mjpaul3/Portable-Plotter-Robot/README.md

# Portable-Plotter-Robot
ECE445 Project Team 34
