mjpaul3/Portable-Plotter-Robot/Notebooks/Sagnik Chakraborty/Sagnik3_notebook/src/entry_5.md

# Notebook Entry Lab 10/14/2024

## Objectives
- Order parts, get PCB design finalized

## Progress

#### 10/15 TA Meeting:
- We learned that multiple PCB orders are fine; we have enough time
- Target Round 1 hopefully
- Currently, we need to work on PCB
