mjpaul3/Portable-Plotter-Robot/Notebooks/Sagnik Chakraborty/Sagnik3_notebook/src/entry_7.md

# Notebook Entry Lab 10/28/2024

## Objectives
- order parts
- figma mockup of web board
- contact Gregg to get chassis done
- test motor

## Progress
- We received chassis from Gregg:

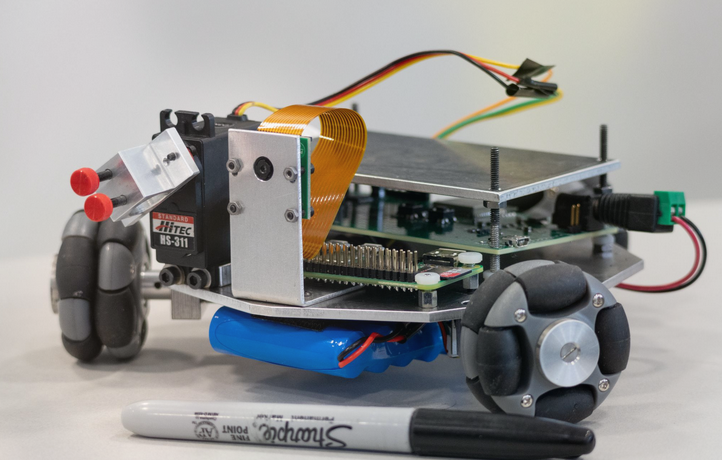
[picture p8: Notebooks/Sagnik Chakraborty/Sagnik3_notebook/src/image-7.png]


#### Next steps:
Get devboard work
