mjpaul3/Portable-Plotter-Robot/Notebooks/Sagnik Chakraborty/Sagnik3_notebook/src/chapter_1.md

# Notebook Entry Lab 9/20/2024

## Objectives
- Going to the machine shop, initial design to Gregg
- Understanding what kinds of motors we would need to use specifically
