mjpaul3/Portable-Plotter-Robot/Notebooks/Matthew Paul/Additional Assets/Aruco_distance_working.png

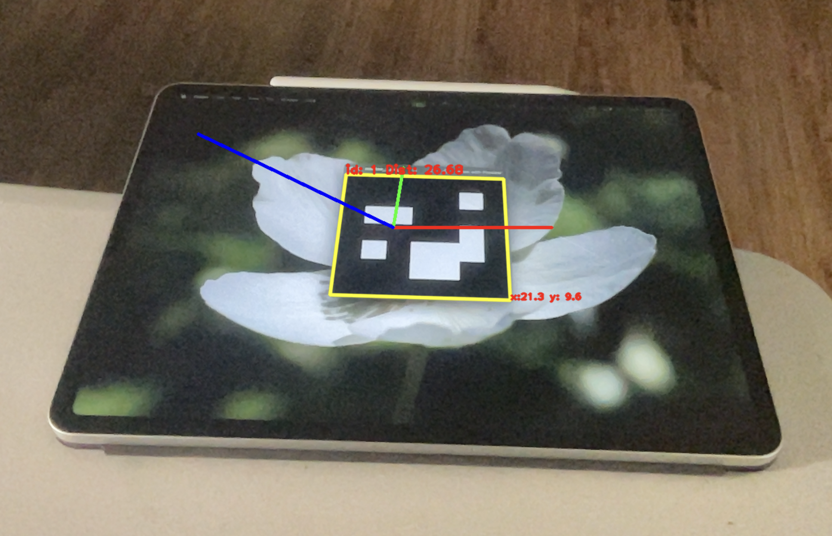
Notebooks/Matthew Paul/Additional Assets/Aruco_distance_working.png
