mjpaul3/Portable-Plotter-Robot/Notebooks/Matthew Paul/Additional Assets/Glitched_Camera.png

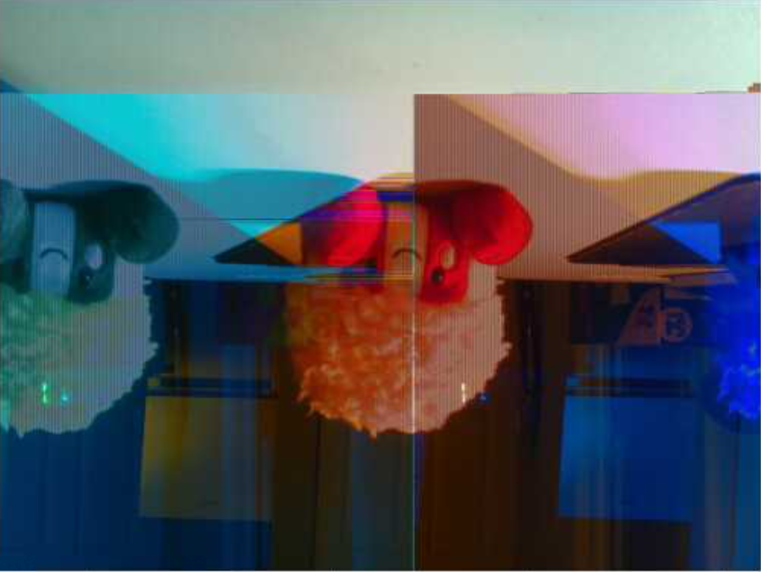
Notebooks/Matthew Paul/Additional Assets/Glitched_Camera.png
