mjpaul3/Portable-Plotter-Robot/Notebooks/Matthew Paul/Additional Assets/mechanical_1.jpg

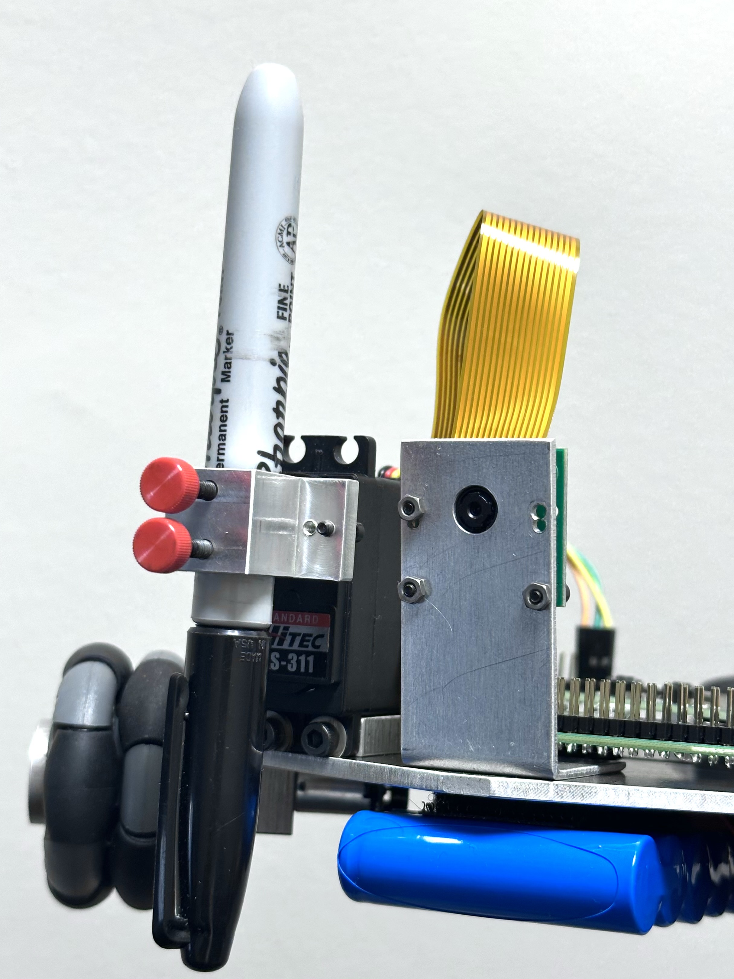
Notebooks/Matthew Paul/Additional Assets/mechanical_1.jpg
