mjpaul3/Portable-Plotter-Robot/Notebooks/Matthew Paul/Additional Assets/mechanical_2.jpg

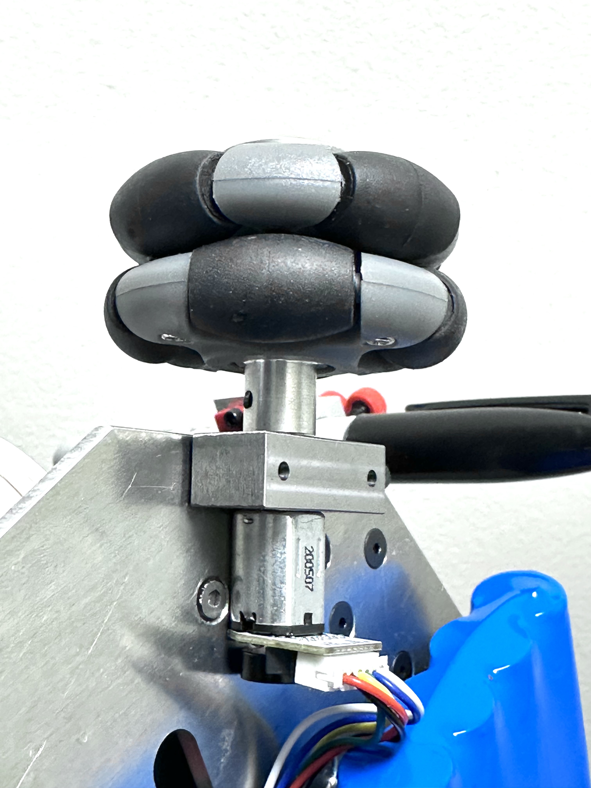
Notebooks/Matthew Paul/Additional Assets/mechanical_2.jpg
