mjpaul3/Portable-Plotter-Robot/Design Sources/Kicad Circuit and PCB Design/Imports/BMI323/BMI323.step

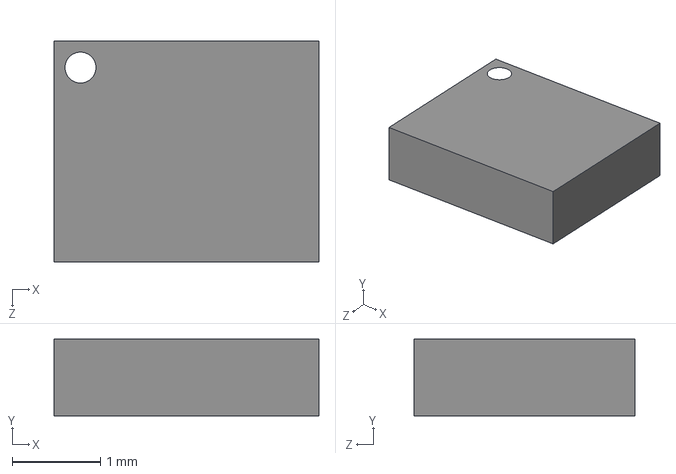
[picture p16: CAD file, 2024-12-12]
Design Sources/Kicad Circuit and PCB Design/Imports/BMI323/BMI323.step
3.00 x 0.87 x 2.50 mm
