mjpaul3/Portable-Plotter-Robot/Design Sources/Kicad Circuit and PCB Design/Imports/CP2102N_A02_GQFN28/CP2102N-A02-GQFN28.step

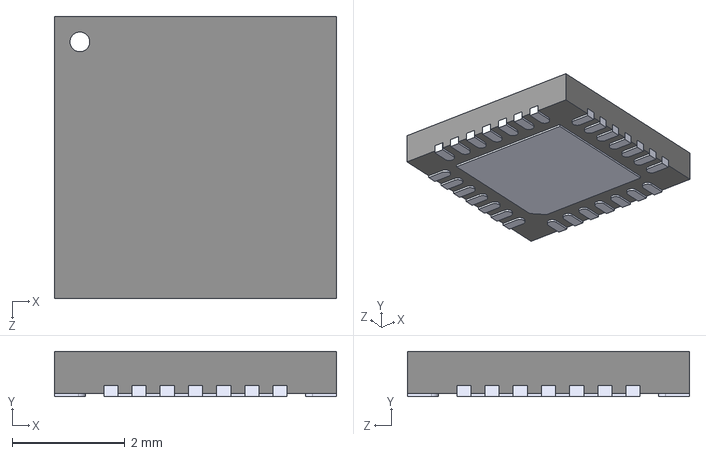
[picture p17: CAD file, 2024-12-12]
Design Sources/Kicad Circuit and PCB Design/Imports/CP2102N_A02_GQFN28/CP2102N-A02-GQFN28.step
5.00 x 0.8 x 5.00 mm
