mjpaul3/Portable-Plotter-Robot/Design Sources/Kicad Circuit and PCB Design/Imports/PJ_102AH/PJ-102AH.step

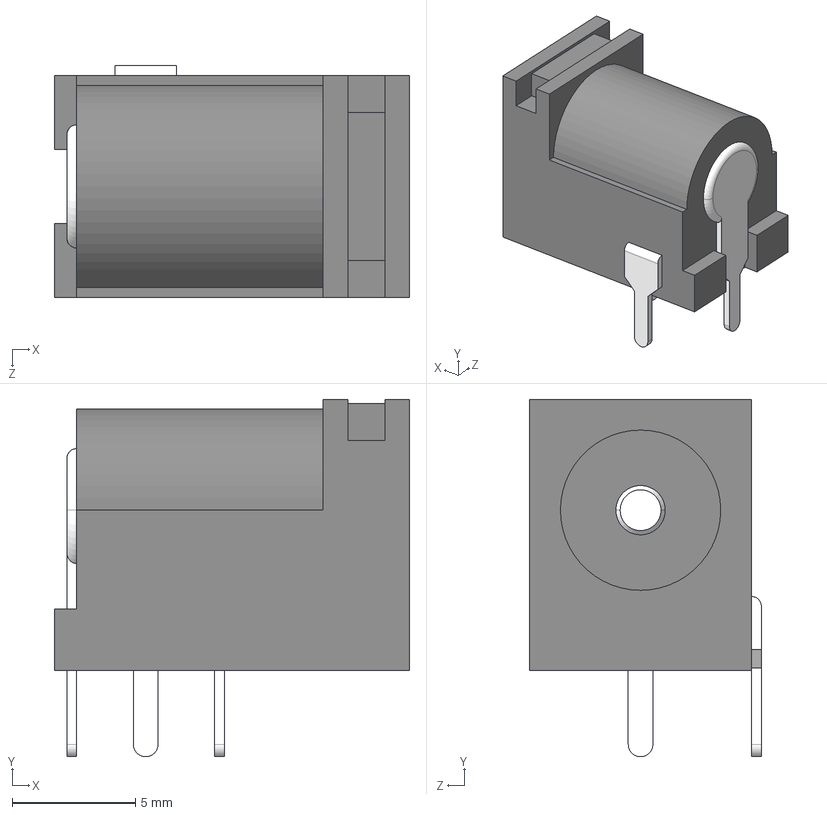
[picture p18: CAD file, 2024-12-12]
Design Sources/Kicad Circuit and PCB Design/Imports/PJ_102AH/PJ-102AH.step
14.4 x 14.5 x 9.40 mm
