mjpaul3/Portable-Plotter-Robot/Design Sources/Kicad Circuit and PCB Design/Imports/Through Hole Capacitor/860020672010/WCAP-ATG5_5X11.step

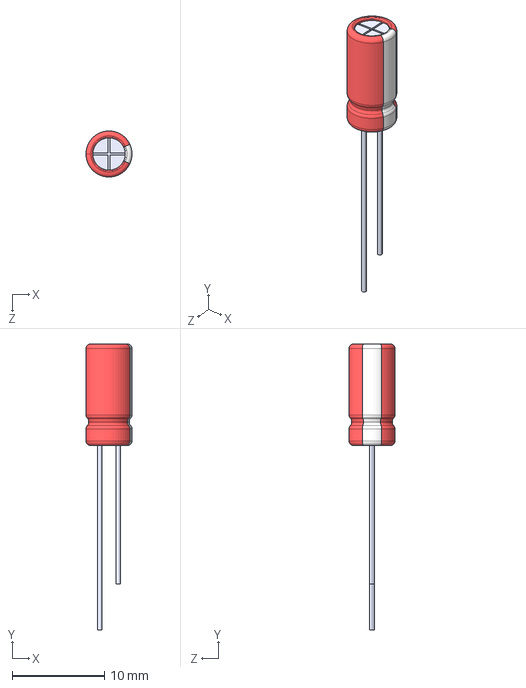
[picture p19: CAD file, 2024-12-12]
Design Sources/Kicad Circuit and PCB Design/Imports/Through Hole Capacitor/860020672010/WCAP-ATG5_5X11.step
5.00 x 31.0 x 5.00 mm
