mjpaul3/Portable-Plotter-Robot/Notebooks/Matthew Paul/Additional Assets/ECE445_plotter_robot_dimensions.pdf

## PCI

t | Battery

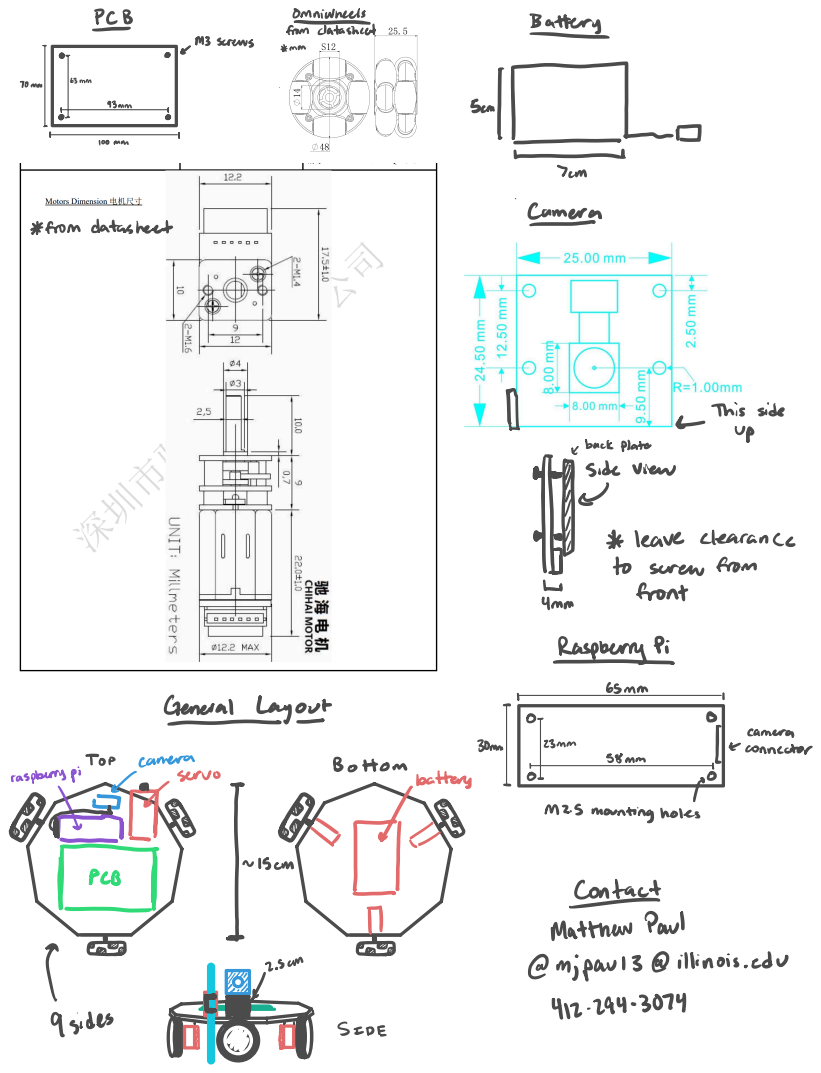
[picture p20: page 1]
M screws; lets ¹⁰⁰mm; This side up; Imm; front; Generally; Einer; raspberrypito Camesrvo; Bottom battery; m S mounting note B; risen; Intact; III; MatthewPaul; amjpaul3 illinois.edu; asides

Camera from datasheet

leave clearance
to screw from
