mjpaul3/Portable-Plotter-Robot/Notebooks/Matthew Paul/Additional Assets/Plotter_Rough_Schematic_v1.pdf

controlbox | faffffff

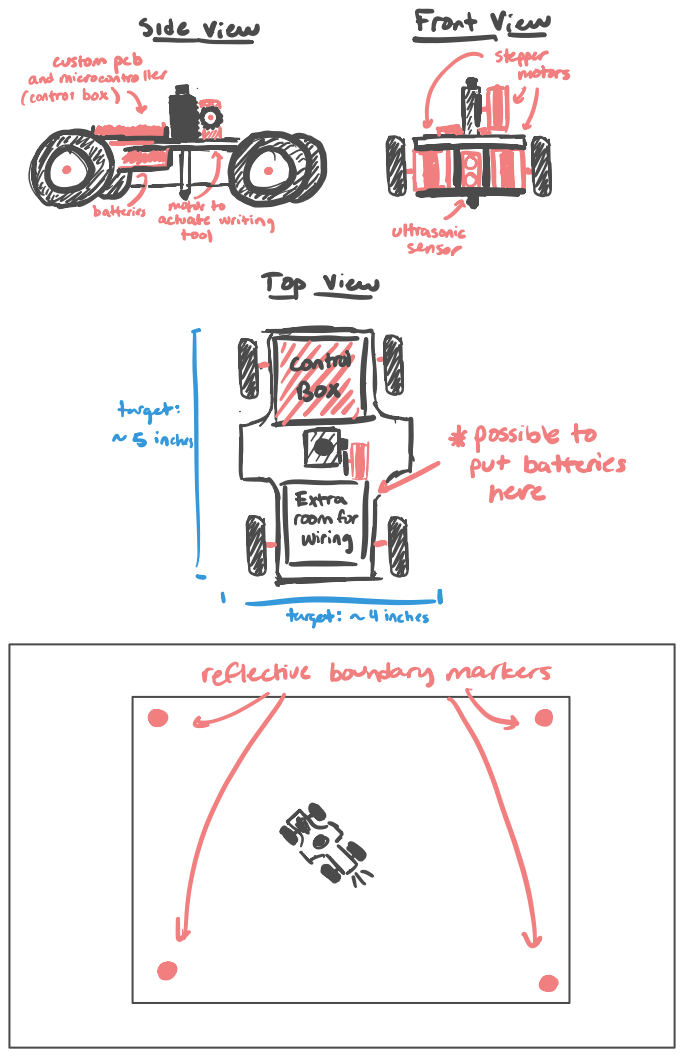
[picture p21: page 1]
sideries; twitter.info; andwm.fr; her; acififfwriting; ultrams; Iop View; 1 ff f itif; in put batteries here; tektites

ifII te i iti ffifoi.si statentiistith

ftp.ninches
reflective boundary markers
