mjpaul3/Portable-Plotter-Robot/Design Sources/Kicad Circuit and PCB Design/portable-plotter-robot.kicad_pcb

## KiCad design Design Sources/Kicad Circuit and PCB Design/portable-plotter-robot.kicad_pcb (2024-12-12)

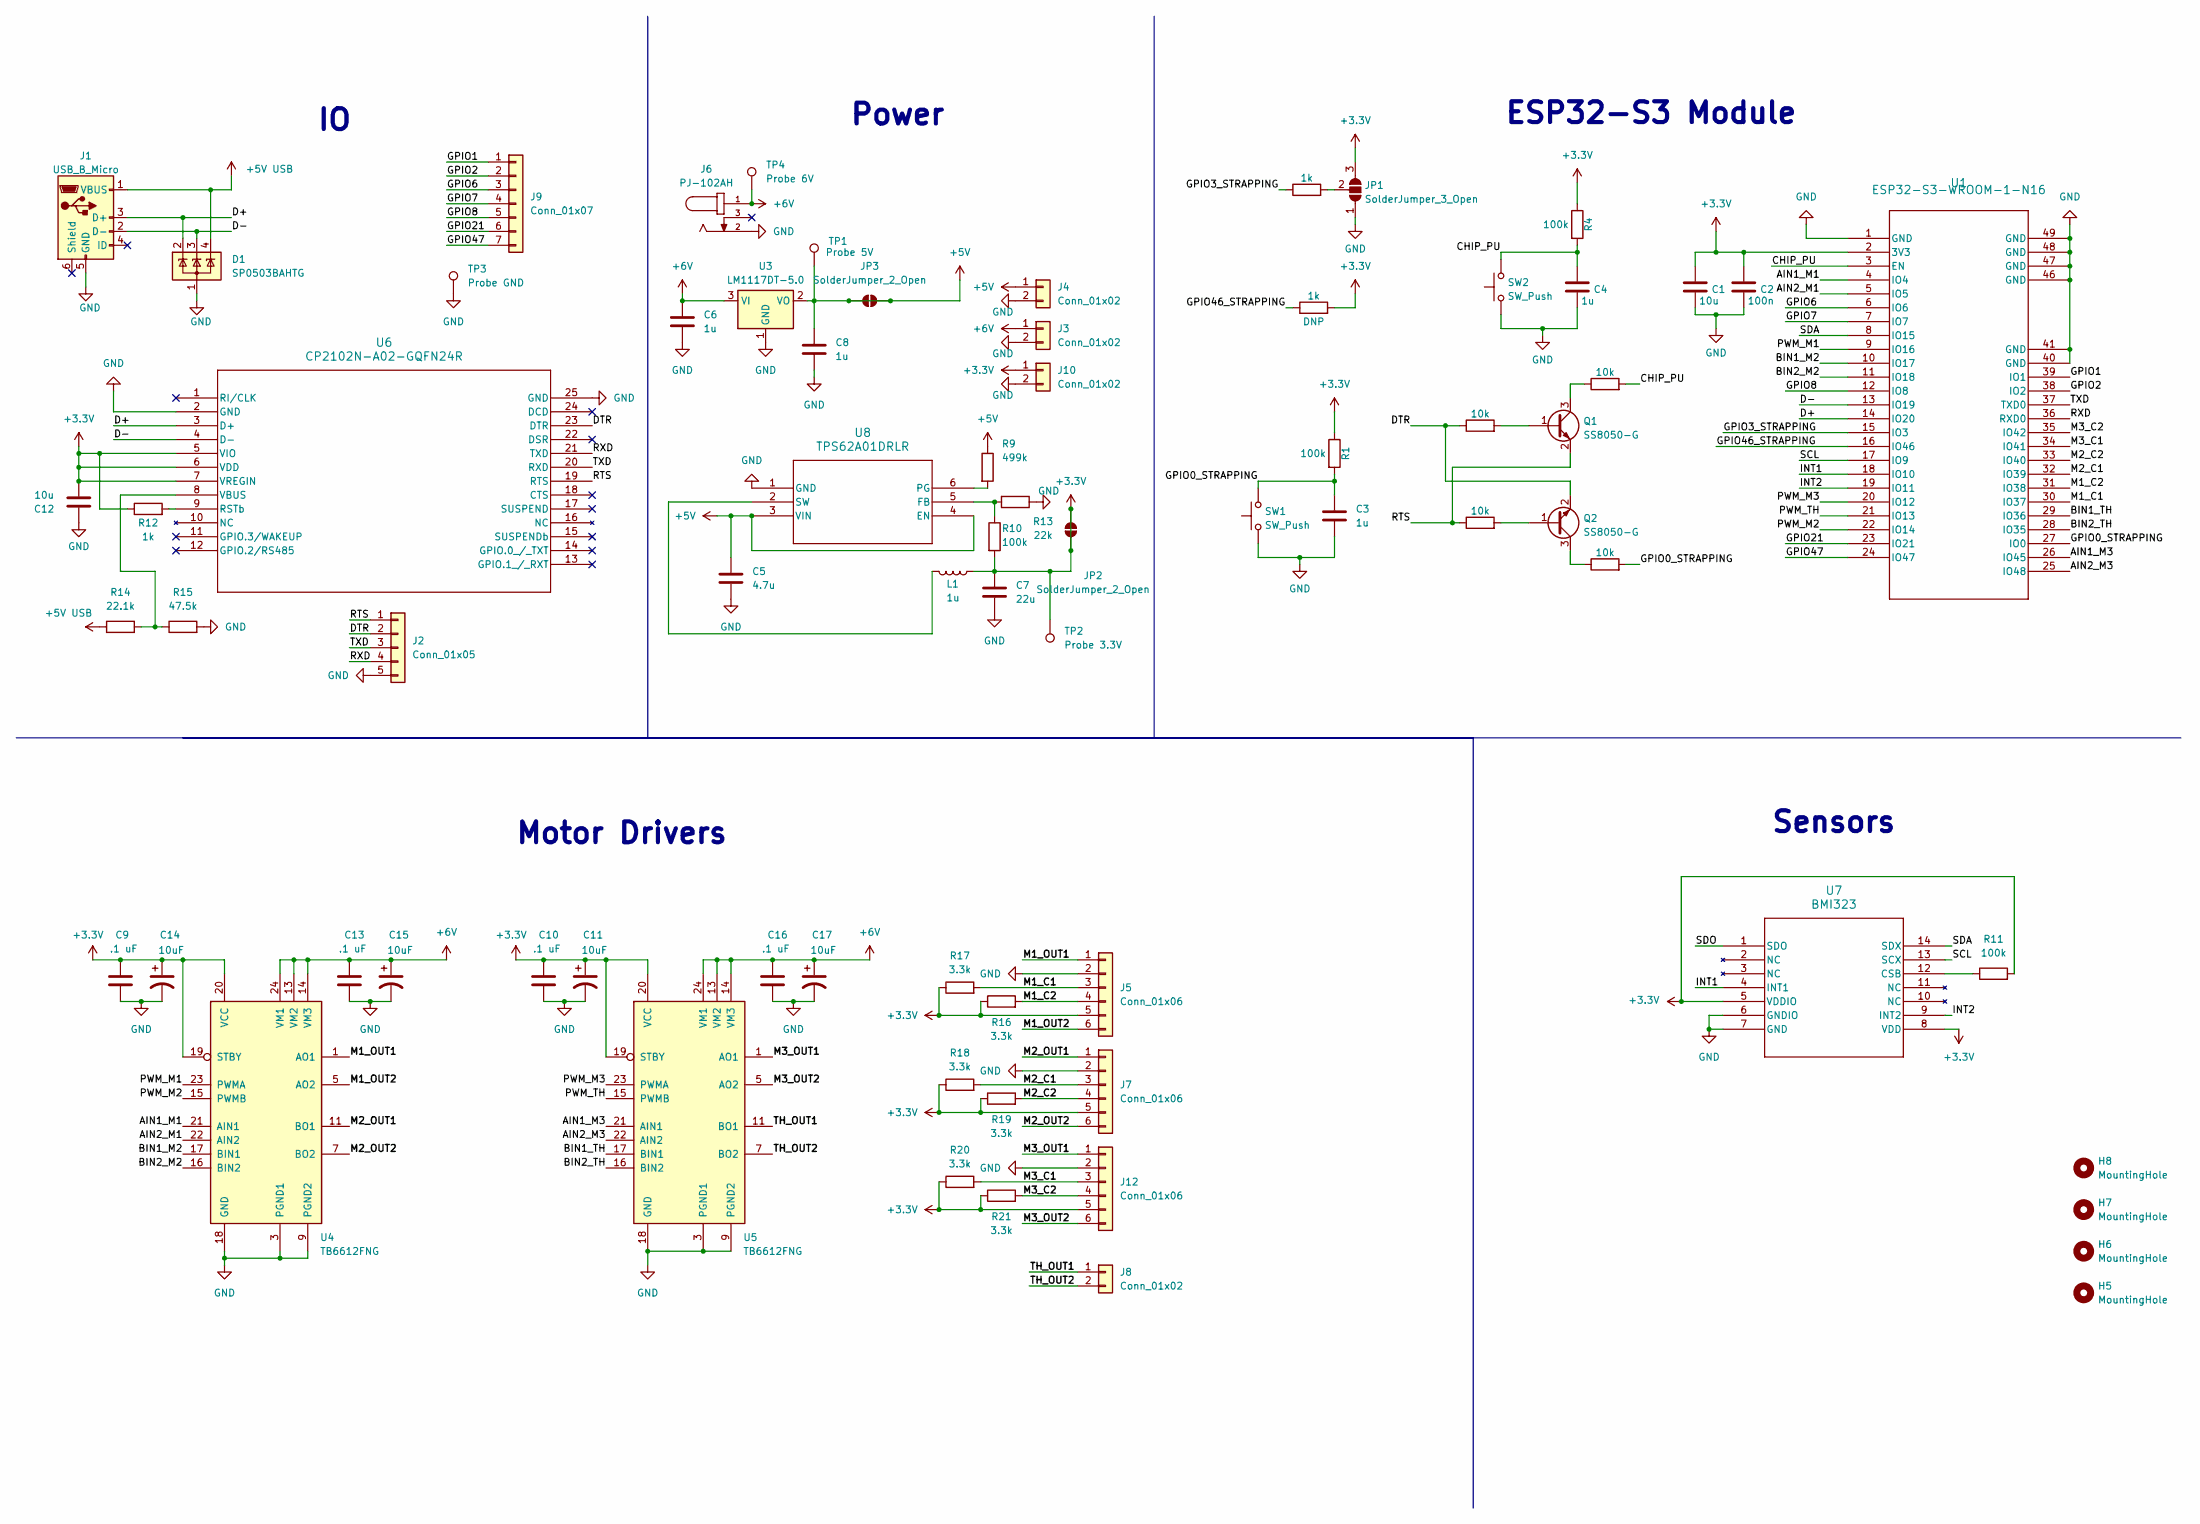
[picture p22: schematic portable-plotter-robot.kicad_sch, Portable Plotter Robot Circuit Schematic]

Parts:
C1, C12: 10u; C_0805_2012Metric_Pad1.18x1.45mm_HandSolder
C2: 100n; C_0805_2012Metric_Pad1.18x1.45mm_HandSolder
C3, C4, C6, C8: 1u; C_0805_2012Metric_Pad1.18x1.45mm_HandSolder
C5: 4.7u; C_0805_2012Metric_Pad1.18x1.45mm_HandSolder
C7: 22u; C_0805_2012Metric_Pad1.18x1.45mm_HandSolder
C9, C10, C13, C16: .1 uF; C_0805_2012Metric_Pad1.18x1.45mm_HandSolder
C11, C14, C15, C17: 10uF; CP_Radial_D5.0mm_P2.00mm
D1: SP0503BAHTG; SOT-143
H5, H6, H7, H8: MountingHole; MountingHole_3.2mm_M3
J1: USB_B_Micro; USB_Micro-B_Amphenol_10118194_Horizontal
J2: Conn_01x05; PinHeader_1x05_P2.54mm_Vertical
J3, J4, J8, J10: Conn_01x02; Molex_SL_171971-0002_1x02_P2.54mm_Vertical
J5, J7, J12: Conn_01x06; Molex_SL_171971-0006_1x06_P2.54mm_Vertical
J6: PJ-102AH; CUI_PJ-102AH; PART_REV 1.02
J9: Conn_01x07; PinHeader_1x07_P2.54mm_Vertical
JP1: SolderJumper_3_Open; SolderJumper-3_P1.3mm_Open_RoundedPad1.0x1.5mm
JP2, JP3: SolderJumper_2_Open; SolderJumper-2_P1.3mm_Open_RoundedPad1.0x1.5mm
L1: 1u; L_0805_2012Metric_Pad1.15x1.40mm_HandSolder
Q1, Q2: SS8050-G; SOT-23
R1, R4, R10, R11: 100k; R_0805_2012Metric_Pad1.20x1.40mm_HandSolder
R2, R3, R12: 1k; R_0805_2012Metric_Pad1.20x1.40mm_HandSolder
R5, R6, R7, R8: 10k; R_0805_2012Metric_Pad1.20x1.40mm_HandSolder
R9: 499k; R_0805_2012Metric_Pad1.20x1.40mm_HandSolder
R13: 22k; R_0805_2012Metric_Pad1.20x1.40mm_HandSolder
R14: 22.1k; R_0805_2012Metric_Pad1.20x1.40mm_HandSolder
R15: 47.5k; R_0805_2012Metric_Pad1.20x1.40mm_HandSolder
R16, R17, R18, R19, R20, R21: 3.3k; R_0805_2012Metric_Pad1.20x1.40mm_HandSolder
SW1, SW2: SW_Push; SW_Push_1P1T_NO_6x6mm_H9.5mm
TP1: Probe 5V; TestPoint_Plated_Hole_D2.0mm
TP2: Probe 3.3V; TestPoint_Plated_Hole_D2.0mm
TP3: Probe GND; TestPoint_Plated_Hole_D2.0mm
TP4: Probe 6V; TestPoint_Plated_Hole_D2.0mm
U1: ESP32-S3-WROOM-1-N16; ESP32-S3-WROOM-1_EXP
U3: LM1117DT-5.0; MP04A_TEX-M
U4, U5: TB6612FNG; SSOP-24_5.3x8.2mm_P0.65mm
U6: CP2102N-A02-GQFN24R; QFN24_SIL-M
U7: BMI323; XDCR_BMI270
U8: TPS62A01DRLR; SOT6_DRL_TEX-M

Connections:
+3.3V: C1.1, C2.1, C7.1, C9.1, C10.1, C11.1, C12.2, C14.1, J5.5, J7.5, J10.1, J12.5, JP1.3 (B), JP2.1 (A), JP2.2 (B), L1.1, R1.1, R3.2, R4.1, R10.2, R11.2, R12.1, R16.1, R17.1, R18.1, R19.1, R20.1, R21.1, TP2.1, U1.2 (3V3), U4.19 (STBY), U4.20 (VCC), U5.19 (STBY), U5.20 (VCC), U6.5 (VIO), U6.6 (VDD), U6.7 (VREGIN), U7.5 (VDDIO), U7.8 (VDD)
+5V: C5.1, C8.1, J4.1, JP3.1 (A), JP3.2 (B), R9.1, TP1.1, U3.2 (VO), U8.3 (VIN), U8.4 (EN)
+5V USB: D1.4 (K), J1.1 (VBUS), R14.1
+6V: C6.1, C13.1, C15.1, C16.1, C17.1, J3.1, J6.1, TP4.1, U3.3 (VI), U4.13 (VM2), U4.14 (VM3), U4.24 (VM1), U5.13 (VM2), U5.14 (VM3), U5.24 (VM1)
/AIN1_M1: U1.4 (IO4), U4.21 (AIN1)
/AIN1_M3: U1.26 (IO45), U5.21 (AIN1)
/AIN2_M1: U1.5 (IO5), U4.22 (AIN2)
/AIN2_M3: U1.25 (IO48), U5.22 (AIN2)
/BIN1_M2: U1.10 (IO17), U4.17 (BIN1)
/BIN1_TH: U1.29 (IO36), U5.17 (BIN1)
/BIN2_M2: U1.11 (IO18), U4.16 (BIN2)
/BIN2_TH: U1.28 (IO35), U5.16 (BIN2)
/CHIP_PU: C4.1, R4.2, R7.2, SW2.2, U1.3 (EN)
/D+: D1.2 (K), J1.3 (D+), U1.14 (IO20), U6.3 (D+)
/D-: D1.3 (K), J1.2 (D-), U1.13 (IO19), U6.4 (D-)
/DTR: J2.2, Q2.2 (E), R5.1, U6.23 (DTR)
/GPIO0_STRAPPING: C3.1, R1.2, R8.2, SW1.2, U1.27 (IO0)
/GPIO1: J9.1, U1.39 (IO1)
/GPIO2: J9.2, U1.38 (IO2)
/GPIO3_STRAPPING: R2.1, U1.15 (IO3)
/GPIO6: J9.3, U1.6 (IO6)
/GPIO7: J9.4, U1.7 (IO7)
/GPIO8: J9.5, U1.12 (IO8)
/GPIO21: J9.6, U1.23 (IO21)
/GPIO46_STRAPPING: R3.1, U1.16 (IO46)
/GPIO47: J9.7, U1.24 (IO47)
/INT1: U1.18 (IO10), U7.4 (INT1)
/INT2: U1.19 (IO11), U7.9 (INT2)
/M1_C1: J5.3, R17.2, U1.30 (IO37)
/M1_C2: J5.4, R16.2, U1.31 (IO38)
/M1_OUT1: J5.1, U4.1 (AO1), U4.2 (AO1)
/M1_OUT2: J5.6, U4.5 (AO2), U4.6 (AO2)
/M2_C1: J7.3, R18.2, U1.32 (IO39)
/M2_C2: J7.4, R19.2, U1.33 (IO40)
/M2_OUT1: J7.1, U4.11 (BO1), U4.12 (BO1)
/M2_OUT2: J7.6, U4.7 (BO2), U4.8 (BO2)
/M3_C1: J12.3, R20.2, U1.34 (IO41)
/M3_C2: J12.4, R21.2, U1.35 (IO42)
/M3_OUT1: J12.1, U5.1 (AO1), U5.2 (AO1)
/M3_OUT2: J12.6, U5.5 (AO2), U5.6 (AO2)
/PWM_M1: U1.9 (IO16), U4.23 (PWMA)
/PWM_M2: U1.22 (IO14), U4.15 (PWMB)
/PWM_M3: U1.20 (IO12), U5.23 (PWMA)
/PWM_TH: U1.21 (IO13), U5.15 (PWMB)
/RTS: J2.1, Q1.2 (E), R6.1, U6.19 (RTS)
/RXD: J2.4, U1.36 (RXD0), U6.21 (TXD)
/SCL: U1.17 (IO9), U7.13 (SCX)
/SDA: U1.8 (IO15), U7.14 (SDX)
/SDO: U7.1 (SDO)
/TH_OUT1: J8.1, U5.11 (BO1), U5.12 (BO1)
/TH_OUT2: J8.2, U5.7 (BO2), U5.8 (BO2)
/TXD: J2.3, U1.37 (TXD0), U6.20 (RXD)
GND: C1.2, C2.2, C3.2, C4.2, C5.2, C6.2, C7.2, C8.2, C9.2, C10.2, C11.2, C12.1, C13.2, C14.2, C15.2, C16.2, C17.2, D1.1 (A), J1.5 (GND), J2.5, J3.2, J4.2, J5.2, J6.2, J7.2, J10.2, J12.2, JP1.1 (A), R13.1, R15.2, SW1.1, SW2.1, TP3.1, U1.1 (GND), U1.40 (GND), U1.41 (GND), U1.46 (GND), U1.47 (GND), U1.48 (GND), U1.49 (GND), U3.1 (GND), U4.3 (PGND1), U4.4 (PGND1), U4.9 (PGND2), U4.10 (PGND2), U4.18 (GND), U5.3 (PGND1), U5.4 (PGND1), U5.9 (PGND2), U5.10 (PGND2), U5.18 (GND), U6.2 (GND), U6.25 (GND), U7.6 (GNDIO), U7.7 (GND), U8.1 (GND)
unnamed: JP1.2 (C), R2.2
unnamed: Q1.1 (B), R5.2
unnamed: Q1.3 (C), R7.1
unnamed: Q2.1 (B), R6.2
unnamed: Q2.3 (C), R8.1
unnamed: R12.2, U6.9 (RSTb)
unnamed: R14.2, R15.1, U6.8 (VBUS)
unnamed: R11.1, U7.12 (CSB)
unnamed: R10.1, R13.2, U8.5 (FB)
unnamed: R9.2, U8.6 (PG)
unnamed: L1.2, U8.2 (SW)

Notes on the sheet:
Power
Sensors
Motor Drivers
ESP32-S3 Module

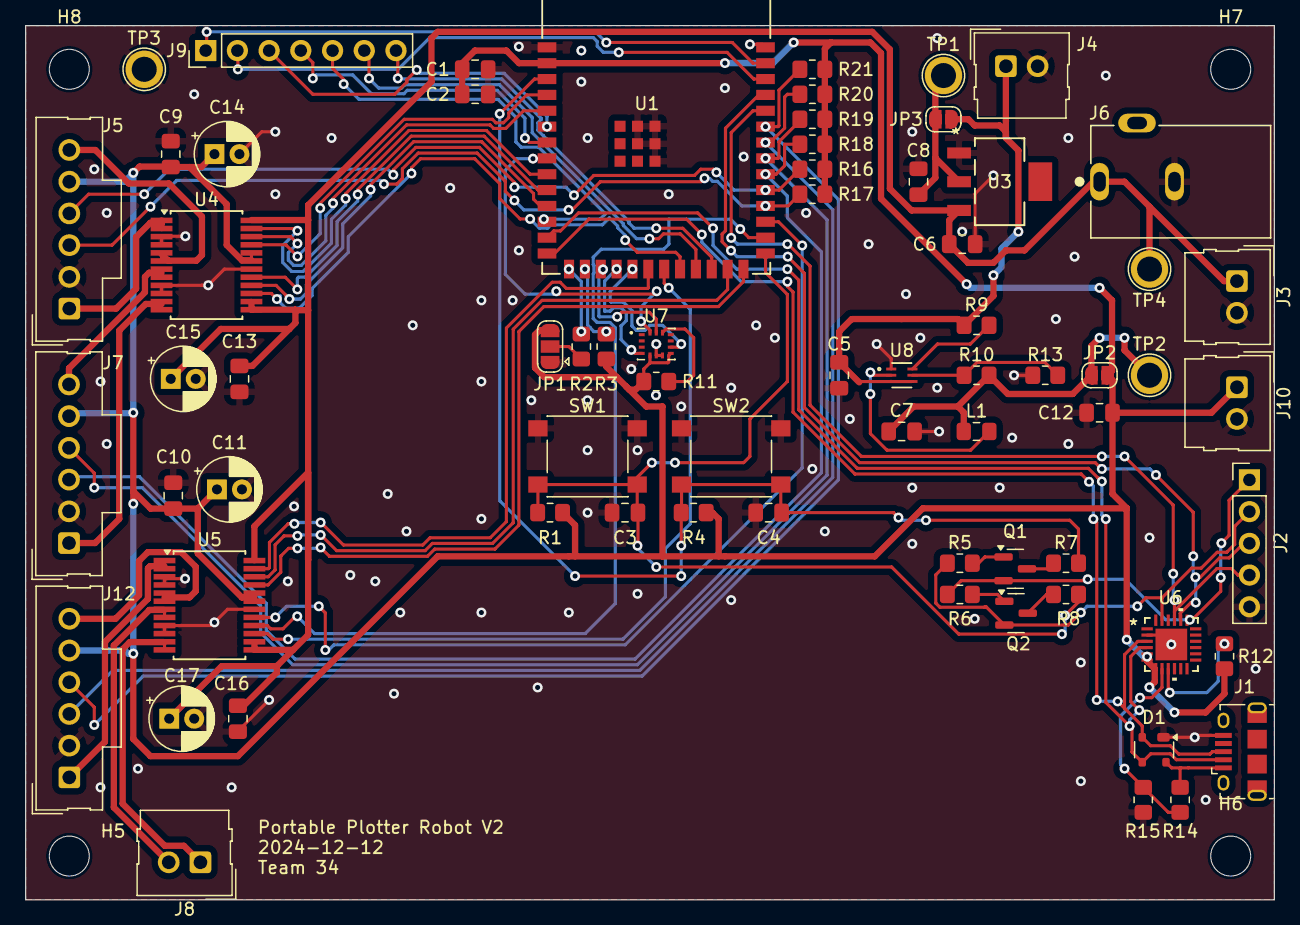
[picture p23: board portable-plotter-robot.kicad_pcb from above]

Board: 2 copper layers, 100.0 x 70.0 mm, 73 parts (0 on the bottom side), 63 nets.
