mjpaul3/Portable-Plotter-Robot/Notebooks/Sagnik Chakraborty/Sagnik3_notebook/book/searchindex.js

Object.assign(window.search, {"doc_urls":["entry_1.html#notebook-entry-lab-week-of-9162024","entry_1.html#objectives","entry_1.html#progress","entry_1.html#ta-meeting-917","entry_2.html#notebook-entry-lab-9232024","entry_2.html#objectives","entry_2.html#progress","entry_3.html#notebook-entry-lab-9302024","entry_3.html#objectives","entry_3.html#progress","entry_3.html#ta-meeting-101","entry_3.html#103-schedule-fixing","entry_4.html#notebook-entry-lab-10072024","entry_4.html#objectives","entry_4.html#progress","entry_4.html#next-steps","entry_5.html#notebook-entry-lab-10142024","entry_5.html#objectives","entry_5.html#progress","entry_6.html#notebook-entry-lab-10212024","entry_6.html#objectives","entry_6.html#progress","entry_6.html#next-steps","entry_7.html#notebook-entry-lab-10282024","entry_7.html#objectives","entry_7.html#progress","entry_8.html#notebook-entry-lab-110424","entry_8.html#objectives","entry_8.html#progress","entry_8.html#next-steps","entry_9.html#notebook-entry-lab-111124","entry_9.html#objectives","entry_9.html#progress","entry_9.html#next-steps","entry_10.html#notebook-entry-lab-111824","entry_10.html#objectives","entry_10.html#progress","entry_10.html#code-explanation","entry_10.html#observations","entry_10.html#debugging-and-improvements","entry_10.html#future-steps","entry_11.html#notebook-entry-lab-112524","entry_11.html#objectives","entry_11.html#progress","entry_11.html#kinematics-model","entry_11.html#pid-model","entry_11.html#mathematical-breakdown","entry_11.html#issue","entry_12.html#notebook-entry-lab-120224","entry_12.html#objectives","entry_12.html#progress","entry_12.html#additional-notes-for-debugging","entry_12.html#issues"],"index":{"documentStore":{"docInfo":{"0":{"body":0,"breadcrumbs":9,"title":5},"1":{"body":11,"breadcrumbs":5,"title":1},"10":{"body":39,"breadcrumbs":7,"title":3},"11":{"body":20,"breadcrumbs":7,"title":3},"12":{"body":0,"breadcrumbs":8,"title":4},"13":{"body":14,"breadcrumbs":5,"title":1},"14":{"body":115,"breadcrumbs":5,"title":1},"15":{"body":19,"breadcrumbs":6,"title":2},"16":{"body":0,"breadcrumbs":8,"title":4},"17":{"body":5,"breadcrumbs":5,"title":1},"18":{"body":18,"breadcrumbs":5,"title":1},"19":{"body":0,"breadcrumbs":8,"title":4},"2":{"body":39,"breadcrumbs":5,"title":1},"20":{"body":32,"breadcrumbs":5,"title":1},"21":{"body":176,"breadcrumbs":5,"title":1},"22":{"body":28,"breadcrumbs":6,"title":2},"23":{"body":0,"breadcrumbs":8,"title":4},"24":{"body":12,"breadcrumbs":5,"title":1},"25":{"body":9,"breadcrumbs":5,"title":1},"26":{"body":0,"breadcrumbs":8,"title":4},"27":{"body":11,"breadcrumbs":5,"title":1},"28":{"body":72,"breadcrumbs":5,"title":1},"29":{"body":22,"breadcrumbs":6,"title":2},"3":{"body":148,"breadcrumbs":7,"title":3},"30":{"body":0,"breadcrumbs":8,"title":4},"31":{"body":27,"breadcrumbs":5,"title":1},"32":{"body":136,"breadcrumbs":5,"title":1},"33":{"body":24,"breadcrumbs":6,"title":2},"34":{"body":0,"breadcrumbs":8,"title":4},"35":{"body":20,"breadcrumbs":5,"title":1},"36":{"body":26,"breadcrumbs":5,"title":1},"37":{"body":189,"breadcrumbs":6,"title":2},"38":{"body":32,"breadcrumbs":5,"title":1},"39":{"body":48,"breadcrumbs":6,"title":2},"4":{"body":0,"breadcrumbs":8,"title":4},"40":{"body":19,"breadcrumbs":6,"title":2},"41":{"body":0,"breadcrumbs":8,"title":4},"42":{"body":5,"breadcrumbs":5,"title":1},"43":{"body":0,"breadcrumbs":5,"title":1},"44":{"body":67,"breadcrumbs":6,"title":2},"45":{"body":61,"breadcrumbs":6,"title":2},"46":{"body":55,"breadcrumbs":6,"title":2},"47":{"body":22,"breadcrumbs":5,"title":1},"48":{"body":0,"breadcrumbs":8,"title":4},"49":{"body":18,"breadcrumbs":5,"title":1},"5":{"body":11,"breadcrumbs":5,"title":1},"50":{"body":225,"breadcrumbs":5,"title":1},"51":{"body":45,"breadcrumbs":7,"title":3},"52":{"body":26,"breadcrumbs":5,"title":1},"6":{"body":59,"breadcrumbs":5,"title":1},"7":{"body":0,"breadcrumbs":8,"title":4},"8":{"body":9,"breadcrumbs":5,"title":1},"9":{"body":38,"breadcrumbs":5,"title":1}},"docs":{"0":{"body":"","breadcrumbs":"Entry 1 - Week of 9/16/24 » Notebook Entry Lab Week of 9/16/2024","id":"0","title":"Notebook Entry Lab Week of 9/16/2024"},"1":{"body":"First TA meeting with dongming Went over our project proposal, what to include in design review1","breadcrumbs":"Entry 1 - Week of 9/16/24 » Objectives","id":"1","title":"Objectives"},"10":{"body":"Main deadline is to sign up for peer review by tomorrow (10/2) Requirements/Values not specified sufficiently yet, so we needed to fix that Our current schematic model wasn't enough, so we needed to specify more; for instance, our IO interface wasn't properly addressed and we didn't attach the correct footprint yet: alt text Main todo: create slideshow for design review","breadcrumbs":"Entry 3 - Week of 9/30/24 » TA meeting 10/1","id":"10","title":"TA meeting 10/1"},"11":{"body":"All we did here was fix out our schedule that we will use; this was mainly to brainstorm our workflow We added details to design doc Understand software testing/debugging workflow; here I decided that we will use PID","breadcrumbs":"Entry 3 - Week of 9/30/24 » 10/3: Schedule fixing","id":"11","title":"10/3: Schedule fixing"},"12":{"body":"","breadcrumbs":"Entry 4 - Week of 10/07/24 » Notebook Entry Lab 10/07/2024","id":"12","title":"Notebook Entry Lab 10/07/2024"},"13":{"body":"Begin PCB design calculations for PCB review. Perform power analytics calculations to ensure all subsystems are properly powered.","breadcrumbs":"Entry 4 - Week of 10/07/24 » Objectives","id":"13","title":"Objectives"},"14":{"body":"10/11 meeting: PCB Design Calculations : Reviewed the application circuit for the TPS62140DCLR voltage regulator. Calculated resistor divider values (R1 and R2) to achieve an output voltage (Vout) of 3.3V. Used the formula: Vout=1.2×(1+R1R2) Result: R1=100kΩ R2=450kΩ Verified that the selected capacitor values meet the TPS62140DCLR's application guidelines. Power Subsystem Analysis : Measured current requirements for each subsystem: ESP32 : 300mA. Plotter Car Control Subsystem : 500mA. Motor Subsystem : Calculated based on servo and DC motor driver requirements. Ensured the battery and voltage regulator could supply sufficient current for all subsystems under peak load conditions. Updated Block Diagram : Created a detailed block diagram to map the power flow and subsystem interconnections. Incorporated feedback from previous TA meetings to ensure all connections were labeled clearly. Component Placement Considerations : Added a C3 optional capacitor to reduce noise in the power line. Verified placement for efficient routing of power and signal lines, especially for the ESP32 and motor drivers.","breadcrumbs":"Entry 4 - Week of 10/07/24 » Progress","id":"14","title":"Progress"},"15":{"body":"Finalize the PCB layout for review, focusing on minimizing noise and ensuring reliable connections. Simulate the power system under various loads to confirm voltage stability.","breadcrumbs":"Entry 4 - Week of 10/07/24 » Next Steps","id":"15","title":"Next Steps"},"16":{"body":"","breadcrumbs":"Entry 5 - Week of 10/14/24 » Notebook Entry Lab 10/14/2024","id":"16","title":"Notebook Entry Lab 10/14/2024"},"17":{"body":"Order parts, get PCB design finalized","breadcrumbs":"Entry 5 - Week of 10/14/24 » Objectives","id":"17","title":"Objectives"},"18":{"body":"10/15 TA Meeting: We learned that multiple PCB orders are fine; we have enough time Target Round 1 hopefully Currently, we need to work on PCB","breadcrumbs":"Entry 5 - Week of 10/14/24 » Progress","id":"18","title":"Progress"},"19":{"body":"","breadcrumbs":"Entry 6 - Week of 10/21/24 » Notebook Entry Lab 10/21/2024","id":"19","title":"Notebook Entry Lab 10/21/2024"},"2":{"body":"Discussed initial project ideas and received feedback on scope and feasibility. Noted requirements for the design review presentation, including subsystem specifications and tolerance analysis. We also started on figuring out final design templates so that next week we can talk it over with Gregg This was the block diagram we used (courtesy of my partner mjpaul3) for discussion this week: alt text","breadcrumbs":"Entry 1 - Week of 9/16/24 » Progress","id":"2","title":"Progress"},"20":{"body":"Count and finalize components for ordering, including resistors, capacitors, and inductors. Prepare the PCB design with necessary footprints for all components. Begin testing motor drivers and Raspberry Pi camera functionality. Develop and refine the ESP32 Wi-Fi interface and connections for edge-of-board placement.","breadcrumbs":"Entry 6 - Week of 10/21/24 » Objectives","id":"20","title":"Objectives"},"21":{"body":"Component Selection for PCB : Identified required values for resistors, capacitors, and inductors: Capacitors: 10μF, 1μF, 4.7μF, 27μF, 180μF. Resistors: 22Ω, 100kΩ, 49.9kΩ, 1kΩ, 10kΩ. Inductors: 1μH. Included electrolytic capacitors for critical filtering applications, particularly 10μF. PCB Preparation : Reviewed the placement of IO, power, ESP32, motor drivers, and sensors on the PCB layout. Noted pin configurations to optimize edge-of-board connectivity and simplify wiring during assembly. Exported necessary component footprints for use in PCB design software. From TA 10/22 meeting: PCB V1 seemed good; it's just that the PCB footprint had the ESP32 wifi antennae on board; this might cause issues Motor Driver Testing : Began testing the motor drivers using the ESP32. Confirmed basic operation with servo motors. Encountered minor issues with pin connections, which were resolved during setup. Raspberry Pi Camera Testing : Tested the Raspberry Pi camera for position data integration. Results were satisfactory, with clear image captures and reliable interfacing. Ensured compatibility with IMU for future position data calculations. ESP32 Wi-Fi Interface : Started developing the ESP32 Wi-Fi interface, focusing on stability for communication with the web app. Ensured basic functionality to handle commands such as shape selection. Planning for Next Week : Outlined steps for Week 10/27: Finalize ordering of components. Develop a web board mockup. Continue testing motors and their integration with the ESP32. Work on programming ESP32 for advanced motor functions and servo tool control.","breadcrumbs":"Entry 6 - Week of 10/21/24 » Progress","id":"21","title":"Progress"},"22":{"body":"Complete the PCB layout and simulate the power subsystem to ensure stability under load. Continue testing the motor drivers and refine motor control algorithms. Work on integrating the Raspberry Pi camera with the web app for position data feedback.","breadcrumbs":"Entry 6 - Week of 10/21/24 » Next Steps","id":"22","title":"Next Steps"},"23":{"body":"","breadcrumbs":"Entry 7 - Week of 10/28/24 » Notebook Entry Lab 10/28/2024","id":"23","title":"Notebook Entry Lab 10/28/2024"},"24":{"body":"order parts figma mockup of web board contact Gregg to get chassis done test motor","breadcrumbs":"Entry 7 - Week of 10/28/24 » Objectives","id":"24","title":"Objectives"},"25":{"body":"We received chassis from Gregg: alt text Next steps: Get devboard work","breadcrumbs":"Entry 7 - Week of 10/28/24 » Progress","id":"25","title":"Progress"},"26":{"body":"","breadcrumbs":"Entry 8 - Week of 11/04/24 » Notebook Entry Lab 11/04/24","id":"26","title":"Notebook Entry Lab 11/04/24"},"27":{"body":"Address feedback on PCB design. Make necessary changes to improve the PCB layout and functionality.","breadcrumbs":"Entry 8 - Week of 11/04/24 » Objectives","id":"27","title":"Objectives"},"28":{"body":"The following changes were made to the PCB design based on feedback received: Moved the ESP32 to the edge of the board to facilitate easier connections. Corrected the footprint for the 6-5V power supply and UART bridge . Added power connections for the Raspberry Pi . Included test points on the PCB for debugging and monitoring. Added encoder connections for the motors to support precise feedback. Ordered additional buttons for control purposes. Exported pins for the ESP32 and UART for extended connectivity. Added Raspberry Pi GPIO pins to support interfacing. alt text These changes ensure that the PCB layout supports all system components effectively and meets the design requirements.","breadcrumbs":"Entry 8 - Week of 11/04/24 » Progress","id":"28","title":"Progress"},"29":{"body":"Begin testing the updated PCB with connected components. Verify the functionality of the newly added encoder connections and Raspberry Pi GPIO pins. Ensure that all exported pins are accessible and working as intended.","breadcrumbs":"Entry 8 - Week of 11/04/24 » Next Steps","id":"29","title":"Next Steps"},"3":{"body":"During the TA meeting, the following feedback and action items were discussed for the design document: Design Document Feedback: Clearly labeled the problem and solution sections for better clarity. Added visual aids and ensured the overall design was presented at a high level . Updated the block diagram : Labeled all lines properly to indicate signal flow. Used appropriate software tools to create a clean and professional diagram. Provided a subsystem overview , detailing each component's role. Outlined subsystem requirements to meet functional and performance goals. Tolerance Analysis: Included proof of design tolerances : Calculated motor torque requirements to handle the expected load. Verified the battery's capacity to ensure sufficient power for the system. Conducted directional calculations to ensure the robot's motion is within the desired limits. Ethics and Safety: Documented potential safety concerns and proposed mitigation strategies. Compiled a reference page with citations for all sources used in the design. Examples for Reference: Used SP 2024 Team 19's TA Feedback and FA 2023 Team 3's Design Document as examples of strong documentation. Next Steps Finalize updates to the block diagram and integrate them into the design document. Conduct additional testing to validate motor torque and battery capacity calculations. Prepare the design document for the next TA review session.","breadcrumbs":"Entry 1 - Week of 9/16/24 » TA meeting 9/17","id":"3","title":"TA meeting 9/17"},"30":{"body":"","breadcrumbs":"Entry 9 - Week of 11/11/24 » Notebook Entry Lab 11/11/24","id":"30","title":"Notebook Entry Lab 11/11/24"},"31":{"body":"Finalize motor identification and connections for the control system. Update the parts list with the required capacitors, resistors, and inductors for PCB design. Review and refine the general layout of the robot components, including battery, Raspberry Pi, and servo placement.","breadcrumbs":"Entry 9 - Week of 11/11/24 » Objectives","id":"31","title":"Objectives"},"32":{"body":"Motor Identification and Wiring : Identified motor pins and their corresponding connections: OUT1, OUT2, and OUT3 mapped to motor output pins. CF1 and CF2 for current feedback. 3.3V and GND for power. Verified the PWM signals from the controller and reviewed the output waveform for consistency with the desired motor behavior. Updated Parts List : Capacitors (C): 10μF, 1μF, 4.7μF, 21μF. Resistors (R): 1kΩ, 22.1kΩ, 47.5kΩ, 494kΩ, 100kΩ, 10kΩ, 3.3kΩ. Inductors (L): 1μH. Verified counts and confirmed all necessary components are available for assembly. Component Layout : Completed a detailed layout of the robot: General layout includes the top and bottom placements. Raspberry Pi mounted at the top alongside the servo for camera movement. PCB and battery located at the bottom for weight distribution. Ensured all components are securely mounted with proper clearance for screws and accessibility. (diagrams courtesy of partner mjpaul3) alt text alt text Design Dimensions : Referenced motor dimensions and wheel configurations directly from the datasheets. Integrated omniwheels and servo clearances into the layout to ensure smooth operation. Battery and Power Connections : Finalized the battery placement and connections. Ensured compatibility with power regulators and designed for easy accessibility during operation.","breadcrumbs":"Entry 9 - Week of 11/11/24 » Progress","id":"32","title":"Progress"},"33":{"body":"Test the motor drivers and PWM control to confirm functionality with the updated connections. Begin assembling the robot with the finalized layout and components. Simulate and verify power stability across all subsystems before moving to integrated testing.","breadcrumbs":"Entry 9 - Week of 11/11/24 » Next Steps","id":"33","title":"Next Steps"},"34":{"body":"","breadcrumbs":"Entry 10 - Week of 11/18/24 » Notebook Entry Lab 11/18/24","id":"34","title":"Notebook Entry Lab 11/18/24"},"35":{"body":"Set up a test bench on the development board for basic servo motor control code. Verify the functionality of servo motor control using PWM signals with an ESP32.","breadcrumbs":"Entry 10 - Week of 11/18/24 » Objectives","id":"35","title":"Objectives"},"36":{"body":"This week, I focused on implementing and testing servo motor control using an ESP32 development board. The servo was controlled through a PWM signal configured with a 50Hz frequency and 14-bit resolution. Below are the key components of the implementation:","breadcrumbs":"Entry 10 - Week of 11/18/24 » Progress","id":"36","title":"Progress"},"37":{"body":"1. Pin Configuration The servo was connected to GPIO 13. Additionally, GPIOs 36, 35, and 1 were set to always output HIGH to stabilize auxiliary components. // Pin definitions\n#define SERVO_PIN 13\n#define SERVO_HIGH_1 36\n#define SERVO_HIGH_2 35\n#define GPIO_HIGH_1 1 2. PWM Timer Configuration A PWM signal with a frequency of 50Hz (20ms period) was used to control the servo motor. The timer was set to 14-bit resolution, allowing a duty cycle range of 0 to 16383. ledc_timer_config_t ledc_timer = { .speed_mode = PWM_MODE, .duty_resolution = PWM_RESOLUTION, .timer_num = PWM_TIMER, .freq_hz = PWM_FREQ, .clk_cfg = LEDC_AUTO_CLK\n};\nesp_err_t timer_err = ledc_timer_config(&ledc_timer); 3. Duty Cycle Calculation The pulse width for the servo was calculated based on the desired angle, mapped to the servo’s minimum and maximum pulse widths (544µs to 2400µs). The calculated pulse width was converted to the appropriate duty cycle for the PWM signal. Mathematically: Pulse Width (µs)=SERVO_MIN_PULSEWIDTH+(180SERVO_MAX_PULSEWIDTH−SERVO_MIN_PULSEWIDTH⋅Angle) Duty Cycle=PWM Period (µs)Pulse Width (µs)⋅Max Resolution For example: At 0°: Pulse width = 544µs, duty = 445. At 180°: Pulse width = 2400µs, duty = 1966. 4. Angle Testing The setServoAngle function was implemented to move the servo to specified angles between 0° and 180°: void setServoAngle(uint8_t angle) { // Convert angle to pulse width uint32_t pulseWidth = SERVO_MIN_PULSEWIDTH + (((SERVO_MAX_PULSEWIDTH - SERVO_MIN_PULSEWIDTH) * angle) / 180); // Convert pulse width to duty cycle uint32_t duty = (uint32_t)((float)pulseWidth * 16383.0f / 20000.0f); // Update duty cycle ledc_set_duty(PWM_MODE, PWM_CHANNEL, duty); ledc_update_duty(PWM_MODE, PWM_CHANNEL);\n} The loop function tested the full range of motion by moving the servo to angles 0°, 45°, 90°, 135°, and 180°, pausing 2 seconds between each move.","breadcrumbs":"Entry 10 - Week of 11/18/24 » Code Explanation","id":"37","title":"Code Explanation"},"38":{"body":"The servo motor successfully moved to the specified angles as expected. Duty cycle calculations matched the required pulse widths for standard servo motors, ensuring smooth operation. Minor debugging was required to correct initial configurations of the SERVO_HIGH pins and ensure proper timer initialization.","breadcrumbs":"Entry 10 - Week of 11/18/24 » Observations","id":"38","title":"Observations"},"39":{"body":"Timer Configuration Errors : Encountered a failure in ledc_timer_config. Resolved by ensuring correct timer frequency and clock settings. Servo Jitter : Observed slight jitter at certain angles, likely due to noise in the PWM signal. Planned to add capacitors for hardware noise reduction. Angle Limitation : Restricted the range to 0°–180° for compatibility with the servo’s specifications. Additional testing was done to ensure smooth operation at boundary values (0° and 180°).","breadcrumbs":"Entry 10 - Week of 11/18/24 » Debugging and Improvements","id":"39","title":"Debugging and Improvements"},"4":{"body":"","breadcrumbs":"Entry 2 - Week of 9/23/24 » Notebook Entry Lab 9/23/2024","id":"4","title":"Notebook Entry Lab 9/23/2024"},"40":{"body":"Optimize signal stability by testing with hardware filtering. Implement feedback control using a potentiometer for precise angle measurements. Adapt this code to work with PCB schematic","breadcrumbs":"Entry 10 - Week of 11/18/24 » Future Steps","id":"40","title":"Future Steps"},"41":{"body":"","breadcrumbs":"Entry 11 - Week of 11/25/24 » Notebook Entry Lab 11/25/24","id":"41","title":"Notebook Entry Lab 11/25/24"},"42":{"body":"Checked and developed the mathematical model in PID.","breadcrumbs":"Entry 11 - Week of 11/25/24 » Objectives","id":"42","title":"Objectives"},"43":{"body":"","breadcrumbs":"Entry 11 - Week of 11/25/24 » Progress","id":"43","title":"Progress"},"44":{"body":"The mathematical model in kinematics.cpp was derived based on the robot's omniwheel configuration, utilizing the velocity components in the x, y, and rotational (ω) directions. The equations for the wheel linear speeds were: wheelLinearSpeeds[i]=Vx⋅sin(θi)+Vy⋅cos(θi)+ω⋅r Here: Vx and Vy are the linear velocities in the x and y directions. θi is the angle of the i-th wheel relative to the robot's frame. ω is the angular velocity of the robot. r is the wheelbase radius. The wheel linear speeds were converted to angular speeds using the relationship: ωwheel=2dwheelLinearSpeeds[i] Where: d is the diameter of the wheel. The angular speeds were then converted to RPM using the formula: wheelSpeeds[i]=ωwheel⋅2π60 This ensured that the motor speed commands were proportional to the desired robot movement.","breadcrumbs":"Entry 11 - Week of 11/25/24 » Kinematics Model","id":"44","title":"Kinematics Model"},"45":{"body":"The PID model was implemented to control the motor speeds. The PID controller equation used in pid_control.cpp is: u(t)=Kp⋅e(t)+Ki⋅∫e(t)dt+Kd⋅dtde(t) Where: u(t) is the control signal (PWM value). e(t) is the error, calculated as: e(t)=setpointRPM−actualRPM Kp, Ki, and Kd are the proportional, integral, and derivative gains, respectively. The pseudocode for the PID implementation was as follows: int computePID(int motor, float setpointRPM, float actualRPM) { error = setpointRPM - actualRPM; integral += error; derivative = error - previousError; previousError = error; output = Kp * error + Ki * integral + Kd * derivative; return constrain(output, -MOTOR_MAX_SPEED, MOTOR_MAX_SPEED);\n}","breadcrumbs":"Entry 11 - Week of 11/25/24 » PID Model","id":"45","title":"PID Model"},"46":{"body":"Proportional Term (Kp⋅e(t)): Provides immediate response proportional to the current error. Adjusted Kp to minimize overshoot during testing. Integral Term (Ki⋅∫e(t)dt): Accounts for cumulative errors over time. Avoided integral windup by clamping the output in the computePID function. Derivative Term (Kd⋅dtde(t)): Dampens the response by anticipating future errors. Balanced Kd to prevent excessive delay in motor responses. This model ensured smooth and accurate motor control, aligning with the robot's motion requirements.","breadcrumbs":"Entry 11 - Week of 11/25/24 » Mathematical Breakdown","id":"46","title":"Mathematical Breakdown"},"47":{"body":"Last week's servo motor code didn't work with the PCB chip; we had to use the reduntant GPIO pins for the servo to work. We would be able to fix this issue with a PCB v3, although it is quite late","breadcrumbs":"Entry 11 - Week of 11/25/24 » Issue","id":"47","title":"Issue"},"48":{"body":"","breadcrumbs":"Entry 12 - Week of 12/02/24 » Notebook Entry Lab 12/02/24","id":"48","title":"Notebook Entry Lab 12/02/24"},"49":{"body":"Finish Kinematics code + PID Debug and test kinematics Finish Communication with robot to Web App at demo level Create github repo for code","breadcrumbs":"Entry 12 - Week of 12/02/24 » Objectives","id":"49","title":"Objectives"},"5":{"body":"Visit the machine shop for initial design discussions with Gregg. Determine motor requirements for the project.","breadcrumbs":"Entry 2 - Week of 9/23/24 » Objectives","id":"5","title":"Objectives"},"50":{"body":"12/02 Evening Finalized Kinematics Code Verified the mathematical model in kinematics.cpp. Tested conversions from linear to angular velocity using wheel parameters. Debugged issues such as incorrect wheelbase radius or wheel diameter values and resolved unit mismatches causing overflow errors in wheelSpeeds computation. Tuned PID Controllers Used test scenarios with motors to adjust Kp, Ki, and Kd values. Fixed instability caused by improper proportional (oscillation) and derivative (sluggish response) tuning. Addressed integral windup for large errors. 12/03 Morning Tested Core Functions Unit tested functions like moveForward, rotateRobot, drawCircle, and drawSquare. Debugged timing calculation issues in esp_timer_get_time() that caused skipped execution or unexpected delays. Resolved alignment drift in rotateRobot by calibrating encoder accuracy. Validated Web App Communication Verified that the Flask app and ESP32 communicated correctly. Ensured the sendIPToFlaskServer function registered the ESP32 as expected. Tested the /draw POST endpoint to confirm proper JSON payload handling. Fixed deserialization errors in web_server.cpp and app.py. 12/03 Evening Performed Integration Testing Integrated kinematics, motor control, and PID feedback loops with drawing commands like circle, square, and triangle. Resolved issues with PWM values exceeding limits (MOTOR_MAX_SPEED) due to PID outputs. Fixed motor misbehavior caused by incorrect encoder ISR implementations. Refined Web UI Finalized login/logout workflows in app.py and enforced single-user session rules. 12/04 Early Morning Created GitHub Repository Organized the repository with clear module folders: /src for C++ code (motor_control, pid_control, kinematics). /web for the Flask app. /docs for project documentation. Conducted Final System Testing Tested commands issued through the web interface, ensuring the robot drew shapes as expected. Verified communication reliability over Wi-Fi. Addressed latency issues in HTTP requests and resolved occasional connection timeouts caused by weak Wi-Fi signals.","breadcrumbs":"Entry 12 - Week of 12/02/24 » Progress","id":"50","title":"Progress"},"51":{"body":"Hardware-Specific Issues Resolved encoder ISR bounce by implementing software debouncing. Verified motor driver wiring and ensured proper STDBY pin configuration. Communication Issues Used debug logs on the ESP32 to trace packet failures and addressed connection inconsistencies. Logging and Monitoring Implemented verbose logging for PID values, calculated wheel speeds, and HTTP responses to streamline troubleshooting.","breadcrumbs":"Entry 12 - Week of 12/02/24 » Additional Notes for Debugging","id":"51","title":"Additional Notes for Debugging"},"52":{"body":"Kinematics for PID on front 2 wheels is correct; Fiddling with the connections on the back motor shows that the issue lies behind the blue/white lines connecting to the encoder, meaning encoder feedback does not work correctly. We verified this on the morning of 12/04.","breadcrumbs":"Entry 12 - Week of 12/02/24 » Issues:","id":"52","title":"Issues:"},"6":{"body":"On 9/12, my partner Matt Paul (mjpaul3) decided to implement a basic 4-wheel design remniscient of the main chassis we used in ECE110 alt text On 9/16, we decided to implement this final design, which was considerably shorter compared to the initial design we found 4 days earlier, which would be considerably less expensive compared to the first design (less wheels and motors), and also lends itself to more slick motion thanks to the omniwheels.` alt text On 9/24, we decided to brainstorm what we wanted to make for the design doc: alt text","breadcrumbs":"Entry 2 - Week of 9/23/24 » Progress","id":"6","title":"Progress"},"7":{"body":"","breadcrumbs":"Entry 3 - Week of 9/30/24 » Notebook Entry Lab 9/30/2024","id":"7","title":"Notebook Entry Lab 9/30/2024"},"8":{"body":"Finalize Design Document Finalize subsystem requirements and start ordering parts.","breadcrumbs":"Entry 3 - Week of 9/30/24 » Objectives","id":"8","title":"Objectives"},"9":{"body":"Defined the high-level system architecture, including motor control, sensor integration, and Wi-Fi communication. Ordered the ESP32, motor drivers, and gear motors for testing. Created initial CAD models for mechanical design to ensure component fit. This was the main design we used for understanding the web app communications: alt text","breadcrumbs":"Entry 3 - Week of 9/30/24 » Progress","id":"9","title":"Progress"}},"length":53,"save":true},"fields":["title","body","breadcrumbs"],"index":{"body":{"root":{"0":{"df":2,"docs":{"37":{"tf":2.0},"39":{"tf":1.0}},"°":{"df":0,"docs":{},"–":{"1":{"8":{"0":{"df":1,"docs":{"39":{"tf":1.0}}},"df":0,"docs":{}},"df":0,"docs":{}},"df":0,"docs":{}}}},"1":{"0":{"/":{"0":{"7":{"/":{"2":{"0":{"2":{"4":{"df":1,"docs":{"12":{"tf":1.0}}},"df":0,"docs":{}},"df":0,"docs":{}},"df":0,"docs":{}},"df":0,"docs":{}},"df":0,"docs":{}},"df":0,"docs":{}},"1":{"1":{"df":1,"docs":{"14":{"tf":1.0}}},"4":{"/":{"2":{"0":{"2":{"4":{"df":1,"docs":{"16":{"tf":1.0}}},"df":0,"docs":{}},"df":0,"docs":{}},"df":0,"docs":{}},"df":0,"docs":{}},"df":0,"docs":{}},"5":{"df":1,"docs":{"18":{"tf":1.0}}},"df":1,"docs":{"10":{"tf":1.0}}},"2":{"1":{"/":{"2":{"0":{"2":{"4":{"df":1,"docs":{"19":{"tf":1.0}}},"df":0,"docs":{}},"df":0,"docs":{}},"df":0,"docs":{}},"df":0,"docs":{}},"df":0,"docs":{}},"2":{"df":1,"docs":{"21":{"tf":1.0}}},"7":{"df":1,"docs":{"21":{"tf":1.0}}},"8":{"/":{"2":{"0":{"2":{"4":{"df":1,"docs":{"23":{"tf":1.0}}},"df":0,"docs":{}},"df":0,"docs":{}},"df":0,"docs":{}},"df":0,"docs":{}},"df":0,"docs":{}},"df":1,"docs":{"10":{"tf":1.0}}},"3":{"df":1,"docs":{"11":{"tf":1.0}}},"df":0,"docs":{}},"0":{"df":0,"docs":{},"k":{"df":2,"docs":{"21":{"tf":1.0},"32":{"tf":1.0}}}},"df":0,"docs":{},"k":{"df":2,"docs":{"21":{"tf":1.0},"32":{"tf":1.0}}},"μ":{"df":0,"docs":{},"f":{"df":2,"docs":{"21":{"tf":1.4142135623730951},"32":{"tf":1.0}}}}},"1":{"/":{"0":{"4":{"/":{"2":{"4":{"df":1,"docs":{"26":{"tf":1.0}}},"df":0,"docs":{}},"df":0,"docs":{}},"df":0,"docs":{}},"df":0,"docs":{}},"1":{"1":{"/":{"2":{"4":{"df":1,"docs":{"30":{"tf":1.0}}},"df":0,"docs":{}},"df":0,"docs":{}},"df":0,"docs":{}},"8":{"/":{"2":{"4":{"df":1,"docs":{"34":{"tf":1.0}}},"df":0,"docs":{}},"df":0,"docs":{}},"df":0,"docs":{}},"df":0,"docs":{}},"2":{"5":{"/":{"2":{"4":{"df":1,"docs":{"41":{"tf":1.0}}},"df":0,"docs":{}},"df":0,"docs":{}},"df":0,"docs":{}},"df":0,"docs":{}},"df":0,"docs":{}},"df":0,"docs":{}},"2":{"/":{"0":{"2":{"/":{"2":{"4":{"df":1,"docs":{"48":{"tf":1.0}}},"df":0,"docs":{}},"df":0,"docs":{}},"df":1,"docs":{"50":{"tf":1.0}}},"3":{"df":1,"docs":{"50":{"tf":1.4142135623730951}}},"4":{"df":2,"docs":{"50":{"tf":1.0},"52":{"tf":1.0}}},"df":0,"docs":{}},"df":0,"docs":{}},"df":0,"docs":{}},"3":{"5":{"df":1,"docs":{"37":{"tf":1.0}}},"df":1,"docs":{"37":{"tf":1.4142135623730951}}},"4":{"df":2,"docs":{"36":{"tf":1.0},"37":{"tf":1.0}}},"6":{"3":{"8":{"3":{".":{"0":{"df":0,"docs":{},"f":{"df":1,"docs":{"37":{"tf":1.0}}}},"df":0,"docs":{}},"df":1,"docs":{"37":{"tf":1.0}}},"df":0,"docs":{}},"df":0,"docs":{}},"df":0,"docs":{}},"8":{"0":{"df":2,"docs":{"37":{"tf":2.0},"39":{"tf":1.0}},"μ":{"df":0,"docs":{},"f":{"df":1,"docs":{"21":{"tf":1.0}}}}},"df":0,"docs":{}},"9":{"'":{"df":1,"docs":{"3":{"tf":1.0}}},"6":{"6":{"df":1,"docs":{"37":{"tf":1.0}}},"df":0,"docs":{}},"df":0,"docs":{}},"df":2,"docs":{"18":{"tf":1.0},"37":{"tf":1.7320508075688772}},"k":{"df":2,"docs":{"21":{"tf":1.0},"32":{"tf":1.0}}},"μ":{"df":0,"docs":{},"f":{"df":2,"docs":{"21":{"tf":1.0},"32":{"tf":1.0}}},"h":{"df":2,"docs":{"21":{"tf":1.0},"32":{"tf":1.0}}}}},"2":{"0":{"0":{"0":{"0":{".":{"0":{"df":0,"docs":{},"f":{"df":1,"docs":{"37":{"tf":1.0}}}},"df":0,"docs":{}},"df":0,"docs":{}},"df":0,"docs":{}},"df":0,"docs":{}},"2":{"3":{"df":1,"docs":{"3":{"tf":1.0}}},"4":{"df":1,"docs":{"3":{"tf":1.0}}},"df":0,"docs":{}},"df":0,"docs":{},"m":{"df":1,"docs":{"37":{"tf":1.0}}}},"1":{"df":0,"docs":{},"μ":{"df":0,"docs":{},"f":{"df":1,"docs":{"32":{"tf":1.0}}}}},"2":{".":{"1":{"df":0,"docs":{},"k":{"df":1,"docs":{"32":{"tf":1.0}}}},"df":0,"docs":{}},"df":1,"docs":{"21":{"tf":1.0}}},"4":{"0":{"0":{"df":0,"docs":{},"µ":{"df":1,"docs":{"37":{"tf":1.4142135623730951}}}},"df":0,"docs":{}},"df":0,"docs":{}},"7":{"df":0,"docs":{},"μ":{"df":0,"docs":{},"f":{"df":1,"docs":{"21":{"tf":1.0}}}}},"df":2,"docs":{"37":{"tf":1.4142135623730951},"52":{"tf":1.0}}},"3":{"'":{"df":1,"docs":{"3":{"tf":1.0}}},".":{"3":{"df":0,"docs":{},"k":{"df":1,"docs":{"32":{"tf":1.0}}},"v":{"df":2,"docs":{"14":{"tf":1.0},"32":{"tf":1.0}}}},"df":0,"docs":{}},"0":{"0":{"df":0,"docs":{},"m":{"a":{"df":1,"docs":{"14":{"tf":1.0}}},"df":0,"docs":{}}},"df":0,"docs":{}},"5":{"df":1,"docs":{"37":{"tf":1.4142135623730951}}},"6":{"df":1,"docs":{"37":{"tf":1.4142135623730951}}},"df":1,"docs":{"37":{"tf":1.0}}},"4":{".":{"7":{"df":0,"docs":{},"μ":{"df":0,"docs":{},"f":{"df":2,"docs":{"21":{"tf":1.0},"32":{"tf":1.0}}}}},"df":0,"docs":{}},"4":{"5":{"df":1,"docs":{"37":{"tf":1.0}}},"df":0,"docs":{}},"5":{"df":1,"docs":{"37":{"tf":1.0}}},"7":{".":{"5":{"df":0,"docs":{},"k":{"df":1,"docs":{"32":{"tf":1.0}}}},"df":0,"docs":{}},"df":0,"docs":{}},"9":{".":{"9":{"df":0,"docs":{},"k":{"df":1,"docs":{"21":{"tf":1.0}}}},"df":0,"docs":{}},"4":{"df":0,"docs":{},"k":{"df":1,"docs":{"32":{"tf":1.0}}}},"df":0,"docs":{}},"df":2,"docs":{"37":{"tf":1.0},"6":{"tf":1.4142135623730951}}},"5":{"0":{"0":{"df":0,"docs":{},"m":{"a":{"df":1,"docs":{"14":{"tf":1.0}}},"df":0,"docs":{}}},"df":0,"docs":{},"h":{"df":0,"docs":{},"z":{"df":2,"docs":{"36":{"tf":1.0},"37":{"tf":1.0}}}}},"4":{"4":{"df":0,"docs":{},"µ":{"df":1,"docs":{"37":{"tf":1.4142135623730951}}}},"df":0,"docs":{}},"df":0,"docs":{},"v":{"df":1,"docs":{"28":{"tf":1.0}}}},"6":{"df":1,"docs":{"28":{"tf":1.0}}},"9":{"/":{"1":{"2":{"df":1,"docs":{"6":{"tf":1.0}}},"6":{"/":{"2":{"0":{"2":{"4":{"df":1,"docs":{"0":{"tf":1.0}}},"df":0,"docs":{}},"df":0,"docs":{}},"df":0,"docs":{}},"df":0,"docs":{}},"df":1,"docs":{"6":{"tf":1.0}}},"7":{"df":1,"docs":{"3":{"tf":1.0}}},"df":0,"docs":{}},"2":{"3":{"/":{"2":{"0":{"2":{"4":{"df":1,"docs":{"4":{"tf":1.0}}},"df":0,"docs":{}},"df":0,"docs":{}},"df":0,"docs":{}},"df":0,"docs":{}},"df":0,"docs":{}},"4":{"df":1,"docs":{"6":{"tf":1.0}}},"df":0,"docs":{}},"3":{"0":{"/":{"2":{"0":{"2":{"4":{"df":1,"docs":{"7":{"tf":1.0}}},"df":0,"docs":{}},"df":0,"docs":{}},"df":0,"docs":{}},"df":0,"docs":{}},"df":0,"docs":{}},"df":0,"docs":{}},"df":0,"docs":{}},"0":{"df":1,"docs":{"37":{"tf":1.0}}},"df":0,"docs":{}},"a":{"c":{"c":{"df":0,"docs":{},"e":{"df":0,"docs":{},"s":{"df":0,"docs":{},"s":{"df":2,"docs":{"29":{"tf":1.0},"32":{"tf":1.4142135623730951}}}}},"o":{"df":0,"docs":{},"u":{"df":0,"docs":{},"n":{"df":0,"docs":{},"t":{"df":1,"docs":{"46":{"tf":1.0}}}}}},"u":{"df":0,"docs":{},"r":{"a":{"c":{"df":0,"docs":{},"i":{"df":1,"docs":{"50":{"tf":1.0}}}},"df":0,"docs":{}},"df":1,"docs":{"46":{"tf":1.0}}}}},"df":0,"docs":{},"h":{"df":0,"docs":{},"i":{"df":0,"docs":{},"e":{"df":0,"docs":{},"v":{"df":1,"docs":{"14":{"tf":1.0}}}}}},"t":{"df":0,"docs":{},"i":{"df":0,"docs":{},"o":{"df":0,"docs":{},"n":{"df":1,"docs":{"3":{"tf":1.0}}}}},"u":{"a":{"df":0,"docs":{},"l":{"df":0,"docs":{},"r":{"df":0,"docs":{},"p":{"df":0,"docs":{},"m":{"df":1,"docs":{"45":{"tf":1.4142135623730951}}}}}}},"df":0,"docs":{}}}},"d":{"a":{"df":0,"docs":{},"p":{"df":0,"docs":{},"t":{"df":1,"docs":{"40":{"tf":1.0}}}}},"d":{"df":1,"docs":{"39":{"tf":1.0}},"i":{"df":0,"docs":{},"t":{"df":4,"docs":{"28":{"tf":1.0},"3":{"tf":1.0},"39":{"tf":1.0},"51":{"tf":1.0}},"i":{"df":0,"docs":{},"o":{"df":0,"docs":{},"n":{"df":1,"docs":{"37":{"tf":1.0}}}}}}},"r":{"df":0,"docs":{},"e":{"df":0,"docs":{},"s":{"df":0,"docs":{},"s":{"df":4,"docs":{"10":{"tf":1.0},"27":{"tf":1.0},"50":{"tf":1.4142135623730951},"51":{"tf":1.0}}}}}}},"df":5,"docs":{"11":{"tf":1.0},"14":{"tf":1.0},"28":{"tf":1.7320508075688772},"29":{"tf":1.0},"3":{"tf":1.0}},"j":{"df":0,"docs":{},"u":{"df":0,"docs":{},"s":{"df":0,"docs":{},"t":{"df":2,"docs":{"46":{"tf":1.0},"50":{"tf":1.0}}}}}},"v":{"a":{"df":0,"docs":{},"n":{"c":{"df":1,"docs":{"21":{"tf":1.0}}},"df":0,"docs":{}}},"df":0,"docs":{}}},"df":0,"docs":{},"i":{"d":{"df":1,"docs":{"3":{"tf":1.0}}},"df":0,"docs":{}},"l":{"df":0,"docs":{},"g":{"df":0,"docs":{},"o":{"df":0,"docs":{},"r":{"df":0,"docs":{},"i":{"df":0,"docs":{},"t":{"df":0,"docs":{},"h":{"df":0,"docs":{},"m":{"df":1,"docs":{"22":{"tf":1.0}}}}}}}}},"i":{"df":0,"docs":{},"g":{"df":0,"docs":{},"n":{"df":2,"docs":{"46":{"tf":1.0},"50":{"tf":1.0}}}}},"l":{"df":0,"docs":{},"o":{"df":0,"docs":{},"w":{"df":1,"docs":{"37":{"tf":1.0}}}}},"o":{"df":0,"docs":{},"n":{"df":0,"docs":{},"g":{"df":0,"docs":{},"s":{"df":0,"docs":{},"i":{"d":{"df":1,"docs":{"32":{"tf":1.0}}},"df":0,"docs":{}}}}}},"t":{"df":7,"docs":{"10":{"tf":1.0},"2":{"tf":1.0},"25":{"tf":1.0},"28":{"tf":1.0},"32":{"tf":1.4142135623730951},"6":{"tf":1.7320508075688772},"9":{"tf":1.0}},"h":{"df":0,"docs":{},"o":{"df":0,"docs":{},"u":{"df":0,"docs":{},"g":{"df":0,"docs":{},"h":{"df":1,"docs":{"47":{"tf":1.0}}}}}}}},"w":{"a":{"df":0,"docs":{},"y":{"df":1,"docs":{"37":{"tf":1.0}}}},"df":0,"docs":{}}},"n":{"a":{"df":0,"docs":{},"l":{"df":0,"docs":{},"y":{"df":0,"docs":{},"s":{"df":0,"docs":{},"i":{"df":3,"docs":{"14":{"tf":1.0},"2":{"tf":1.0},"3":{"tf":1.0}}}},"t":{"df":1,"docs":{"13":{"tf":1.0}}}}}},"df":0,"docs":{},"g":{"df":0,"docs":{},"l":{"df":5,"docs":{"37":{"tf":2.6457513110645907},"38":{"tf":1.0},"39":{"tf":1.4142135623730951},"40":{"tf":1.0},"44":{"tf":1.0}}},"u":{"df":0,"docs":{},"l":{"a":{"df":0,"docs":{},"r":{"df":2,"docs":{"44":{"tf":1.7320508075688772},"50":{"tf":1.0}}}},"df":0,"docs":{}}}},"t":{"df":0,"docs":{},"e":{"df":0,"docs":{},"n":{"df":0,"docs":{},"n":{"a":{"df":1,"docs":{"21":{"tf":1.0}}},"df":0,"docs":{}}}},"i":{"c":{"df":0,"docs":{},"i":{"df":0,"docs":{},"p":{"df":1,"docs":{"46":{"tf":1.0}}}}},"df":0,"docs":{}}}},"p":{"df":0,"docs":{},"p":{".":{"df":0,"docs":{},"p":{"df":0,"docs":{},"i":{"df":1,"docs":{"50":{"tf":1.4142135623730951}}}}},"df":5,"docs":{"21":{"tf":1.0},"22":{"tf":1.0},"49":{"tf":1.0},"50":{"tf":1.7320508075688772},"9":{"tf":1.0}},"l":{"df":0,"docs":{},"i":{"c":{"df":2,"docs":{"14":{"tf":1.4142135623730951},"21":{"tf":1.0}}},"df":0,"docs":{}}},"r":{"df":0,"docs":{},"o":{"df":0,"docs":{},"p":{"df":0,"docs":{},"r":{"df":0,"docs":{},"i":{"df":2,"docs":{"3":{"tf":1.0},"37":{"tf":1.0}}}}}}}}},"r":{"c":{"df":0,"docs":{},"h":{"df":0,"docs":{},"i":{"df":0,"docs":{},"t":{"df":0,"docs":{},"e":{"c":{"df":0,"docs":{},"t":{"df":0,"docs":{},"u":{"df":0,"docs":{},"r":{"df":1,"docs":{"9":{"tf":1.0}}}}}},"df":0,"docs":{}}}}}},"df":0,"docs":{}},"s":{"df":0,"docs":{},"s":{"df":0,"docs":{},"e":{"df":0,"docs":{},"m":{"b":{"df":0,"docs":{},"l":{"df":3,"docs":{"21":{"tf":1.0},"32":{"tf":1.0},"33":{"tf":1.0}}}},"df":0,"docs":{}}}}},"t":{"df":0,"docs":{},"t":{"a":{"c":{"df":0,"docs":{},"h":{"df":1,"docs":{"10":{"tf":1.0}}}},"df":0,"docs":{}},"df":0,"docs":{}}},"u":{"df":0,"docs":{},"x":{"df":0,"docs":{},"i":{"df":0,"docs":{},"l":{"df":0,"docs":{},"i":{"a":{"df":0,"docs":{},"r":{"df":0,"docs":{},"i":{"df":1,"docs":{"37":{"tf":1.0}}}}},"df":0,"docs":{}}}}}},"v":{"a":{"df":0,"docs":{},"i":{"df":0,"docs":{},"l":{"df":1,"docs":{"32":{"tf":1.0}}}}},"df":0,"docs":{},"o":{"df":0,"docs":{},"i":{"d":{"df":1,"docs":{"46":{"tf":1.0}}},"df":0,"docs":{}}}}},"b":{"a":{"c":{"df":0,"docs":{},"k":{"df":1,"docs":{"52":{"tf":1.0}}}},"df":0,"docs":{},"l":{"a":{"df":0,"docs":{},"n":{"c":{"df":1,"docs":{"46":{"tf":1.0}}},"df":0,"docs":{}}},"df":0,"docs":{}},"s":{"df":0,"docs":{},"e":{"df":4,"docs":{"14":{"tf":1.0},"28":{"tf":1.0},"37":{"tf":1.0},"44":{"tf":1.0}}},"i":{"c":{"df":3,"docs":{"21":{"tf":1.4142135623730951},"35":{"tf":1.0},"6":{"tf":1.0}}},"df":0,"docs":{}}},"t":{"df":0,"docs":{},"t":{"df":0,"docs":{},"e":{"df":0,"docs":{},"r":{"df":0,"docs":{},"i":{"df":4,"docs":{"14":{"tf":1.0},"3":{"tf":1.0},"31":{"tf":1.0},"32":{"tf":1.7320508075688772}}},"y":{"'":{"df":1,"docs":{"3":{"tf":1.0}}},"df":0,"docs":{}}}}}}},"df":0,"docs":{},"e":{"df":0,"docs":{},"f":{"df":0,"docs":{},"o":{"df":0,"docs":{},"r":{"df":1,"docs":{"33":{"tf":1.0}}}}},"g":{"a":{"df":0,"docs":{},"n":{"df":1,"docs":{"21":{"tf":1.0}}}},"df":0,"docs":{},"i":{"df":0,"docs":{},"n":{"df":4,"docs":{"13":{"tf":1.0},"20":{"tf":1.0},"29":{"tf":1.0},"33":{"tf":1.0}}}}},"h":{"a":{"df":0,"docs":{},"v":{"df":0,"docs":{},"i":{"df":0,"docs":{},"o":{"df":0,"docs":{},"r":{"df":1,"docs":{"32":{"tf":1.0}}}}}}},"df":0,"docs":{},"i":{"df":0,"docs":{},"n":{"d":{"df":1,"docs":{"52":{"tf":1.0}}},"df":0,"docs":{}}}},"l":{"df":0,"docs":{},"o":{"df":0,"docs":{},"w":{"df":1,"docs":{"36":{"tf":1.0}}}}},"n":{"c":{"df":0,"docs":{},"h":{"df":1,"docs":{"35":{"tf":1.0}}}},"df":0,"docs":{}},"t":{"df":0,"docs":{},"t":{"df":0,"docs":{},"e":{"df":0,"docs":{},"r":{"df":1,"docs":{"3":{"tf":1.0}}}}},"w":{"df":0,"docs":{},"e":{"df":0,"docs":{},"e":{"df":0,"docs":{},"n":{"df":1,"docs":{"37":{"tf":1.4142135623730951}}}}}}}},"i":{"df":0,"docs":{},"t":{"df":2,"docs":{"36":{"tf":1.0},"37":{"tf":1.0}}}},"l":{"df":0,"docs":{},"o":{"c":{"df":0,"docs":{},"k":{"df":3,"docs":{"14":{"tf":1.4142135623730951},"2":{"tf":1.0},"3":{"tf":1.4142135623730951}}}},"df":0,"docs":{}},"u":{"df":0,"docs":{},"e":{"/":{"df":0,"docs":{},"w":{"df":0,"docs":{},"h":{"df":0,"docs":{},"i":{"df":0,"docs":{},"t":{"df":1,"docs":{"52":{"tf":1.0}}}}}}},"df":0,"docs":{}}}},"o":{"a":{"df":0,"docs":{},"r":{"d":{"df":6,"docs":{"20":{"tf":1.0},"21":{"tf":1.7320508075688772},"24":{"tf":1.0},"28":{"tf":1.0},"35":{"tf":1.0},"36":{"tf":1.0}}},"df":0,"docs":{}}},"df":0,"docs":{},"t":{"df":0,"docs":{},"t":{"df":0,"docs":{},"o":{"df":0,"docs":{},"m":{"df":1,"docs":{"32":{"tf":1.4142135623730951}}}}}},"u":{"df":0,"docs":{},"n":{"c":{"df":1,"docs":{"51":{"tf":1.0}}},"d":{"a":{"df":0,"docs":{},"r":{"df":0,"docs":{},"i":{"df":1,"docs":{"39":{"tf":1.0}}}}},"df":0,"docs":{}},"df":0,"docs":{}}}},"r":{"a":{"df":0,"docs":{},"i":{"df":0,"docs":{},"n":{"df":0,"docs":{},"s":{"df":0,"docs":{},"t":{"df":0,"docs":{},"o":{"df":0,"docs":{},"r":{"df":0,"docs":{},"m":{"df":2,"docs":{"11":{"tf":1.0},"6":{"tf":1.0}}}}}}}}}},"df":0,"docs":{},"e":{"a":{"df":0,"docs":{},"k":{"d":{"df":0,"docs":{},"o":{"df":0,"docs":{},"w":{"df":0,"docs":{},"n":{"df":1,"docs":{"46":{"tf":1.0}}}}}},"df":0,"docs":{}}},"df":0,"docs":{}},"i":{"d":{"df":0,"docs":{},"g":{"df":1,"docs":{"28":{"tf":1.0}}}},"df":0,"docs":{}}},"u":{"df":0,"docs":{},"t":{"df":0,"docs":{},"t":{"df":0,"docs":{},"o":{"df":0,"docs":{},"n":{"df":1,"docs":{"28":{"tf":1.0}}}}}}}},"c":{"3":{"df":1,"docs":{"14":{"tf":1.0}}},"a":{"d":{"df":1,"docs":{"9":{"tf":1.0}}},"df":0,"docs":{},"l":{"c":{"df":0,"docs":{},"u":{"df":0,"docs":{},"l":{"df":9,"docs":{"13":{"tf":1.4142135623730951},"14":{"tf":1.7320508075688772},"21":{"tf":1.0},"3":{"tf":1.7320508075688772},"37":{"tf":1.7320508075688772},"38":{"tf":1.0},"45":{"tf":1.0},"50":{"tf":1.0},"51":{"tf":1.0}}}}},"df":0,"docs":{},"i":{"b":{"df":0,"docs":{},"r":{"df":1,"docs":{"50":{"tf":1.0}}}},"df":0,"docs":{}}},"m":{"df":0,"docs":{},"e":{"df":0,"docs":{},"r":{"a":{"df":4,"docs":{"20":{"tf":1.0},"21":{"tf":1.4142135623730951},"22":{"tf":1.0},"32":{"tf":1.0}}},"df":0,"docs":{}}}},"p":{"a":{"c":{"df":1,"docs":{"3":{"tf":1.4142135623730951}},"i":{"df":0,"docs":{},"t":{"df":0,"docs":{},"o":{"df":0,"docs":{},"r":{"df":6,"docs":{"14":{"tf":1.4142135623730951},"20":{"tf":1.0},"21":{"tf":1.7320508075688772},"31":{"tf":1.0},"32":{"tf":1.0},"39":{"tf":1.0}}}}}}},"df":0,"docs":{}},"df":0,"docs":{},"t":{"df":0,"docs":{},"u":{"df":0,"docs":{},"r":{"df":1,"docs":{"21":{"tf":1.0}}}}}},"r":{"df":1,"docs":{"14":{"tf":1.0}}},"u":{"df":0,"docs":{},"s":{"df":2,"docs":{"21":{"tf":1.0},"50":{"tf":2.23606797749979}}}}},"df":2,"docs":{"32":{"tf":1.0},"50":{"tf":1.0}},"e":{"df":0,"docs":{},"r":{"df":0,"docs":{},"t":{"a":{"df":0,"docs":{},"i":{"df":0,"docs":{},"n":{"df":1,"docs":{"39":{"tf":1.0}}}}},"df":0,"docs":{}}}},"f":{"1":{"df":1,"docs":{"32":{"tf":1.0}}},"2":{"df":1,"docs":{"32":{"tf":1.0}}},"df":0,"docs":{}},"h":{"a":{"df":0,"docs":{},"n":{"df":0,"docs":{},"g":{"df":2,"docs":{"27":{"tf":1.0},"28":{"tf":1.4142135623730951}}}},"s":{"df":0,"docs":{},"s":{"df":0,"docs":{},"i":{"df":3,"docs":{"24":{"tf":1.0},"25":{"tf":1.0},"6":{"tf":1.0}}}}}},"df":0,"docs":{},"e":{"c":{"df":0,"docs":{},"k":{"df":1,"docs":{"42":{"tf":1.0}}}},"df":0,"docs":{}},"i":{"df":0,"docs":{},"p":{"df":1,"docs":{"47":{"tf":1.0}}}}},"i":{"df":0,"docs":{},"r":{"c":{"df":0,"docs":{},"l":{"df":1,"docs":{"50":{"tf":1.0}}},"u":{"df":0,"docs":{},"i":{"df":0,"docs":{},"t":{"df":1,"docs":{"14":{"tf":1.0}}}}}},"df":0,"docs":{}},"t":{"a":{"df":0,"docs":{},"t":{"df":1,"docs":{"3":{"tf":1.0}}}},"df":0,"docs":{}}},"l":{"a":{"df":0,"docs":{},"m":{"df":0,"docs":{},"p":{"df":1,"docs":{"46":{"tf":1.0}}}},"r":{"df":0,"docs":{},"i":{"df":0,"docs":{},"t":{"df":0,"docs":{},"i":{"df":1,"docs":{"3":{"tf":1.0}}}}}}},"df":0,"docs":{},"e":{"a":{"df":0,"docs":{},"n":{"df":1,"docs":{"3":{"tf":1.0}}},"r":{"a":{"df":0,"docs":{},"n":{"c":{"df":1,"docs":{"32":{"tf":1.4142135623730951}}},"df":0,"docs":{}}},"df":2,"docs":{"21":{"tf":1.0},"50":{"tf":1.0}},"l":{"df":0,"docs":{},"i":{"df":2,"docs":{"14":{"tf":1.0},"3":{"tf":1.0}}}}}},"df":0,"docs":{}},"k":{"_":{"c":{"df":0,"docs":{},"f":{"df":0,"docs":{},"g":{"df":1,"docs":{"37":{"tf":1.0}}}}},"df":0,"docs":{}},"df":0,"docs":{}},"o":{"c":{"df":0,"docs":{},"k":{"df":1,"docs":{"39":{"tf":1.0}}}},"df":0,"docs":{}}},"o":{"d":{"df":0,"docs":{},"e":{"df":6,"docs":{"35":{"tf":1.0},"37":{"tf":1.0},"40":{"tf":1.0},"47":{"tf":1.0},"49":{"tf":1.4142135623730951},"50":{"tf":1.4142135623730951}}}},"df":0,"docs":{},"m":{"df":0,"docs":{},"m":{"a":{"df":0,"docs":{},"n":{"d":{"df":3,"docs":{"21":{"tf":1.0},"44":{"tf":1.0},"50":{"tf":1.4142135623730951}}},"df":0,"docs":{}}},"df":0,"docs":{},"u":{"df":0,"docs":{},"n":{"df":5,"docs":{"21":{"tf":1.0},"49":{"tf":1.0},"50":{"tf":1.7320508075688772},"51":{"tf":1.0},"9":{"tf":1.4142135623730951}}}}},"p":{"a":{"df":0,"docs":{},"r":{"df":1,"docs":{"6":{"tf":1.4142135623730951}}},"t":{"df":3,"docs":{"21":{"tf":1.0},"32":{"tf":1.0},"39":{"tf":1.0}}}},"df":0,"docs":{},"i":{"df":0,"docs":{},"l":{"df":1,"docs":{"3":{"tf":1.0}}}},"l":{"df":0,"docs":{},"e":{"df":0,"docs":{},"t":{"df":2,"docs":{"22":{"tf":1.0},"32":{"tf":1.0}}}}},"o":{"df":0,"docs":{},"n":{"df":12,"docs":{"14":{"tf":1.0},"20":{"tf":1.4142135623730951},"21":{"tf":1.7320508075688772},"28":{"tf":1.0},"29":{"tf":1.0},"31":{"tf":1.0},"32":{"tf":1.7320508075688772},"33":{"tf":1.0},"36":{"tf":1.0},"37":{"tf":1.0},"44":{"tf":1.0},"9":{"tf":1.0}},"e":{"df":0,"docs":{},"n":{"df":0,"docs":{},"t":{"'":{"df":1,"docs":{"3":{"tf":1.0}}},"df":0,"docs":{}}}}}},"u":{"df":0,"docs":{},"t":{"df":1,"docs":{"50":{"tf":1.0}},"e":{"df":0,"docs":{},"p":{"df":0,"docs":{},"i":{"d":{"(":{"df":0,"docs":{},"i":{"df":0,"docs":{},"n":{"df":0,"docs":{},"t":{"df":1,"docs":{"45":{"tf":1.0}}}}}},"df":1,"docs":{"46":{"tf":1.0}}},"df":0,"docs":{}}}}}}}},"n":{"c":{"df":0,"docs":{},"e":{"df":0,"docs":{},"r":{"df":0,"docs":{},"n":{"df":1,"docs":{"3":{"tf":1.0}}}}}},"d":{"df":0,"docs":{},"i":{"df":0,"docs":{},"t":{"df":1,"docs":{"14":{"tf":1.0}}}},"u":{"c":{"df":0,"docs":{},"t":{"df":2,"docs":{"3":{"tf":1.4142135623730951},"50":{"tf":1.0}}}},"df":0,"docs":{}}},"df":0,"docs":{},"f":{"df":0,"docs":{},"i":{"df":0,"docs":{},"g":{"df":0,"docs":{},"u":{"df":0,"docs":{},"r":{"df":8,"docs":{"21":{"tf":1.0},"32":{"tf":1.0},"36":{"tf":1.0},"37":{"tf":1.4142135623730951},"38":{"tf":1.0},"39":{"tf":1.0},"44":{"tf":1.0},"51":{"tf":1.0}}}}},"r":{"df":0,"docs":{},"m":{"df":5,"docs":{"15":{"tf":1.0},"21":{"tf":1.0},"32":{"tf":1.0},"33":{"tf":1.0},"50":{"tf":1.0}}}}}},"n":{"df":0,"docs":{},"e":{"c":{"df":0,"docs":{},"t":{"df":13,"docs":{"14":{"tf":1.0},"15":{"tf":1.0},"20":{"tf":1.0},"21":{"tf":1.4142135623730951},"28":{"tf":2.0},"29":{"tf":1.4142135623730951},"31":{"tf":1.0},"32":{"tf":1.7320508075688772},"33":{"tf":1.0},"37":{"tf":1.0},"50":{"tf":1.0},"51":{"tf":1.0},"52":{"tf":1.4142135623730951}}}},"df":0,"docs":{}}},"s":{"df":0,"docs":{},"i":{"d":{"df":0,"docs":{},"e":{"df":0,"docs":{},"r":{"df":2,"docs":{"14":{"tf":1.0},"6":{"tf":1.4142135623730951}}}}},"df":0,"docs":{},"s":{"df":0,"docs":{},"t":{"df":1,"docs":{"32":{"tf":1.0}}}}},"t":{"df":0,"docs":{},"r":{"a":{"df":0,"docs":{},"i":{"df":0,"docs":{},"n":{"(":{"df":0,"docs":{},"o":{"df":0,"docs":{},"u":{"df":0,"docs":{},"t":{"df":0,"docs":{},"p":{"df":0,"docs":{},"u":{"df":0,"docs":{},"t":{"df":1,"docs":{"45":{"tf":1.0}}}}}}}}},"df":0,"docs":{}}}},"df":0,"docs":{}}}},"t":{"a":{"c":{"df":0,"docs":{},"t":{"df":1,"docs":{"24":{"tf":1.0}}}},"df":0,"docs":{}},"df":0,"docs":{},"i":{"df":0,"docs":{},"n":{"df":0,"docs":{},"u":{"df":2,"docs":{"21":{"tf":1.0},"22":{"tf":1.0}}}}},"r":{"df":0,"docs":{},"o":{"df":0,"docs":{},"l":{"df":15,"docs":{"14":{"tf":1.0},"21":{"tf":1.0},"22":{"tf":1.0},"28":{"tf":1.0},"31":{"tf":1.0},"32":{"tf":1.0},"33":{"tf":1.0},"35":{"tf":1.4142135623730951},"36":{"tf":1.4142135623730951},"37":{"tf":1.0},"40":{"tf":1.0},"45":{"tf":1.7320508075688772},"46":{"tf":1.0},"50":{"tf":1.4142135623730951},"9":{"tf":1.0}}}}}},"v":{"df":0,"docs":{},"e":{"df":0,"docs":{},"r":{"df":0,"docs":{},"s":{"df":1,"docs":{"50":{"tf":1.0}}},"t":{"df":2,"docs":{"37":{"tf":1.7320508075688772},"44":{"tf":1.4142135623730951}}}}}}},"r":{"df":0,"docs":{},"e":{"df":1,"docs":{"50":{"tf":1.0}}},"r":{"df":0,"docs":{},"e":{"c":{"df":0,"docs":{},"t":{"df":5,"docs":{"10":{"tf":1.0},"28":{"tf":1.0},"38":{"tf":1.0},"39":{"tf":1.0},"52":{"tf":1.0}},"l":{"df":0,"docs":{},"i":{"df":2,"docs":{"50":{"tf":1.0},"52":{"tf":1.0}}}}}},"df":0,"docs":{},"s":{"df":0,"docs":{},"p":{"df":0,"docs":{},"o":{"df":0,"docs":{},"n":{"d":{"df":1,"docs":{"32":{"tf":1.0}}},"df":0,"docs":{}}}}}}}},"u":{"df":0,"docs":{},"n":{"df":0,"docs":{},"t":{"df":2,"docs":{"20":{"tf":1.0},"32":{"tf":1.0}}}},"r":{"df":0,"docs":{},"t":{"df":0,"docs":{},"e":{"df":0,"docs":{},"s":{"df":0,"docs":{},"i":{"df":2,"docs":{"2":{"tf":1.0},"32":{"tf":1.0}}}}}}}}},"r":{"df":0,"docs":{},"e":{"a":{"df":0,"docs":{},"t":{"df":6,"docs":{"10":{"tf":1.0},"14":{"tf":1.0},"3":{"tf":1.0},"49":{"tf":1.0},"50":{"tf":1.0},"9":{"tf":1.0}}}},"df":0,"docs":{}},"i":{"df":0,"docs":{},"t":{"df":0,"docs":{},"i":{"c":{"df":1,"docs":{"21":{"tf":1.0}}},"df":0,"docs":{}}}}},"u":{"df":0,"docs":{},"m":{"df":0,"docs":{},"u":{"df":0,"docs":{},"l":{"df":1,"docs":{"46":{"tf":1.0}}}}},"r":{"df":0,"docs":{},"r":{"df":0,"docs":{},"e":{"df":0,"docs":{},"n":{"df":0,"docs":{},"t":{"df":5,"docs":{"10":{"tf":1.0},"14":{"tf":1.4142135623730951},"18":{"tf":1.0},"32":{"tf":1.0},"46":{"tf":1.0}}}}}}}},"y":{"c":{"df":0,"docs":{},"l":{"df":2,"docs":{"37":{"tf":2.23606797749979},"38":{"tf":1.0}},"e":{"=":{"df":0,"docs":{},"p":{"df":0,"docs":{},"w":{"df":0,"docs":{},"m":{"df":1,"docs":{"37":{"tf":1.0}}}}}},"df":0,"docs":{}}}},"df":0,"docs":{}}},"d":{"a":{"df":0,"docs":{},"m":{"df":0,"docs":{},"p":{"df":0,"docs":{},"e":{"df":0,"docs":{},"n":{"df":1,"docs":{"46":{"tf":1.0}}}}}},"t":{"a":{"df":2,"docs":{"21":{"tf":1.4142135623730951},"22":{"tf":1.0}},"s":{"df":0,"docs":{},"h":{"df":0,"docs":{},"e":{"df":0,"docs":{},"e":{"df":0,"docs":{},"t":{"df":1,"docs":{"32":{"tf":1.0}}}}}}}},"df":0,"docs":{}},"y":{"df":1,"docs":{"6":{"tf":1.0}}}},"c":{"df":1,"docs":{"14":{"tf":1.0}}},"df":1,"docs":{"44":{"tf":1.0}},"e":{"a":{"d":{"df":0,"docs":{},"l":{"df":0,"docs":{},"i":{"df":0,"docs":{},"n":{"df":1,"docs":{"10":{"tf":1.0}}}}}},"df":0,"docs":{}},"b":{"df":0,"docs":{},"o":{"df":0,"docs":{},"u":{"df":0,"docs":{},"n":{"c":{"df":1,"docs":{"51":{"tf":1.0}}},"df":0,"docs":{}}}},"u":{"df":0,"docs":{},"g":{"df":6,"docs":{"28":{"tf":1.0},"38":{"tf":1.0},"39":{"tf":1.0},"49":{"tf":1.0},"50":{"tf":1.4142135623730951},"51":{"tf":1.4142135623730951}}}}},"c":{"df":0,"docs":{},"i":{"d":{"df":2,"docs":{"11":{"tf":1.0},"6":{"tf":1.7320508075688772}}},"df":0,"docs":{}}},"df":0,"docs":{},"f":{"df":0,"docs":{},"i":{"df":0,"docs":{},"n":{"df":2,"docs":{"37":{"tf":2.0},"9":{"tf":1.0}},"i":{"df":0,"docs":{},"t":{"df":1,"docs":{"37":{"tf":1.0}}}}}}},"l":{"a":{"df":0,"docs":{},"y":{"df":2,"docs":{"46":{"tf":1.0},"50":{"tf":1.0}}}},"df":0,"docs":{}},"m":{"df":0,"docs":{},"o":{"df":1,"docs":{"49":{"tf":1.0}}}},"r":{"df":0,"docs":{},"i":{"df":0,"docs":{},"v":{"df":4,"docs":{"44":{"tf":1.0},"45":{"tf":1.7320508075688772},"46":{"tf":1.0},"50":{"tf":1.0}}}}},"s":{"df":0,"docs":{},"e":{"df":0,"docs":{},"r":{"df":0,"docs":{},"i":{"df":1,"docs":{"50":{"tf":1.0}}}}},"i":{"df":0,"docs":{},"g":{"df":0,"docs":{},"n":{"df":18,"docs":{"1":{"tf":1.0},"10":{"tf":1.0},"11":{"tf":1.0},"13":{"tf":1.0},"14":{"tf":1.0},"17":{"tf":1.0},"2":{"tf":1.4142135623730951},"20":{"tf":1.0},"21":{"tf":1.0},"27":{"tf":1.0},"28":{"tf":1.4142135623730951},"3":{"tf":2.8284271247461903},"31":{"tf":1.0},"32":{"tf":1.4142135623730951},"5":{"tf":1.0},"6":{"tf":2.23606797749979},"8":{"tf":1.0},"9":{"tf":1.4142135623730951}}}},"r":{"df":4,"docs":{"3":{"tf":1.0},"32":{"tf":1.0},"37":{"tf":1.0},"44":{"tf":1.0}}}}},"t":{"a":{"df":0,"docs":{},"i":{"df":0,"docs":{},"l":{"df":4,"docs":{"11":{"tf":1.0},"14":{"tf":1.0},"3":{"tf":1.0},"32":{"tf":1.0}}}}},"df":0,"docs":{},"e":{"df":0,"docs":{},"r":{"df":0,"docs":{},"m":{"df":0,"docs":{},"i":{"df":0,"docs":{},"n":{"df":1,"docs":{"5":{"tf":1.0}}}}}}}},"v":{"b":{"df":0,"docs":{},"o":{"a":{"df":0,"docs":{},"r":{"d":{"df":1,"docs":{"25":{"tf":1.0}}},"df":0,"docs":{}}},"df":0,"docs":{}}},"df":0,"docs":{},"e":{"df":0,"docs":{},"l":{"df":0,"docs":{},"o":{"df":0,"docs":{},"p":{"df":5,"docs":{"20":{"tf":1.0},"21":{"tf":1.4142135623730951},"35":{"tf":1.0},"36":{"tf":1.0},"42":{"tf":1.0}}}}}}}},"i":{"a":{"df":0,"docs":{},"g":{"df":0,"docs":{},"r":{"a":{"df":0,"docs":{},"m":{"df":4,"docs":{"14":{"tf":1.4142135623730951},"2":{"tf":1.0},"3":{"tf":1.7320508075688772},"32":{"tf":1.0}}}},"df":0,"docs":{}}},"m":{"df":0,"docs":{},"e":{"df":0,"docs":{},"t":{"df":2,"docs":{"44":{"tf":1.0},"50":{"tf":1.0}}}}}},"d":{"df":0,"docs":{},"n":{"'":{"df":0,"docs":{},"t":{"df":2,"docs":{"10":{"tf":1.0},"47":{"tf":1.0}}}},"df":0,"docs":{}}},"df":0,"docs":{},"m":{"df":0,"docs":{},"e":{"df":0,"docs":{},"n":{"df":0,"docs":{},"s":{"df":1,"docs":{"32":{"tf":1.4142135623730951}}}}}},"r":{"df":0,"docs":{},"e":{"c":{"df":0,"docs":{},"t":{"df":2,"docs":{"3":{"tf":1.0},"44":{"tf":1.4142135623730951}},"l":{"df":0,"docs":{},"i":{"df":1,"docs":{"32":{"tf":1.0}}}}}},"df":0,"docs":{}}},"s":{"c":{"df":0,"docs":{},"u":{"df":0,"docs":{},"s":{"df":0,"docs":{},"s":{"df":3,"docs":{"2":{"tf":1.4142135623730951},"3":{"tf":1.0},"5":{"tf":1.0}}}}}},"df":0,"docs":{},"t":{"df":0,"docs":{},"r":{"df":0,"docs":{},"i":{"b":{"df":0,"docs":{},"u":{"df":0,"docs":{},"t":{"df":1,"docs":{"32":{"tf":1.0}}}}},"df":0,"docs":{}}}}},"v":{"df":0,"docs":{},"i":{"d":{"df":1,"docs":{"14":{"tf":1.0}}},"df":0,"docs":{}}}},"o":{"c":{"df":3,"docs":{"11":{"tf":1.0},"50":{"tf":1.0},"6":{"tf":1.0}},"u":{"df":0,"docs":{},"m":{"df":0,"docs":{},"e":{"df":0,"docs":{},"n":{"df":0,"docs":{},"t":{"df":3,"docs":{"3":{"tf":2.6457513110645907},"50":{"tf":1.0},"8":{"tf":1.0}}}}}}}},"df":0,"docs":{},"n":{"df":0,"docs":{},"e":{"df":2,"docs":{"24":{"tf":1.0},"39":{"tf":1.0}}},"g":{"df":0,"docs":{},"m":{"df":1,"docs":{"1":{"tf":1.0}}}}}},"r":{"a":{"df":0,"docs":{},"w":{"c":{"df":0,"docs":{},"i":{"df":0,"docs":{},"r":{"c":{"df":0,"docs":{},"l":{"df":1,"docs":{"50":{"tf":1.0}}}},"df":0,"docs":{}}}},"df":1,"docs":{"50":{"tf":1.4142135623730951}},"s":{"df":0,"docs":{},"q":{"df":0,"docs":{},"u":{"a":{"df":0,"docs":{},"r":{"df":1,"docs":{"50":{"tf":1.0}}}},"df":0,"docs":{}}}}}},"df":0,"docs":{},"e":{"df":0,"docs":{},"w":{"df":1,"docs":{"50":{"tf":1.0}}}},"i":{"df":0,"docs":{},"f":{"df":0,"docs":{},"t":{"df":1,"docs":{"50":{"tf":1.0}}}},"v":{"df":0,"docs":{},"e":{"df":0,"docs":{},"r":{"df":7,"docs":{"14":{"tf":1.4142135623730951},"20":{"tf":1.0},"21":{"tf":1.7320508075688772},"22":{"tf":1.0},"33":{"tf":1.0},"51":{"tf":1.0},"9":{"tf":1.0}}}}}}},"u":{"df":0,"docs":{},"e":{"df":2,"docs":{"39":{"tf":1.0},"50":{"tf":1.0}}},"r":{"df":0,"docs":{},"e":{"df":4,"docs":{"21":{"tf":1.4142135623730951},"3":{"tf":1.0},"32":{"tf":1.0},"46":{"tf":1.0}}}},"t":{"df":0,"docs":{},"i":{"df":2,"docs":{"37":{"tf":3.1622776601683795},"38":{"tf":1.0}}},"y":{"_":{"df":0,"docs":{},"r":{"df":0,"docs":{},"e":{"df":0,"docs":{},"s":{"df":0,"docs":{},"o":{"df":0,"docs":{},"l":{"df":0,"docs":{},"u":{"df":0,"docs":{},"t":{"df":1,"docs":{"37":{"tf":1.0}}}}}}}}}},"df":0,"docs":{}}}}},"df":0,"docs":{},"e":{"(":{"df":0,"docs":{},"t":{")":{"=":{"df":0,"docs":{},"s":{"df":0,"docs":{},"e":{"df":0,"docs":{},"t":{"df":0,"docs":{},"p":{"df":0,"docs":{},"o":{"df":0,"docs":{},"i":{"df":0,"docs":{},"n":{"df":0,"docs":{},"t":{"df":0,"docs":{},"r":{"df":0,"docs":{},"p":{"df":0,"docs":{},"m":{"df":0,"docs":{},"−":{"a":{"c":{"df":0,"docs":{},"t":{"df":0,"docs":{},"u":{"a":{"df":0,"docs":{},"l":{"df":0,"docs":{},"r":{"df":0,"docs":{},"p":{"df":0,"docs":{},"m":{"df":1,"docs":{"45":{"tf":1.0}}}}}}},"df":0,"docs":{}}}},"df":0,"docs":{}},"df":0,"docs":{}}}}}}}}}}}}}},"df":0,"docs":{}},"df":1,"docs":{"45":{"tf":1.0}}}},"a":{"c":{"df":0,"docs":{},"h":{"df":3,"docs":{"14":{"tf":1.0},"3":{"tf":1.0},"37":{"tf":1.0}}}},"df":0,"docs":{},"r":{"df":0,"docs":{},"l":{"df":0,"docs":{},"i":{"df":1,"docs":{"50":{"tf":1.0}},"e":{"df":0,"docs":{},"r":{"df":1,"docs":{"6":{"tf":1.0}}}}}}},"s":{"df":0,"docs":{},"i":{"df":1,"docs":{"32":{"tf":1.0}},"e":{"df":0,"docs":{},"r":{"df":1,"docs":{"28":{"tf":1.0}}}}}}},"c":{"df":0,"docs":{},"e":{"1":{"1":{"0":{"df":1,"docs":{"6":{"tf":1.0}}},"df":0,"docs":{}},"df":0,"docs":{}},"df":0,"docs":{}}},"d":{"df":0,"docs":{},"g":{"df":3,"docs":{"20":{"tf":1.0},"21":{"tf":1.0},"28":{"tf":1.0}}}},"df":0,"docs":{},"f":{"df":0,"docs":{},"f":{"df":0,"docs":{},"e":{"c":{"df":0,"docs":{},"t":{"df":1,"docs":{"28":{"tf":1.0}}}},"df":0,"docs":{}},"i":{"c":{"df":0,"docs":{},"i":{"df":1,"docs":{"14":{"tf":1.0}}}},"df":0,"docs":{}}}},"l":{"df":0,"docs":{},"e":{"c":{"df":0,"docs":{},"t":{"df":0,"docs":{},"r":{"df":0,"docs":{},"o":{"df":0,"docs":{},"l":{"df":0,"docs":{},"y":{"df":0,"docs":{},"t":{"df":1,"docs":{"21":{"tf":1.0}}}}}}}}},"df":0,"docs":{}}},"n":{"c":{"df":0,"docs":{},"o":{"d":{"df":5,"docs":{"28":{"tf":1.0},"29":{"tf":1.0},"50":{"tf":1.4142135623730951},"51":{"tf":1.0},"52":{"tf":1.4142135623730951}}},"df":0,"docs":{},"u":{"df":0,"docs":{},"n":{"df":0,"docs":{},"t":{"df":2,"docs":{"21":{"tf":1.0},"39":{"tf":1.0}}}}}}},"d":{"df":0,"docs":{},"p":{"df":0,"docs":{},"o":{"df":0,"docs":{},"i":{"df":0,"docs":{},"n":{"df":0,"docs":{},"t":{"df":1,"docs":{"50":{"tf":1.0}}}}}}}},"df":0,"docs":{},"f":{"df":0,"docs":{},"o":{"df":0,"docs":{},"r":{"c":{"df":1,"docs":{"50":{"tf":1.0}}},"df":0,"docs":{}}}},"o":{"df":0,"docs":{},"u":{"df":0,"docs":{},"g":{"df":0,"docs":{},"h":{"df":2,"docs":{"10":{"tf":1.0},"18":{"tf":1.0}}}}}},"s":{"df":0,"docs":{},"u":{"df":0,"docs":{},"r":{"df":16,"docs":{"13":{"tf":1.0},"14":{"tf":1.4142135623730951},"15":{"tf":1.0},"21":{"tf":1.4142135623730951},"22":{"tf":1.0},"28":{"tf":1.0},"29":{"tf":1.0},"3":{"tf":1.7320508075688772},"32":{"tf":1.7320508075688772},"38":{"tf":1.4142135623730951},"39":{"tf":1.4142135623730951},"44":{"tf":1.0},"46":{"tf":1.0},"50":{"tf":1.4142135623730951},"51":{"tf":1.0},"9":{"tf":1.0}}}}},"t":{"df":0,"docs":{},"r":{"df":0,"docs":{},"i":{"df":12,"docs":{"0":{"tf":1.0},"12":{"tf":1.0},"16":{"tf":1.0},"19":{"tf":1.0},"23":{"tf":1.0},"26":{"tf":1.0},"30":{"tf":1.0},"34":{"tf":1.0},"4":{"tf":1.0},"41":{"tf":1.0},"48":{"tf":1.0},"7":{"tf":1.0}}}}}},"q":{"df":0,"docs":{},"u":{"a":{"df":0,"docs":{},"t":{"df":2,"docs":{"44":{"tf":1.0},"45":{"tf":1.0}}}},"df":0,"docs":{}}},"r":{"df":0,"docs":{},"r":{"df":0,"docs":{},"o":{"df":0,"docs":{},"r":{"df":4,"docs":{"39":{"tf":1.0},"45":{"tf":2.449489742783178},"46":{"tf":1.7320508075688772},"50":{"tf":1.7320508075688772}}}}}},"s":{"df":0,"docs":{},"p":{"3":{"2":{"df":9,"docs":{"14":{"tf":1.4142135623730951},"20":{"tf":1.0},"21":{"tf":2.6457513110645907},"28":{"tf":1.4142135623730951},"35":{"tf":1.0},"36":{"tf":1.0},"50":{"tf":1.4142135623730951},"51":{"tf":1.0},"9":{"tf":1.0}}},"df":0,"docs":{}},"_":{"df":0,"docs":{},"e":{"df":0,"docs":{},"r":{"df":0,"docs":{},"r":{"_":{"df":0,"docs":{},"t":{"df":1,"docs":{"37":{"tf":1.0}}}},"df":0,"docs":{}}}},"t":{"df":0,"docs":{},"i":{"df":0,"docs":{},"m":{"df":0,"docs":{},"e":{"df":0,"docs":{},"r":{"_":{"df":0,"docs":{},"g":{"df":0,"docs":{},"e":{"df":0,"docs":{},"t":{"_":{"df":0,"docs":{},"t":{"df":0,"docs":{},"i":{"df":0,"docs":{},"m":{"df":1,"docs":{"50":{"tf":1.0}}}}}},"df":0,"docs":{}}}}},"df":0,"docs":{}}}}}}},"df":0,"docs":{},"e":{"c":{"df":0,"docs":{},"i":{"df":1,"docs":{"14":{"tf":1.0}}}},"df":0,"docs":{}}}},"t":{"df":0,"docs":{},"h":{"df":0,"docs":{},"i":{"c":{"df":1,"docs":{"3":{"tf":1.0}}},"df":0,"docs":{}}}},"v":{"df":0,"docs":{},"e":{"df":0,"docs":{},"n":{"df":1,"docs":{"50":{"tf":1.4142135623730951}}}}},"x":{"a":{"df":0,"docs":{},"m":{"df":0,"docs":{},"p":{"df":0,"docs":{},"l":{"df":2,"docs":{"3":{"tf":1.4142135623730951},"37":{"tf":1.0}}}}}},"c":{"df":0,"docs":{},"e":{"df":0,"docs":{},"e":{"d":{"df":1,"docs":{"50":{"tf":1.0}}},"df":0,"docs":{}},"s":{"df":0,"docs":{},"s":{"df":1,"docs":{"46":{"tf":1.0}}}}}},"df":0,"docs":{},"e":{"c":{"df":0,"docs":{},"u":{"df":0,"docs":{},"t":{"df":1,"docs":{"50":{"tf":1.0}}}}},"df":0,"docs":{}},"p":{"df":0,"docs":{},"e":{"c":{"df":0,"docs":{},"t":{"df":3,"docs":{"3":{"tf":1.0},"38":{"tf":1.0},"50":{"tf":1.4142135623730951}}}},"df":0,"docs":{},"n":{"df":0,"docs":{},"s":{"df":1,"docs":{"6":{"tf":1.0}}}}},"l":{"a":{"df":0,"docs":{},"n":{"df":1,"docs":{"37":{"tf":1.0}}}},"df":0,"docs":{}},"o":{"df":0,"docs":{},"r":{"df":0,"docs":{},"t":{"df":3,"docs":{"21":{"tf":1.0},"28":{"tf":1.0},"29":{"tf":1.0}}}}}},"t":{"df":0,"docs":{},"e":{"df":0,"docs":{},"n":{"d":{"df":1,"docs":{"28":{"tf":1.0}}},"df":0,"docs":{}}}}}},"f":{"a":{"c":{"df":0,"docs":{},"i":{"df":0,"docs":{},"l":{"df":0,"docs":{},"i":{"df":0,"docs":{},"t":{"df":1,"docs":{"28":{"tf":1.0}}}}}}},"df":1,"docs":{"3":{"tf":1.0}},"i":{"df":0,"docs":{},"l":{"df":0,"docs":{},"u":{"df":0,"docs":{},"r":{"df":2,"docs":{"39":{"tf":1.0},"51":{"tf":1.0}}}}}}},"df":0,"docs":{},"e":{"a":{"df":0,"docs":{},"s":{"df":0,"docs":{},"i":{"b":{"df":0,"docs":{},"l":{"df":1,"docs":{"2":{"tf":1.0}}}},"df":0,"docs":{}}}},"df":0,"docs":{},"e":{"d":{"b":{"a":{"c":{"df":0,"docs":{},"k":{"df":10,"docs":{"14":{"tf":1.0},"2":{"tf":1.0},"22":{"tf":1.0},"27":{"tf":1.0},"28":{"tf":1.4142135623730951},"3":{"tf":1.7320508075688772},"32":{"tf":1.0},"40":{"tf":1.0},"50":{"tf":1.0},"52":{"tf":1.0}}}},"df":0,"docs":{}},"df":0,"docs":{}},"df":0,"docs":{}},"df":0,"docs":{}}},"i":{"d":{"d":{"df":0,"docs":{},"l":{"df":1,"docs":{"52":{"tf":1.0}}}},"df":0,"docs":{}},"df":4,"docs":{"20":{"tf":1.0},"21":{"tf":1.4142135623730951},"50":{"tf":1.4142135623730951},"9":{"tf":1.0}},"g":{"df":0,"docs":{},"m":{"a":{"df":1,"docs":{"24":{"tf":1.0}}},"df":0,"docs":{}},"u":{"df":0,"docs":{},"r":{"df":1,"docs":{"2":{"tf":1.0}}}}},"l":{"df":0,"docs":{},"t":{"df":0,"docs":{},"e":{"df":0,"docs":{},"r":{"df":2,"docs":{"21":{"tf":1.0},"40":{"tf":1.0}}}}}},"n":{"a":{"df":0,"docs":{},"l":{"df":12,"docs":{"15":{"tf":1.0},"17":{"tf":1.0},"2":{"tf":1.0},"20":{"tf":1.0},"21":{"tf":1.0},"3":{"tf":1.0},"31":{"tf":1.0},"32":{"tf":1.0},"33":{"tf":1.0},"50":{"tf":1.7320508075688772},"6":{"tf":1.0},"8":{"tf":1.4142135623730951}}}},"df":0,"docs":{},"e":{"df":1,"docs":{"18":{"tf":1.0}}},"i":{"df":0,"docs":{},"s":{"df":0,"docs":{},"h":{"df":1,"docs":{"49":{"tf":1.4142135623730951}}}}}},"r":{"df":0,"docs":{},"s":{"df":0,"docs":{},"t":{"df":2,"docs":{"1":{"tf":1.0},"6":{"tf":1.0}}}}},"t":{"df":1,"docs":{"9":{"tf":1.0}}},"x":{"df":4,"docs":{"10":{"tf":1.0},"11":{"tf":1.4142135623730951},"47":{"tf":1.0},"50":{"tf":1.7320508075688772}}}},"l":{"a":{"df":0,"docs":{},"s":{"df":0,"docs":{},"k":{"df":1,"docs":{"50":{"tf":1.4142135623730951}}}}},"df":0,"docs":{},"o":{"a":{"df":0,"docs":{},"t":{"df":1,"docs":{"45":{"tf":1.4142135623730951}}}},"df":0,"docs":{},"w":{"df":2,"docs":{"14":{"tf":1.0},"3":{"tf":1.0}}}}},"o":{"c":{"df":0,"docs":{},"u":{"df":0,"docs":{},"s":{"df":3,"docs":{"15":{"tf":1.0},"21":{"tf":1.0},"36":{"tf":1.0}}}}},"df":0,"docs":{},"l":{"d":{"df":0,"docs":{},"e":{"df":0,"docs":{},"r":{"df":1,"docs":{"50":{"tf":1.0}}}}},"df":0,"docs":{},"l":{"df":0,"docs":{},"o":{"df":0,"docs":{},"w":{"df":3,"docs":{"28":{"tf":1.0},"3":{"tf":1.0},"45":{"tf":1.0}}}}}},"o":{"df":0,"docs":{},"t":{"df":0,"docs":{},"p":{"df":0,"docs":{},"r":{"df":0,"docs":{},"i":{"df":0,"docs":{},"n":{"df":0,"docs":{},"t":{"df":4,"docs":{"10":{"tf":1.0},"20":{"tf":1.0},"21":{"tf":1.4142135623730951},"28":{"tf":1.0}}}}}}}}},"r":{"df":0,"docs":{},"m":{"df":0,"docs":{},"u":{"df":0,"docs":{},"l":{"a":{"df":2,"docs":{"14":{"tf":1.0},"44":{"tf":1.0}}},"df":0,"docs":{}}}}},"u":{"df":0,"docs":{},"n":{"d":{"df":1,"docs":{"6":{"tf":1.0}}},"df":0,"docs":{}}}},"r":{"a":{"df":0,"docs":{},"m":{"df":0,"docs":{},"e":{"df":1,"docs":{"44":{"tf":1.0}}}}},"df":0,"docs":{},"e":{"df":0,"docs":{},"q":{"_":{"df":0,"docs":{},"h":{"df":0,"docs":{},"z":{"df":1,"docs":{"37":{"tf":1.0}}}}},"df":0,"docs":{},"u":{"df":0,"docs":{},"e":{"df":0,"docs":{},"n":{"c":{"df":3,"docs":{"36":{"tf":1.0},"37":{"tf":1.0},"39":{"tf":1.0}}},"df":0,"docs":{}}}}}},"o":{"df":0,"docs":{},"n":{"df":0,"docs":{},"t":{"df":1,"docs":{"52":{"tf":1.0}}}}}},"u":{"df":0,"docs":{},"l":{"df":0,"docs":{},"l":{"df":1,"docs":{"37":{"tf":1.0}}}},"n":{"c":{"df":0,"docs":{},"t":{"df":0,"docs":{},"i":{"df":0,"docs":{},"o":{"df":0,"docs":{},"n":{"df":10,"docs":{"20":{"tf":1.0},"21":{"tf":1.4142135623730951},"27":{"tf":1.0},"29":{"tf":1.0},"3":{"tf":1.0},"33":{"tf":1.0},"35":{"tf":1.0},"37":{"tf":1.4142135623730951},"46":{"tf":1.0},"50":{"tf":1.7320508075688772}}}}}}},"df":0,"docs":{}},"t":{"df":0,"docs":{},"u":{"df":0,"docs":{},"r":{"df":3,"docs":{"21":{"tf":1.0},"40":{"tf":1.0},"46":{"tf":1.0}}}}}}},"g":{"a":{"df":0,"docs":{},"i":{"df":0,"docs":{},"n":{"df":1,"docs":{"45":{"tf":1.0}}}}},"df":0,"docs":{},"e":{"a":{"df":0,"docs":{},"r":{"df":1,"docs":{"9":{"tf":1.0}}}},"df":0,"docs":{},"n":{"df":0,"docs":{},"e":{"df":0,"docs":{},"r":{"df":2,"docs":{"31":{"tf":1.0},"32":{"tf":1.0}}}}}},"i":{"df":0,"docs":{},"t":{"df":0,"docs":{},"h":{"df":0,"docs":{},"u":{"b":{"df":2,"docs":{"49":{"tf":1.0},"50":{"tf":1.0}}},"df":0,"docs":{}}}}},"n":{"d":{"df":1,"docs":{"32":{"tf":1.0}}},"df":0,"docs":{}},"o":{"a":{"df":0,"docs":{},"l":{"df":1,"docs":{"3":{"tf":1.0}}}},"df":0,"docs":{},"o":{"d":{"df":1,"docs":{"21":{"tf":1.0}}},"df":0,"docs":{}}},"p":{"df":0,"docs":{},"i":{"df":0,"docs":{},"o":{"_":{"df":0,"docs":{},"h":{"df":0,"docs":{},"i":{"df":0,"docs":{},"g":{"df":0,"docs":{},"h":{"_":{"1":{"df":1,"docs":{"37":{"tf":1.0}}},"df":0,"docs":{}},"df":0,"docs":{}}}}}},"df":4,"docs":{"28":{"tf":1.0},"29":{"tf":1.0},"37":{"tf":1.4142135623730951},"47":{"tf":1.0}}}}},"r":{"df":0,"docs":{},"e":{"df":0,"docs":{},"g":{"df":0,"docs":{},"g":{"df":4,"docs":{"2":{"tf":1.0},"24":{"tf":1.0},"25":{"tf":1.0},"5":{"tf":1.0}}}}}},"u":{"df":0,"docs":{},"i":{"d":{"df":0,"docs":{},"e":{"df":0,"docs":{},"l":{"df":0,"docs":{},"i":{"df":0,"docs":{},"n":{"df":1,"docs":{"14":{"tf":1.0}}}}}}},"df":0,"docs":{}}}},"h":{"a":{"df":0,"docs":{},"n":{"d":{"df":0,"docs":{},"l":{"df":3,"docs":{"21":{"tf":1.0},"3":{"tf":1.0},"50":{"tf":1.0}}}},"df":0,"docs":{}},"r":{"d":{"df":0,"docs":{},"w":{"a":{"df":0,"docs":{},"r":{"df":3,"docs":{"39":{"tf":1.0},"40":{"tf":1.0},"51":{"tf":1.0}}}},"df":0,"docs":{}}},"df":0,"docs":{}}},"df":0,"docs":{},"e":{"df":0,"docs":{},"r":{"df":0,"docs":{},"e":{"df":2,"docs":{"11":{"tf":1.4142135623730951},"44":{"tf":1.0}}}}},"i":{"df":0,"docs":{},"g":{"df":0,"docs":{},"h":{"df":3,"docs":{"3":{"tf":1.0},"37":{"tf":1.0},"9":{"tf":1.0}}}}},"o":{"df":0,"docs":{},"p":{"df":0,"docs":{},"e":{"df":0,"docs":{},"f":{"df":0,"docs":{},"u":{"df":0,"docs":{},"l":{"df":0,"docs":{},"l":{"df":0,"docs":{},"i":{"df":1,"docs":{"18":{"tf":1.0}}}}}}}}}},"t":{"df":0,"docs":{},"t":{"df":0,"docs":{},"p":{"df":2,"docs":{"50":{"tf":1.0},"51":{"tf":1.0}}}}}},"i":{"d":{"df":0,"docs":{},"e":{"a":{"df":1,"docs":{"2":{"tf":1.0}}},"df":0,"docs":{},"n":{"df":0,"docs":{},"t":{"df":0,"docs":{},"i":{"df":0,"docs":{},"f":{"df":2,"docs":{"31":{"tf":1.0},"32":{"tf":1.0}},"i":{"df":2,"docs":{"21":{"tf":1.0},"32":{"tf":1.0}}}}}}}}},"df":0,"docs":{},"m":{"a":{"df":0,"docs":{},"g":{"df":1,"docs":{"21":{"tf":1.0}}}},"df":0,"docs":{},"m":{"df":0,"docs":{},"e":{"d":{"df":0,"docs":{},"i":{"df":1,"docs":{"46":{"tf":1.0}}}},"df":0,"docs":{}}},"p":{"df":0,"docs":{},"l":{"df":0,"docs":{},"e":{"df":0,"docs":{},"m":{"df":0,"docs":{},"e":{"df":0,"docs":{},"n":{"df":0,"docs":{},"t":{"df":7,"docs":{"36":{"tf":1.4142135623730951},"37":{"tf":1.0},"40":{"tf":1.0},"45":{"tf":1.4142135623730951},"50":{"tf":1.0},"51":{"tf":1.4142135623730951},"6":{"tf":1.4142135623730951}}}}}}}},"r":{"df":0,"docs":{},"o":{"df":0,"docs":{},"p":{"df":1,"docs":{"50":{"tf":1.0}}},"v":{"df":2,"docs":{"27":{"tf":1.0},"39":{"tf":1.0}}}}}},"u":{"df":1,"docs":{"21":{"tf":1.0}}}},"n":{"c":{"df":0,"docs":{},"l":{"df":0,"docs":{},"u":{"d":{"df":9,"docs":{"1":{"tf":1.0},"2":{"tf":1.0},"20":{"tf":1.0},"21":{"tf":1.0},"28":{"tf":1.0},"3":{"tf":1.0},"31":{"tf":1.0},"32":{"tf":1.0},"9":{"tf":1.0}}},"df":0,"docs":{}}},"o":{"df":0,"docs":{},"n":{"df":0,"docs":{},"s":{"df":0,"docs":{},"i":{"df":0,"docs":{},"s":{"df":0,"docs":{},"t":{"df":1,"docs":{"51":{"tf":1.0}}}}}}},"r":{"df":0,"docs":{},"p":{"df":0,"docs":{},"o":{"df":0,"docs":{},"r":{"df":1,"docs":{"14":{"tf":1.0}}}}},"r":{"df":0,"docs":{},"e":{"c":{"df":0,"docs":{},"t":{"df":1,"docs":{"50":{"tf":1.4142135623730951}}}},"df":0,"docs":{}}}}}},"d":{"df":0,"docs":{},"i":{"c":{"df":1,"docs":{"3":{"tf":1.0}}},"df":0,"docs":{}},"u":{"c":{"df":0,"docs":{},"t":{"df":0,"docs":{},"o":{"df":0,"docs":{},"r":{"df":4,"docs":{"20":{"tf":1.0},"21":{"tf":1.4142135623730951},"31":{"tf":1.0},"32":{"tf":1.0}}}}}},"df":0,"docs":{}}},"df":0,"docs":{},"i":{"df":0,"docs":{},"t":{"df":0,"docs":{},"i":{"df":5,"docs":{"2":{"tf":1.0},"38":{"tf":1.4142135623730951},"5":{"tf":1.0},"6":{"tf":1.0},"9":{"tf":1.0}}}}},"s":{"df":0,"docs":{},"t":{"a":{"b":{"df":0,"docs":{},"l":{"df":1,"docs":{"50":{"tf":1.0}}}},"df":0,"docs":{},"n":{"c":{"df":1,"docs":{"10":{"tf":1.0}}},"df":0,"docs":{}}},"df":0,"docs":{}}},"t":{"df":1,"docs":{"45":{"tf":1.0}},"e":{"df":0,"docs":{},"g":{"df":0,"docs":{},"r":{"df":9,"docs":{"21":{"tf":1.4142135623730951},"22":{"tf":1.0},"3":{"tf":1.0},"32":{"tf":1.0},"33":{"tf":1.0},"45":{"tf":1.7320508075688772},"46":{"tf":1.4142135623730951},"50":{"tf":1.7320508075688772},"9":{"tf":1.0}}}},"n":{"d":{"df":1,"docs":{"29":{"tf":1.0}}},"df":0,"docs":{}},"r":{"c":{"df":0,"docs":{},"o":{"df":0,"docs":{},"n":{"df":0,"docs":{},"n":{"df":0,"docs":{},"e":{"c":{"df":0,"docs":{},"t":{"df":1,"docs":{"14":{"tf":1.0}}}},"df":0,"docs":{}}}}}},"df":0,"docs":{},"f":{"a":{"c":{"df":5,"docs":{"10":{"tf":1.0},"20":{"tf":1.0},"21":{"tf":1.7320508075688772},"28":{"tf":1.0},"50":{"tf":1.0}}},"df":0,"docs":{}},"df":0,"docs":{}}}}}},"o":{"df":2,"docs":{"10":{"tf":1.0},"21":{"tf":1.0}}},"s":{"df":0,"docs":{},"r":{"df":2,"docs":{"50":{"tf":1.0},"51":{"tf":1.0}}},"s":{"df":0,"docs":{},"u":{"df":5,"docs":{"21":{"tf":1.4142135623730951},"47":{"tf":1.4142135623730951},"50":{"tf":2.23606797749979},"51":{"tf":1.4142135623730951},"52":{"tf":1.4142135623730951}}}}},"t":{"'":{"df":1,"docs":{"21":{"tf":1.0}}},"df":0,"docs":{},"e":{"df":0,"docs":{},"m":{"df":1,"docs":{"3":{"tf":1.0}}}},"s":{"df":0,"docs":{},"e":{"df":0,"docs":{},"l":{"df":0,"docs":{},"f":{"df":1,"docs":{"6":{"tf":1.0}}}}}}}},"j":{"df":0,"docs":{},"i":{"df":0,"docs":{},"t":{"df":0,"docs":{},"t":{"df":0,"docs":{},"e":{"df":0,"docs":{},"r":{"df":1,"docs":{"39":{"tf":1.4142135623730951}}}}}}},"s":{"df":0,"docs":{},"o":{"df":0,"docs":{},"n":{"df":1,"docs":{"50":{"tf":1.0}}}}}},"k":{"d":{"df":3,"docs":{"45":{"tf":1.4142135623730951},"46":{"tf":1.0},"50":{"tf":1.0}},"":{"df":0,"docs":{},"⋅":{"d":{"df":0,"docs":{},"t":{"d":{"df":0,"docs":{},"e":{"(":{"df":0,"docs":{},"t":{"df":1,"docs":{"46":{"tf":1.0}}}},"df":0,"docs":{}}},"df":0,"docs":{}}},"df":0,"docs":{}}}},"df":0,"docs":{},"e":{"df":0,"docs":{},"y":{"df":1,"docs":{"36":{"tf":1.0}}}},"i":{"df":2,"docs":{"45":{"tf":1.4142135623730951},"50":{"tf":1.0}},"n":{"df":0,"docs":{},"e":{"df":0,"docs":{},"m":{"a":{"df":0,"docs":{},"t":{"df":4,"docs":{"44":{"tf":1.0},"49":{"tf":1.4142135623730951},"50":{"tf":1.7320508075688772},"52":{"tf":1.0}},"i":{"c":{"df":0,"docs":{},"s":{".":{"c":{"df":0,"docs":{},"p":{"df":0,"docs":{},"p":{"df":2,"docs":{"44":{"tf":1.0},"50":{"tf":1.0}}}}},"df":0,"docs":{}},"df":0,"docs":{}}},"df":0,"docs":{}}}},"df":0,"docs":{}}}},"":{"df":0,"docs":{},"⋅":{"df":0,"docs":{},"∫":{"df":0,"docs":{},"e":{"(":{"df":0,"docs":{},"t":{")":{"d":{"df":0,"docs":{},"t":{"df":1,"docs":{"46":{"tf":1.0}}}},"df":0,"docs":{}},"df":0,"docs":{}}},"df":0,"docs":{}}}}}},"p":{"df":3,"docs":{"45":{"tf":1.4142135623730951},"46":{"tf":1.0},"50":{"tf":1.0}},"":{"df":0,"docs":{},"⋅":{"df":0,"docs":{},"e":{"(":{"df":0,"docs":{},"t":{"df":1,"docs":{"46":{"tf":1.0}}}},"df":0,"docs":{}}}}}},"l":{"a":{"b":{"df":12,"docs":{"0":{"tf":1.0},"12":{"tf":1.0},"16":{"tf":1.0},"19":{"tf":1.0},"23":{"tf":1.0},"26":{"tf":1.0},"30":{"tf":1.0},"34":{"tf":1.0},"4":{"tf":1.0},"41":{"tf":1.0},"48":{"tf":1.0},"7":{"tf":1.0}},"e":{"df":0,"docs":{},"l":{"df":2,"docs":{"14":{"tf":1.0},"3":{"tf":1.4142135623730951}}}}},"df":0,"docs":{},"r":{"df":0,"docs":{},"g":{"df":1,"docs":{"50":{"tf":1.0}}}},"s":{"df":0,"docs":{},"t":{"df":1,"docs":{"47":{"tf":1.0}}}},"t":{"df":0,"docs":{},"e":{"df":1,"docs":{"47":{"tf":1.0}},"n":{"c":{"df":1,"docs":{"50":{"tf":1.0}}},"df":0,"docs":{}}}},"y":{"df":0,"docs":{},"o":{"df":0,"docs":{},"u":{"df":0,"docs":{},"t":{"df":8,"docs":{"15":{"tf":1.0},"21":{"tf":1.0},"22":{"tf":1.0},"27":{"tf":1.0},"28":{"tf":1.0},"31":{"tf":1.0},"32":{"tf":2.0},"33":{"tf":1.0}}}}}}},"df":1,"docs":{"32":{"tf":1.0}},"e":{"a":{"df":0,"docs":{},"r":{"df":0,"docs":{},"n":{"df":1,"docs":{"18":{"tf":1.0}}}}},"d":{"c":{"_":{"a":{"df":0,"docs":{},"u":{"df":0,"docs":{},"t":{"df":0,"docs":{},"o":{"_":{"c":{"df":0,"docs":{},"l":{"df":0,"docs":{},"k":{"df":1,"docs":{"37":{"tf":1.0}}}}},"df":0,"docs":{}},"df":0,"docs":{}}}}},"df":0,"docs":{},"s":{"df":0,"docs":{},"e":{"df":0,"docs":{},"t":{"_":{"d":{"df":0,"docs":{},"u":{"df":0,"docs":{},"t":{"df":0,"docs":{},"y":{"(":{"df":0,"docs":{},"p":{"df":0,"docs":{},"w":{"df":0,"docs":{},"m":{"_":{"df":0,"docs":{},"m":{"df":0,"docs":{},"o":{"d":{"df":1,"docs":{"37":{"tf":1.0}}},"df":0,"docs":{}}}},"df":0,"docs":{}}}}},"df":0,"docs":{}}}}},"df":0,"docs":{}},"df":0,"docs":{}}}},"t":{"df":0,"docs":{},"i":{"df":0,"docs":{},"m":{"df":1,"docs":{"37":{"tf":1.0}},"e":{"df":0,"docs":{},"r":{"_":{"c":{"df":0,"docs":{},"o":{"df":0,"docs":{},"n":{"df":0,"docs":{},"f":{"df":0,"docs":{},"i":{"df":0,"docs":{},"g":{"(":{"&":{"df":0,"docs":{},"l":{"df":0,"docs":{},"e":{"d":{"c":{"_":{"df":0,"docs":{},"t":{"df":0,"docs":{},"i":{"df":0,"docs":{},"m":{"df":1,"docs":{"37":{"tf":1.0}}}}}},"df":0,"docs":{}},"df":0,"docs":{}},"df":0,"docs":{}}}},"df":0,"docs":{}},"_":{"df":0,"docs":{},"t":{"df":1,"docs":{"37":{"tf":1.0}}}},"df":1,"docs":{"39":{"tf":1.0}}}}}}}},"df":0,"docs":{}},"df":0,"docs":{}}}}}},"u":{"df":0,"docs":{},"p":{"d":{"a":{"df":0,"docs":{},"t":{"df":0,"docs":{},"e":{"_":{"d":{"df":0,"docs":{},"u":{"df":0,"docs":{},"t":{"df":0,"docs":{},"y":{"(":{"df":0,"docs":{},"p":{"df":0,"docs":{},"w":{"df":0,"docs":{},"m":{"_":{"df":0,"docs":{},"m":{"df":0,"docs":{},"o":{"d":{"df":1,"docs":{"37":{"tf":1.0}}},"df":0,"docs":{}}}},"df":0,"docs":{}}}}},"df":0,"docs":{}}}}},"df":0,"docs":{}},"df":0,"docs":{}}}},"df":0,"docs":{}},"df":0,"docs":{}}}},"df":0,"docs":{}},"df":0,"docs":{}},"df":0,"docs":{},"n":{"d":{"df":1,"docs":{"6":{"tf":1.0}}},"df":0,"docs":{}},"s":{"df":0,"docs":{},"s":{"df":1,"docs":{"6":{"tf":1.4142135623730951}}}},"v":{"df":0,"docs":{},"e":{"df":0,"docs":{},"l":{"df":3,"docs":{"3":{"tf":1.0},"49":{"tf":1.0},"9":{"tf":1.0}}}}}},"i":{"df":1,"docs":{"52":{"tf":1.0}},"m":{"df":0,"docs":{},"i":{"df":0,"docs":{},"t":{"df":3,"docs":{"3":{"tf":1.0},"39":{"tf":1.0},"50":{"tf":1.0}}}}},"n":{"df":0,"docs":{},"e":{"a":{"df":0,"docs":{},"r":{"df":2,"docs":{"44":{"tf":1.7320508075688772},"50":{"tf":1.0}}}},"df":3,"docs":{"14":{"tf":1.4142135623730951},"3":{"tf":1.0},"52":{"tf":1.0}}}},"s":{"df":0,"docs":{},"t":{"df":2,"docs":{"31":{"tf":1.0},"32":{"tf":1.0}}}}},"o":{"a":{"d":{"df":4,"docs":{"14":{"tf":1.0},"15":{"tf":1.0},"22":{"tf":1.0},"3":{"tf":1.0}}},"df":0,"docs":{}},"c":{"a":{"df":0,"docs":{},"t":{"df":1,"docs":{"32":{"tf":1.0}}}},"df":0,"docs":{}},"df":0,"docs":{},"g":{"df":1,"docs":{"51":{"tf":1.7320508075688772}},"i":{"df":0,"docs":{},"n":{"/":{"df":0,"docs":{},"l":{"df":0,"docs":{},"o":{"df":0,"docs":{},"g":{"df":0,"docs":{},"o":{"df":0,"docs":{},"u":{"df":0,"docs":{},"t":{"df":1,"docs":{"50":{"tf":1.0}}}}}}}}},"df":0,"docs":{}}}},"o":{"df":0,"docs":{},"p":{"df":2,"docs":{"37":{"tf":1.0},"50":{"tf":1.0}}}}}},"m":{"a":{"c":{"df":0,"docs":{},"h":{"df":0,"docs":{},"i":{"df":0,"docs":{},"n":{"df":1,"docs":{"5":{"tf":1.0}}}}}},"d":{"df":0,"docs":{},"e":{"df":1,"docs":{"28":{"tf":1.0}}}},"df":0,"docs":{},"i":{"df":0,"docs":{},"n":{"df":3,"docs":{"10":{"tf":1.4142135623730951},"6":{"tf":1.0},"9":{"tf":1.0}},"l":{"df":0,"docs":{},"i":{"df":1,"docs":{"11":{"tf":1.0}}}}}},"k":{"df":0,"docs":{},"e":{"df":2,"docs":{"27":{"tf":1.0},"6":{"tf":1.0}}}},"p":{"df":3,"docs":{"14":{"tf":1.0},"32":{"tf":1.0},"37":{"tf":1.0}}},"t":{"c":{"df":0,"docs":{},"h":{"df":1,"docs":{"38":{"tf":1.0}}}},"df":0,"docs":{},"h":{"df":0,"docs":{},"e":{"df":0,"docs":{},"m":{"a":{"df":0,"docs":{},"t":{"df":5,"docs":{"37":{"tf":1.0},"42":{"tf":1.0},"44":{"tf":1.0},"46":{"tf":1.0},"50":{"tf":1.0}}}},"df":0,"docs":{}}}},"t":{"df":1,"docs":{"6":{"tf":1.0}}}},"x":{"df":0,"docs":{},"i":{"df":0,"docs":{},"m":{"df":0,"docs":{},"u":{"df":0,"docs":{},"m":{"df":1,"docs":{"37":{"tf":1.0}}}}}}}},"df":0,"docs":{},"e":{"a":{"df":0,"docs":{},"n":{"df":1,"docs":{"52":{"tf":1.0}}},"s":{"df":0,"docs":{},"u":{"df":0,"docs":{},"r":{"df":2,"docs":{"14":{"tf":1.0},"40":{"tf":1.0}}}}}},"c":{"df":0,"docs":{},"h":{"a":{"df":0,"docs":{},"n":{"df":1,"docs":{"9":{"tf":1.0}}}},"df":0,"docs":{}}},"df":0,"docs":{},"e":{"df":0,"docs":{},"t":{"df":7,"docs":{"1":{"tf":1.0},"10":{"tf":1.0},"14":{"tf":1.7320508075688772},"18":{"tf":1.0},"21":{"tf":1.0},"28":{"tf":1.0},"3":{"tf":1.7320508075688772}}}}},"i":{"df":0,"docs":{},"n":{"df":0,"docs":{},"i":{"df":0,"docs":{},"m":{"df":2,"docs":{"15":{"tf":1.0},"46":{"tf":1.0}},"u":{"df":0,"docs":{},"m":{"df":1,"docs":{"37":{"tf":1.0}}}}}},"o":{"df":0,"docs":{},"r":{"df":2,"docs":{"21":{"tf":1.0},"38":{"tf":1.0}}}}},"s":{"b":{"df":0,"docs":{},"e":{"df":0,"docs":{},"h":{"a":{"df":0,"docs":{},"v":{"df":0,"docs":{},"i":{"df":0,"docs":{},"o":{"df":0,"docs":{},"r":{"df":1,"docs":{"50":{"tf":1.0}}}}}}},"df":0,"docs":{}}}},"df":0,"docs":{},"m":{"a":{"df":0,"docs":{},"t":{"c":{"df":0,"docs":{},"h":{"df":1,"docs":{"50":{"tf":1.0}}}},"df":0,"docs":{}}},"df":0,"docs":{}}},"t":{"df":0,"docs":{},"i":{"df":0,"docs":{},"g":{"df":1,"docs":{"3":{"tf":1.0}}}}}},"j":{"df":0,"docs":{},"p":{"a":{"df":0,"docs":{},"u":{"df":0,"docs":{},"l":{"3":{"df":3,"docs":{"2":{"tf":1.0},"32":{"tf":1.0},"6":{"tf":1.0}}},"df":0,"docs":{}}}},"df":0,"docs":{}}},"o":{"c":{"df":0,"docs":{},"k":{"df":0,"docs":{},"u":{"df":0,"docs":{},"p":{"df":2,"docs":{"21":{"tf":1.0},"24":{"tf":1.0}}}}}},"d":{"df":0,"docs":{},"e":{"df":0,"docs":{},"l":{"df":7,"docs":{"10":{"tf":1.0},"42":{"tf":1.0},"44":{"tf":1.4142135623730951},"45":{"tf":1.4142135623730951},"46":{"tf":1.0},"50":{"tf":1.0},"9":{"tf":1.0}}}},"u":{"df":0,"docs":{},"l":{"df":1,"docs":{"50":{"tf":1.0}}}}},"df":0,"docs":{},"n":{"df":0,"docs":{},"i":{"df":0,"docs":{},"t":{"df":0,"docs":{},"o":{"df":0,"docs":{},"r":{"df":2,"docs":{"28":{"tf":1.0},"51":{"tf":1.0}}}}}}},"r":{"df":0,"docs":{},"e":{"df":2,"docs":{"10":{"tf":1.0},"6":{"tf":1.0}}},"n":{"df":2,"docs":{"50":{"tf":1.4142135623730951},"52":{"tf":1.0}}}},"t":{"df":0,"docs":{},"i":{"df":0,"docs":{},"o":{"df":0,"docs":{},"n":{"df":4,"docs":{"3":{"tf":1.0},"37":{"tf":1.0},"46":{"tf":1.0},"6":{"tf":1.0}}}}},"o":{"df":0,"docs":{},"r":{"_":{"c":{"df":0,"docs":{},"o":{"df":0,"docs":{},"n":{"df":0,"docs":{},"t":{"df":0,"docs":{},"r":{"df":0,"docs":{},"o":{"df":0,"docs":{},"l":{"df":1,"docs":{"50":{"tf":1.0}}}}}}}}},"df":0,"docs":{},"m":{"a":{"df":0,"docs":{},"x":{"_":{"df":0,"docs":{},"s":{"df":0,"docs":{},"p":{"df":0,"docs":{},"e":{"df":2,"docs":{"45":{"tf":1.4142135623730951},"50":{"tf":1.0}}}}}},"df":0,"docs":{}}},"df":0,"docs":{}}},"df":24,"docs":{"14":{"tf":1.7320508075688772},"20":{"tf":1.0},"21":{"tf":2.449489742783178},"22":{"tf":1.4142135623730951},"24":{"tf":1.0},"28":{"tf":1.0},"3":{"tf":1.4142135623730951},"31":{"tf":1.0},"32":{"tf":2.23606797749979},"33":{"tf":1.0},"35":{"tf":1.4142135623730951},"36":{"tf":1.0},"37":{"tf":1.0},"38":{"tf":1.4142135623730951},"44":{"tf":1.0},"45":{"tf":1.4142135623730951},"46":{"tf":1.4142135623730951},"47":{"tf":1.0},"5":{"tf":1.0},"50":{"tf":1.7320508075688772},"51":{"tf":1.0},"52":{"tf":1.0},"6":{"tf":1.0},"9":{"tf":1.7320508075688772}}}}},"u":{"df":0,"docs":{},"n":{"df":0,"docs":{},"t":{"df":1,"docs":{"32":{"tf":1.4142135623730951}}}}},"v":{"df":0,"docs":{},"e":{"df":4,"docs":{"28":{"tf":1.0},"33":{"tf":1.0},"37":{"tf":1.7320508075688772},"38":{"tf":1.0}},"f":{"df":0,"docs":{},"o":{"df":0,"docs":{},"r":{"df":0,"docs":{},"w":{"a":{"df":0,"docs":{},"r":{"d":{"df":1,"docs":{"50":{"tf":1.0}}},"df":0,"docs":{}}},"df":0,"docs":{}}}}},"m":{"df":0,"docs":{},"e":{"df":0,"docs":{},"n":{"df":0,"docs":{},"t":{"df":2,"docs":{"32":{"tf":1.0},"44":{"tf":1.0}}}}}}}}},"u":{"df":0,"docs":{},"l":{"df":0,"docs":{},"t":{"df":0,"docs":{},"i":{"df":0,"docs":{},"p":{"df":0,"docs":{},"l":{"df":1,"docs":{"18":{"tf":1.0}}}}}}}}},"n":{"df":0,"docs":{},"e":{"c":{"df":0,"docs":{},"e":{"df":0,"docs":{},"s":{"df":0,"docs":{},"s":{"a":{"df":0,"docs":{},"r":{"df":0,"docs":{},"i":{"df":4,"docs":{"20":{"tf":1.0},"21":{"tf":1.0},"27":{"tf":1.0},"32":{"tf":1.0}}}}},"df":0,"docs":{}}}}},"df":0,"docs":{},"e":{"d":{"df":2,"docs":{"10":{"tf":1.4142135623730951},"18":{"tf":1.0}}},"df":0,"docs":{}},"w":{"df":0,"docs":{},"l":{"df":0,"docs":{},"i":{"df":1,"docs":{"29":{"tf":1.0}}}}},"x":{"df":0,"docs":{},"t":{"df":8,"docs":{"15":{"tf":1.0},"2":{"tf":1.0},"21":{"tf":1.0},"22":{"tf":1.0},"25":{"tf":1.0},"29":{"tf":1.0},"3":{"tf":1.4142135623730951},"33":{"tf":1.0}}}}},"o":{"df":0,"docs":{},"i":{"df":0,"docs":{},"s":{"df":3,"docs":{"14":{"tf":1.0},"15":{"tf":1.0},"39":{"tf":1.4142135623730951}}}},"t":{"df":0,"docs":{},"e":{"b":{"df":0,"docs":{},"o":{"df":0,"docs":{},"o":{"df":0,"docs":{},"k":{"df":12,"docs":{"0":{"tf":1.0},"12":{"tf":1.0},"16":{"tf":1.0},"19":{"tf":1.0},"23":{"tf":1.0},"26":{"tf":1.0},"30":{"tf":1.0},"34":{"tf":1.0},"4":{"tf":1.0},"41":{"tf":1.0},"48":{"tf":1.0},"7":{"tf":1.0}}}}}},"df":3,"docs":{"2":{"tf":1.0},"21":{"tf":1.0},"51":{"tf":1.0}}}}}},"o":{"b":{"df":0,"docs":{},"j":{"df":0,"docs":{},"e":{"c":{"df":0,"docs":{},"t":{"df":12,"docs":{"1":{"tf":1.0},"13":{"tf":1.0},"17":{"tf":1.0},"20":{"tf":1.0},"24":{"tf":1.0},"27":{"tf":1.0},"31":{"tf":1.0},"35":{"tf":1.0},"42":{"tf":1.0},"49":{"tf":1.0},"5":{"tf":1.0},"8":{"tf":1.0}}}},"df":0,"docs":{}}},"s":{"df":0,"docs":{},"e":{"df":0,"docs":{},"r":{"df":0,"docs":{},"v":{"df":2,"docs":{"38":{"tf":1.0},"39":{"tf":1.0}}}}}}},"c":{"c":{"a":{"df":0,"docs":{},"s":{"df":0,"docs":{},"i":{"df":0,"docs":{},"o":{"df":0,"docs":{},"n":{"df":1,"docs":{"50":{"tf":1.0}}}}}}},"df":0,"docs":{}},"df":0,"docs":{}},"df":0,"docs":{},"m":{"df":0,"docs":{},"n":{"df":0,"docs":{},"i":{"df":0,"docs":{},"w":{"df":0,"docs":{},"h":{"df":0,"docs":{},"e":{"df":0,"docs":{},"e":{"df":0,"docs":{},"l":{"df":3,"docs":{"32":{"tf":1.0},"44":{"tf":1.0},"6":{"tf":1.0}}}}}}}}}},"p":{"df":0,"docs":{},"e":{"df":0,"docs":{},"r":{"df":4,"docs":{"21":{"tf":1.0},"32":{"tf":1.4142135623730951},"38":{"tf":1.0},"39":{"tf":1.0}}}},"t":{"df":0,"docs":{},"i":{"df":0,"docs":{},"m":{"df":2,"docs":{"21":{"tf":1.0},"40":{"tf":1.0}}},"o":{"df":0,"docs":{},"n":{"df":1,"docs":{"14":{"tf":1.0}}}}}}},"r":{"d":{"df":0,"docs":{},"e":{"df":0,"docs":{},"r":{"df":8,"docs":{"17":{"tf":1.0},"18":{"tf":1.0},"20":{"tf":1.0},"21":{"tf":1.0},"24":{"tf":1.0},"28":{"tf":1.0},"8":{"tf":1.0},"9":{"tf":1.0}}}}},"df":0,"docs":{},"g":{"a":{"df":0,"docs":{},"n":{"df":1,"docs":{"50":{"tf":1.0}}}},"df":0,"docs":{}}},"s":{"c":{"df":0,"docs":{},"i":{"df":0,"docs":{},"l":{"df":1,"docs":{"50":{"tf":1.0}}}}},"df":0,"docs":{}},"u":{"df":0,"docs":{},"t":{"1":{"df":1,"docs":{"32":{"tf":1.0}}},"2":{"df":1,"docs":{"32":{"tf":1.0}}},"3":{"df":1,"docs":{"32":{"tf":1.0}}},"df":2,"docs":{"11":{"tf":1.0},"2":{"tf":1.0}},"l":{"df":0,"docs":{},"i":{"df":0,"docs":{},"n":{"df":2,"docs":{"21":{"tf":1.0},"3":{"tf":1.0}}}}},"p":{"df":0,"docs":{},"u":{"df":0,"docs":{},"t":{"df":6,"docs":{"14":{"tf":1.0},"32":{"tf":1.4142135623730951},"37":{"tf":1.0},"45":{"tf":1.0},"46":{"tf":1.0},"50":{"tf":1.0}}}}}}},"v":{"df":0,"docs":{},"e":{"df":0,"docs":{},"r":{"a":{"df":0,"docs":{},"l":{"df":1,"docs":{"3":{"tf":1.0}}}},"df":4,"docs":{"1":{"tf":1.0},"2":{"tf":1.0},"46":{"tf":1.0},"50":{"tf":1.0}},"f":{"df":0,"docs":{},"l":{"df":0,"docs":{},"o":{"df":0,"docs":{},"w":{"df":1,"docs":{"50":{"tf":1.0}}}}}},"s":{"df":0,"docs":{},"h":{"df":0,"docs":{},"o":{"df":0,"docs":{},"o":{"df":0,"docs":{},"t":{"df":1,"docs":{"46":{"tf":1.0}}}}}}},"v":{"df":0,"docs":{},"i":{"df":0,"docs":{},"e":{"df":0,"docs":{},"w":{"df":1,"docs":{"3":{"tf":1.0}}}}}}}}}},"p":{"a":{"c":{"df":0,"docs":{},"k":{"df":0,"docs":{},"e":{"df":0,"docs":{},"t":{"df":1,"docs":{"51":{"tf":1.0}}}}}},"df":0,"docs":{},"g":{"df":0,"docs":{},"e":{"df":1,"docs":{"3":{"tf":1.0}}}},"r":{"a":{"df":0,"docs":{},"m":{"df":0,"docs":{},"e":{"df":0,"docs":{},"t":{"df":1,"docs":{"50":{"tf":1.0}}}}}},"df":0,"docs":{},"t":{"df":5,"docs":{"17":{"tf":1.0},"24":{"tf":1.0},"31":{"tf":1.0},"32":{"tf":1.0},"8":{"tf":1.0}},"i":{"c":{"df":0,"docs":{},"u":{"df":0,"docs":{},"l":{"a":{"df":0,"docs":{},"r":{"df":0,"docs":{},"l":{"df":0,"docs":{},"i":{"df":1,"docs":{"21":{"tf":1.0}}}}}},"df":0,"docs":{}}}},"df":0,"docs":{}},"n":{"df":0,"docs":{},"e":{"df":0,"docs":{},"r":{"df":3,"docs":{"2":{"tf":1.0},"32":{"tf":1.0},"6":{"tf":1.0}}}}}}},"u":{"df":0,"docs":{},"l":{"df":1,"docs":{"6":{"tf":1.0}}},"s":{"df":1,"docs":{"37":{"tf":1.0}}}},"y":{"df":0,"docs":{},"l":{"df":0,"docs":{},"o":{"a":{"d":{"df":1,"docs":{"50":{"tf":1.0}}},"df":0,"docs":{}},"df":0,"docs":{}}}}},"c":{"b":{"df":15,"docs":{"13":{"tf":1.4142135623730951},"14":{"tf":1.0},"15":{"tf":1.0},"17":{"tf":1.0},"18":{"tf":1.4142135623730951},"20":{"tf":1.0},"21":{"tf":2.449489742783178},"22":{"tf":1.0},"27":{"tf":1.4142135623730951},"28":{"tf":1.7320508075688772},"29":{"tf":1.0},"31":{"tf":1.0},"32":{"tf":1.0},"40":{"tf":1.0},"47":{"tf":1.4142135623730951}}},"df":0,"docs":{}},"df":0,"docs":{},"e":{"a":{"df":0,"docs":{},"k":{"df":1,"docs":{"14":{"tf":1.0}}}},"df":0,"docs":{},"e":{"df":0,"docs":{},"r":{"df":1,"docs":{"10":{"tf":1.0}}}},"r":{"df":0,"docs":{},"f":{"df":0,"docs":{},"o":{"df":0,"docs":{},"r":{"df":0,"docs":{},"m":{"df":3,"docs":{"13":{"tf":1.0},"3":{"tf":1.0},"50":{"tf":1.0}}}}}},"i":{"df":0,"docs":{},"o":{"d":{"df":1,"docs":{"37":{"tf":1.4142135623730951}}},"df":0,"docs":{}}}}},"i":{"d":{"_":{"c":{"df":0,"docs":{},"o":{"df":0,"docs":{},"n":{"df":0,"docs":{},"t":{"df":0,"docs":{},"r":{"df":0,"docs":{},"o":{"df":0,"docs":{},"l":{".":{"c":{"df":0,"docs":{},"p":{"df":0,"docs":{},"p":{"df":1,"docs":{"45":{"tf":1.0}}}}},"df":0,"docs":{}},"df":1,"docs":{"50":{"tf":1.0}}}}}}}}},"df":0,"docs":{}},"df":7,"docs":{"11":{"tf":1.0},"42":{"tf":1.0},"45":{"tf":2.0},"49":{"tf":1.0},"50":{"tf":1.7320508075688772},"51":{"tf":1.0},"52":{"tf":1.0}}},"df":7,"docs":{"20":{"tf":1.0},"21":{"tf":1.4142135623730951},"22":{"tf":1.0},"28":{"tf":1.4142135623730951},"29":{"tf":1.0},"31":{"tf":1.0},"32":{"tf":1.0}},"n":{"df":8,"docs":{"21":{"tf":1.4142135623730951},"28":{"tf":1.4142135623730951},"29":{"tf":1.4142135623730951},"32":{"tf":1.4142135623730951},"37":{"tf":1.4142135623730951},"38":{"tf":1.0},"47":{"tf":1.0},"51":{"tf":1.0}}}},"l":{"a":{"c":{"df":0,"docs":{},"e":{"df":0,"docs":{},"m":{"df":0,"docs":{},"e":{"df":0,"docs":{},"n":{"df":0,"docs":{},"t":{"df":5,"docs":{"14":{"tf":1.4142135623730951},"20":{"tf":1.0},"21":{"tf":1.0},"31":{"tf":1.0},"32":{"tf":1.4142135623730951}}}}}}}},"df":0,"docs":{},"n":{"df":2,"docs":{"21":{"tf":1.0},"39":{"tf":1.0}}}},"df":0,"docs":{},"o":{"df":0,"docs":{},"t":{"df":0,"docs":{},"t":{"df":0,"docs":{},"e":{"df":0,"docs":{},"r":{"df":1,"docs":{"14":{"tf":1.0}}}}}}}},"o":{"df":0,"docs":{},"i":{"df":0,"docs":{},"n":{"df":0,"docs":{},"t":{"df":1,"docs":{"28":{"tf":1.0}}}}},"s":{"df":0,"docs":{},"i":{"df":0,"docs":{},"t":{"df":2,"docs":{"21":{"tf":1.4142135623730951},"22":{"tf":1.0}}}},"t":{"df":1,"docs":{"50":{"tf":1.0}}}},"t":{"df":0,"docs":{},"e":{"df":0,"docs":{},"n":{"df":0,"docs":{},"t":{"df":0,"docs":{},"i":{"df":1,"docs":{"3":{"tf":1.0}},"o":{"df":0,"docs":{},"m":{"df":0,"docs":{},"e":{"df":0,"docs":{},"t":{"df":1,"docs":{"40":{"tf":1.0}}}}}}}}}}},"w":{"df":0,"docs":{},"e":{"df":0,"docs":{},"r":{"df":9,"docs":{"13":{"tf":1.4142135623730951},"14":{"tf":2.0},"15":{"tf":1.0},"21":{"tf":1.0},"22":{"tf":1.0},"28":{"tf":1.4142135623730951},"3":{"tf":1.0},"32":{"tf":1.7320508075688772},"33":{"tf":1.0}}}}}},"r":{"df":0,"docs":{},"e":{"c":{"df":0,"docs":{},"i":{"df":0,"docs":{},"s":{"df":2,"docs":{"28":{"tf":1.0},"40":{"tf":1.0}}}}},"df":0,"docs":{},"p":{"a":{"df":0,"docs":{},"r":{"df":3,"docs":{"20":{"tf":1.0},"21":{"tf":1.0},"3":{"tf":1.0}}}},"df":0,"docs":{}},"s":{"df":0,"docs":{},"e":{"df":0,"docs":{},"n":{"df":0,"docs":{},"t":{"df":2,"docs":{"2":{"tf":1.0},"3":{"tf":1.0}}}}}},"v":{"df":0,"docs":{},"e":{"df":0,"docs":{},"n":{"df":0,"docs":{},"t":{"df":1,"docs":{"46":{"tf":1.0}}}}},"i":{"df":0,"docs":{},"o":{"df":0,"docs":{},"u":{"df":1,"docs":{"14":{"tf":1.0}},"s":{"df":0,"docs":{},"e":{"df":0,"docs":{},"r":{"df":0,"docs":{},"r":{"df":0,"docs":{},"o":{"df":0,"docs":{},"r":{"df":1,"docs":{"45":{"tf":1.4142135623730951}}}}}}}}}}}}},"o":{"b":{"df":0,"docs":{},"l":{"df":0,"docs":{},"e":{"df":0,"docs":{},"m":{"df":1,"docs":{"3":{"tf":1.0}}}}}},"df":0,"docs":{},"f":{"df":0,"docs":{},"e":{"df":0,"docs":{},"s":{"df":0,"docs":{},"s":{"df":0,"docs":{},"i":{"df":0,"docs":{},"o":{"df":0,"docs":{},"n":{"df":1,"docs":{"3":{"tf":1.0}}}}}}}}},"g":{"df":0,"docs":{},"r":{"a":{"df":0,"docs":{},"m":{"df":1,"docs":{"21":{"tf":1.0}}}},"df":0,"docs":{},"e":{"df":0,"docs":{},"s":{"df":0,"docs":{},"s":{"df":12,"docs":{"14":{"tf":1.0},"18":{"tf":1.0},"2":{"tf":1.0},"21":{"tf":1.0},"25":{"tf":1.0},"28":{"tf":1.0},"32":{"tf":1.0},"36":{"tf":1.0},"43":{"tf":1.0},"50":{"tf":1.0},"6":{"tf":1.0},"9":{"tf":1.0}}}}}}},"j":{"df":0,"docs":{},"e":{"c":{"df":0,"docs":{},"t":{"df":4,"docs":{"1":{"tf":1.0},"2":{"tf":1.0},"5":{"tf":1.0},"50":{"tf":1.0}}}},"df":0,"docs":{}}},"o":{"df":0,"docs":{},"f":{"df":1,"docs":{"3":{"tf":1.0}}}},"p":{"df":0,"docs":{},"e":{"df":0,"docs":{},"r":{"df":4,"docs":{"32":{"tf":1.0},"38":{"tf":1.0},"50":{"tf":1.0},"51":{"tf":1.0}},"l":{"df":0,"docs":{},"i":{"df":3,"docs":{"10":{"tf":1.0},"13":{"tf":1.0},"3":{"tf":1.0}}}}}},"o":{"df":0,"docs":{},"r":{"df":0,"docs":{},"t":{"df":4,"docs":{"44":{"tf":1.0},"45":{"tf":1.0},"46":{"tf":1.4142135623730951},"50":{"tf":1.0}}}},"s":{"df":2,"docs":{"1":{"tf":1.0},"3":{"tf":1.0}}}}},"v":{"df":0,"docs":{},"i":{"d":{"df":2,"docs":{"3":{"tf":1.0},"46":{"tf":1.0}}},"df":0,"docs":{}}}}},"s":{"df":0,"docs":{},"e":{"df":0,"docs":{},"u":{"d":{"df":0,"docs":{},"o":{"c":{"df":0,"docs":{},"o":{"d":{"df":1,"docs":{"45":{"tf":1.0}}},"df":0,"docs":{}}},"df":0,"docs":{}}},"df":0,"docs":{}}}},"u":{"df":0,"docs":{},"l":{"df":0,"docs":{},"s":{"df":2,"docs":{"37":{"tf":2.8284271247461903},"38":{"tf":1.0}},"e":{"df":0,"docs":{},"w":{"df":0,"docs":{},"i":{"d":{"df":0,"docs":{},"t":{"df":0,"docs":{},"h":{"df":1,"docs":{"37":{"tf":1.0}}}}},"df":0,"docs":{}}}}}},"r":{"df":0,"docs":{},"p":{"df":0,"docs":{},"o":{"df":0,"docs":{},"s":{"df":1,"docs":{"28":{"tf":1.0}}}}}}},"w":{"df":0,"docs":{},"m":{"_":{"c":{"df":0,"docs":{},"h":{"a":{"df":0,"docs":{},"n":{"df":0,"docs":{},"n":{"df":0,"docs":{},"e":{"df":0,"docs":{},"l":{"df":1,"docs":{"37":{"tf":1.4142135623730951}}}}}}},"df":0,"docs":{}}},"df":0,"docs":{},"f":{"df":0,"docs":{},"r":{"df":0,"docs":{},"e":{"df":0,"docs":{},"q":{"df":1,"docs":{"37":{"tf":1.0}}}}}},"m":{"df":0,"docs":{},"o":{"d":{"df":0,"docs":{},"e":{"df":1,"docs":{"37":{"tf":1.0}}}},"df":0,"docs":{}}},"r":{"df":0,"docs":{},"e":{"df":0,"docs":{},"s":{"df":0,"docs":{},"o":{"df":0,"docs":{},"l":{"df":0,"docs":{},"u":{"df":0,"docs":{},"t":{"df":1,"docs":{"37":{"tf":1.0}}}}}}}}},"t":{"df":0,"docs":{},"i":{"df":0,"docs":{},"m":{"df":0,"docs":{},"e":{"df":0,"docs":{},"r":{"df":1,"docs":{"37":{"tf":1.0}}}}}}}},"df":8,"docs":{"32":{"tf":1.0},"33":{"tf":1.0},"35":{"tf":1.0},"36":{"tf":1.0},"37":{"tf":1.7320508075688772},"39":{"tf":1.0},"45":{"tf":1.0},"50":{"tf":1.0}}}}},"q":{"df":0,"docs":{},"u":{"df":0,"docs":{},"i":{"df":0,"docs":{},"t":{"df":1,"docs":{"47":{"tf":1.0}}}}}},"r":{"1":{"df":1,"docs":{"14":{"tf":1.0}},"":{"=":{"1":{"0":{"0":{"df":0,"docs":{},"k":{"df":1,"docs":{"14":{"tf":1.0}}}},"df":0,"docs":{}},"df":0,"docs":{}},"df":0,"docs":{}},"df":0,"docs":{}}},"2":{"df":1,"docs":{"14":{"tf":1.0}},"":{"=":{"4":{"5":{"0":{"df":0,"docs":{},"k":{"df":1,"docs":{"14":{"tf":1.0}}}},"df":0,"docs":{}},"df":0,"docs":{}},"df":0,"docs":{}},"df":0,"docs":{}}},"a":{"d":{"df":0,"docs":{},"i":{"df":0,"docs":{},"u":{"df":2,"docs":{"44":{"tf":1.0},"50":{"tf":1.0}}}}},"df":0,"docs":{},"n":{"df":0,"docs":{},"g":{"df":2,"docs":{"37":{"tf":1.4142135623730951},"39":{"tf":1.0}}}},"s":{"df":0,"docs":{},"p":{"b":{"df":0,"docs":{},"e":{"df":0,"docs":{},"r":{"df":0,"docs":{},"r":{"df":0,"docs":{},"i":{"df":7,"docs":{"20":{"tf":1.0},"21":{"tf":1.4142135623730951},"22":{"tf":1.0},"28":{"tf":1.4142135623730951},"29":{"tf":1.0},"31":{"tf":1.0},"32":{"tf":1.0}}}}}}},"df":0,"docs":{}}}},"df":2,"docs":{"32":{"tf":1.0},"44":{"tf":1.0}},"e":{"c":{"df":0,"docs":{},"e":{"df":0,"docs":{},"i":{"df":0,"docs":{},"v":{"df":3,"docs":{"2":{"tf":1.0},"25":{"tf":1.0},"28":{"tf":1.0}}}}}},"d":{"df":0,"docs":{},"u":{"c":{"df":1,"docs":{"14":{"tf":1.0}},"t":{"df":1,"docs":{"39":{"tf":1.0}}}},"df":0,"docs":{},"n":{"df":0,"docs":{},"t":{"df":1,"docs":{"47":{"tf":1.0}}}}}},"df":0,"docs":{},"f":{"df":0,"docs":{},"e":{"df":0,"docs":{},"r":{"df":1,"docs":{"3":{"tf":1.4142135623730951}},"e":{"df":0,"docs":{},"n":{"c":{"df":1,"docs":{"32":{"tf":1.0}}},"df":0,"docs":{}}}}},"i":{"df":0,"docs":{},"n":{"df":4,"docs":{"20":{"tf":1.0},"22":{"tf":1.0},"31":{"tf":1.0},"50":{"tf":1.0}}}}},"g":{"df":0,"docs":{},"i":{"df":0,"docs":{},"s":{"df":0,"docs":{},"t":{"df":1,"docs":{"50":{"tf":1.0}}}}},"u":{"df":0,"docs":{},"l":{"df":2,"docs":{"14":{"tf":1.4142135623730951},"32":{"tf":1.0}}}}},"l":{"a":{"df":0,"docs":{},"t":{"df":0,"docs":{},"i":{"df":0,"docs":{},"o":{"df":0,"docs":{},"n":{"df":0,"docs":{},"s":{"df":0,"docs":{},"h":{"df":0,"docs":{},"i":{"df":0,"docs":{},"p":{"df":1,"docs":{"44":{"tf":1.0}}}}}}}}}}},"df":1,"docs":{"44":{"tf":1.0}},"i":{"a":{"b":{"df":0,"docs":{},"l":{"df":3,"docs":{"15":{"tf":1.0},"21":{"tf":1.0},"50":{"tf":1.0}}}},"df":0,"docs":{}},"df":0,"docs":{}}},"m":{"df":0,"docs":{},"n":{"df":0,"docs":{},"i":{"df":0,"docs":{},"s":{"c":{"df":0,"docs":{},"i":{"df":1,"docs":{"6":{"tf":1.0}}}},"df":0,"docs":{}}}}},"p":{"df":0,"docs":{},"o":{"df":1,"docs":{"49":{"tf":1.0}},"s":{"df":0,"docs":{},"i":{"df":0,"docs":{},"t":{"df":0,"docs":{},"o":{"df":0,"docs":{},"r":{"df":0,"docs":{},"i":{"df":1,"docs":{"50":{"tf":1.4142135623730951}}}}}}}}}},"q":{"df":0,"docs":{},"u":{"df":0,"docs":{},"e":{"df":0,"docs":{},"s":{"df":0,"docs":{},"t":{"df":1,"docs":{"50":{"tf":1.0}}}}},"i":{"df":0,"docs":{},"r":{"df":10,"docs":{"14":{"tf":1.4142135623730951},"2":{"tf":1.0},"21":{"tf":1.0},"28":{"tf":1.0},"3":{"tf":1.4142135623730951},"31":{"tf":1.0},"38":{"tf":1.4142135623730951},"46":{"tf":1.0},"5":{"tf":1.0},"8":{"tf":1.0}},"e":{"df":0,"docs":{},"m":{"df":0,"docs":{},"e":{"df":0,"docs":{},"n":{"df":0,"docs":{},"t":{"df":0,"docs":{},"s":{"/":{"df":0,"docs":{},"v":{"a":{"df":0,"docs":{},"l":{"df":0,"docs":{},"u":{"df":1,"docs":{"10":{"tf":1.0}}}}},"df":0,"docs":{}}},"df":0,"docs":{}}}}}}}}}}},"s":{"df":0,"docs":{},"i":{"df":0,"docs":{},"s":{"df":0,"docs":{},"t":{"df":0,"docs":{},"o":{"df":0,"docs":{},"r":{"df":5,"docs":{"14":{"tf":1.0},"20":{"tf":1.0},"21":{"tf":1.4142135623730951},"31":{"tf":1.0},"32":{"tf":1.0}}}}}}},"o":{"df":0,"docs":{},"l":{"df":0,"docs":{},"u":{"df":0,"docs":{},"t":{"df":2,"docs":{"36":{"tf":1.0},"37":{"tf":1.4142135623730951}}}},"v":{"df":4,"docs":{"21":{"tf":1.0},"39":{"tf":1.0},"50":{"tf":2.0},"51":{"tf":1.0}}}}},"p":{"df":0,"docs":{},"e":{"c":{"df":0,"docs":{},"t":{"df":1,"docs":{"45":{"tf":1.0}}}},"df":0,"docs":{}},"o":{"df":0,"docs":{},"n":{"df":0,"docs":{},"s":{"df":3,"docs":{"46":{"tf":1.7320508075688772},"50":{"tf":1.0},"51":{"tf":1.0}}}}}},"t":{"df":0,"docs":{},"r":{"df":0,"docs":{},"i":{"c":{"df":0,"docs":{},"t":{"df":1,"docs":{"39":{"tf":1.0}}}},"df":0,"docs":{}}}},"u":{"df":0,"docs":{},"l":{"df":0,"docs":{},"t":{"df":2,"docs":{"14":{"tf":1.0},"21":{"tf":1.0}}}}}},"t":{"df":0,"docs":{},"u":{"df":0,"docs":{},"r":{"df":0,"docs":{},"n":{"df":1,"docs":{"45":{"tf":1.0}}}}}},"v":{"df":0,"docs":{},"i":{"df":0,"docs":{},"e":{"df":0,"docs":{},"w":{"1":{"df":1,"docs":{"1":{"tf":1.0}}},"df":9,"docs":{"10":{"tf":1.4142135623730951},"13":{"tf":1.0},"14":{"tf":1.0},"15":{"tf":1.0},"2":{"tf":1.0},"21":{"tf":1.0},"3":{"tf":1.0},"31":{"tf":1.0},"32":{"tf":1.0}}}}}}},"o":{"b":{"df":0,"docs":{},"o":{"df":0,"docs":{},"t":{"'":{"df":3,"docs":{"3":{"tf":1.0},"44":{"tf":1.4142135623730951},"46":{"tf":1.0}}},"df":6,"docs":{"31":{"tf":1.0},"32":{"tf":1.0},"33":{"tf":1.0},"44":{"tf":1.4142135623730951},"49":{"tf":1.0},"50":{"tf":1.0}}}}},"df":0,"docs":{},"l":{"df":0,"docs":{},"e":{"df":1,"docs":{"3":{"tf":1.0}}}},"t":{"a":{"df":0,"docs":{},"t":{"df":1,"docs":{"44":{"tf":1.0}},"e":{"df":0,"docs":{},"r":{"df":0,"docs":{},"o":{"b":{"df":0,"docs":{},"o":{"df":0,"docs":{},"t":{"df":1,"docs":{"50":{"tf":1.4142135623730951}}}}},"df":0,"docs":{}}}}}},"df":0,"docs":{}},"u":{"df":0,"docs":{},"n":{"d":{"df":1,"docs":{"18":{"tf":1.0}}},"df":0,"docs":{}},"t":{"df":1,"docs":{"14":{"tf":1.0}}}}},"p":{"df":0,"docs":{},"m":{"df":1,"docs":{"44":{"tf":1.0}}}},"u":{"df":0,"docs":{},"l":{"df":0,"docs":{},"e":{"df":1,"docs":{"50":{"tf":1.0}}}}}},"s":{")":{"df":0,"docs":{},"p":{"df":0,"docs":{},"u":{"df":0,"docs":{},"l":{"df":0,"docs":{},"s":{"df":1,"docs":{"37":{"tf":1.0}}}}}},"⋅":{"df":0,"docs":{},"m":{"a":{"df":0,"docs":{},"x":{"df":1,"docs":{"37":{"tf":1.0}}}},"df":0,"docs":{}}}},"a":{"df":0,"docs":{},"f":{"df":0,"docs":{},"e":{"df":0,"docs":{},"t":{"df":0,"docs":{},"i":{"df":1,"docs":{"3":{"tf":1.4142135623730951}}}}}},"t":{"df":0,"docs":{},"i":{"df":0,"docs":{},"s":{"df":0,"docs":{},"f":{"a":{"c":{"df":0,"docs":{},"t":{"df":0,"docs":{},"o":{"df":0,"docs":{},"r":{"df":0,"docs":{},"i":{"df":1,"docs":{"21":{"tf":1.0}}}}}}},"df":0,"docs":{}},"df":0,"docs":{}}}}}},"c":{"df":0,"docs":{},"e":{"df":0,"docs":{},"n":{"a":{"df":0,"docs":{},"r":{"df":0,"docs":{},"i":{"df":0,"docs":{},"o":{"df":1,"docs":{"50":{"tf":1.0}}}}}},"df":0,"docs":{}}},"h":{"df":0,"docs":{},"e":{"d":{"df":0,"docs":{},"u":{"df":0,"docs":{},"l":{"df":1,"docs":{"11":{"tf":1.4142135623730951}}}}},"df":0,"docs":{},"m":{"a":{"df":0,"docs":{},"t":{"df":2,"docs":{"10":{"tf":1.0},"40":{"tf":1.0}}}},"df":0,"docs":{}}}},"o":{"df":0,"docs":{},"p":{"df":0,"docs":{},"e":{"df":1,"docs":{"2":{"tf":1.0}}}}},"r":{"df":0,"docs":{},"e":{"df":0,"docs":{},"w":{"df":1,"docs":{"32":{"tf":1.0}}}}}},"df":0,"docs":{},"e":{"c":{"df":0,"docs":{},"o":{"df":0,"docs":{},"n":{"d":{"df":1,"docs":{"37":{"tf":1.0}}},"df":0,"docs":{}}},"t":{"df":0,"docs":{},"i":{"df":0,"docs":{},"o":{"df":0,"docs":{},"n":{"df":1,"docs":{"3":{"tf":1.0}}}}}},"u":{"df":0,"docs":{},"r":{"df":1,"docs":{"32":{"tf":1.0}}}}},"df":0,"docs":{},"e":{"df":0,"docs":{},"m":{"df":1,"docs":{"21":{"tf":1.0}}}},"l":{"df":0,"docs":{},"e":{"c":{"df":0,"docs":{},"t":{"df":2,"docs":{"14":{"tf":1.0},"21":{"tf":1.4142135623730951}}}},"df":0,"docs":{}}},"n":{"d":{"df":0,"docs":{},"i":{"df":0,"docs":{},"p":{"df":0,"docs":{},"t":{"df":0,"docs":{},"o":{"df":0,"docs":{},"f":{"df":0,"docs":{},"l":{"a":{"df":0,"docs":{},"s":{"df":0,"docs":{},"k":{"df":0,"docs":{},"s":{"df":0,"docs":{},"e":{"df":0,"docs":{},"r":{"df":0,"docs":{},"v":{"df":1,"docs":{"50":{"tf":1.0}}}}}}}}},"df":0,"docs":{}}}}}}}},"df":0,"docs":{},"s":{"df":0,"docs":{},"o":{"df":0,"docs":{},"r":{"df":2,"docs":{"21":{"tf":1.0},"9":{"tf":1.0}}}}}},"r":{"df":0,"docs":{},"v":{"df":0,"docs":{},"o":{"_":{"df":0,"docs":{},"h":{"df":0,"docs":{},"i":{"df":0,"docs":{},"g":{"df":0,"docs":{},"h":{"_":{"1":{"df":1,"docs":{"37":{"tf":1.0}}},"2":{"df":1,"docs":{"37":{"tf":1.0}}},"df":0,"docs":{}},"df":1,"docs":{"38":{"tf":1.0}}}}}},"m":{"a":{"df":0,"docs":{},"x":{"_":{"df":0,"docs":{},"p":{"df":0,"docs":{},"u":{"df":0,"docs":{},"l":{"df":0,"docs":{},"s":{"df":0,"docs":{},"e":{"df":0,"docs":{},"w":{"df":0,"docs":{},"i":{"d":{"df":0,"docs":{},"t":{"df":0,"docs":{},"h":{"df":1,"docs":{"37":{"tf":1.0}}}}},"df":0,"docs":{}}}}}}}}},"df":0,"docs":{}}},"df":0,"docs":{},"i":{"df":0,"docs":{},"n":{"_":{"df":0,"docs":{},"p":{"df":0,"docs":{},"u":{"df":0,"docs":{},"l":{"df":0,"docs":{},"s":{"df":0,"docs":{},"e":{"df":0,"docs":{},"w":{"df":0,"docs":{},"i":{"d":{"df":0,"docs":{},"t":{"df":0,"docs":{},"h":{"df":1,"docs":{"37":{"tf":1.4142135623730951}}}}},"df":0,"docs":{}}}}}}}}},"df":0,"docs":{}}}},"p":{"df":0,"docs":{},"i":{"df":0,"docs":{},"n":{"df":1,"docs":{"37":{"tf":1.0}}}}}},"df":10,"docs":{"14":{"tf":1.0},"21":{"tf":1.4142135623730951},"31":{"tf":1.0},"32":{"tf":1.4142135623730951},"35":{"tf":1.4142135623730951},"36":{"tf":1.4142135623730951},"37":{"tf":2.23606797749979},"38":{"tf":1.4142135623730951},"39":{"tf":1.0},"47":{"tf":1.4142135623730951}},"’":{"df":2,"docs":{"37":{"tf":1.0},"39":{"tf":1.0}}}}}},"s":{"df":0,"docs":{},"s":{"df":0,"docs":{},"i":{"df":0,"docs":{},"o":{"df":0,"docs":{},"n":{"df":2,"docs":{"3":{"tf":1.0},"50":{"tf":1.0}}}}}}},"t":{"df":3,"docs":{"35":{"tf":1.0},"37":{"tf":1.4142135623730951},"39":{"tf":1.0}},"p":{"df":0,"docs":{},"o":{"df":0,"docs":{},"i":{"df":0,"docs":{},"n":{"df":0,"docs":{},"t":{"df":0,"docs":{},"r":{"df":0,"docs":{},"p":{"df":0,"docs":{},"m":{"df":1,"docs":{"45":{"tf":1.4142135623730951}}}}}}}}}},"s":{"df":0,"docs":{},"e":{"df":0,"docs":{},"r":{"df":0,"docs":{},"v":{"df":0,"docs":{},"o":{"a":{"df":0,"docs":{},"n":{"df":0,"docs":{},"g":{"df":0,"docs":{},"l":{"df":1,"docs":{"37":{"tf":1.0}},"e":{"(":{"df":0,"docs":{},"u":{"df":0,"docs":{},"i":{"df":0,"docs":{},"n":{"df":0,"docs":{},"t":{"8":{"_":{"df":0,"docs":{},"t":{"df":1,"docs":{"37":{"tf":1.0}}}},"df":0,"docs":{}},"df":0,"docs":{}}}}}},"df":0,"docs":{}}}}}},"df":0,"docs":{}}}}}},"u":{"df":0,"docs":{},"p":{"df":1,"docs":{"21":{"tf":1.0}}}}}},"h":{"a":{"df":0,"docs":{},"p":{"df":0,"docs":{},"e":{"df":2,"docs":{"21":{"tf":1.0},"50":{"tf":1.0}}}}},"df":0,"docs":{},"o":{"df":0,"docs":{},"p":{"df":1,"docs":{"5":{"tf":1.0}}},"r":{"df":0,"docs":{},"t":{"df":0,"docs":{},"e":{"df":0,"docs":{},"r":{"df":1,"docs":{"6":{"tf":1.0}}}}}},"w":{"df":1,"docs":{"52":{"tf":1.0}}}}},"i":{"df":0,"docs":{},"g":{"df":0,"docs":{},"n":{"a":{"df":0,"docs":{},"l":{"df":10,"docs":{"14":{"tf":1.0},"3":{"tf":1.0},"32":{"tf":1.0},"35":{"tf":1.0},"36":{"tf":1.0},"37":{"tf":1.4142135623730951},"39":{"tf":1.0},"40":{"tf":1.0},"45":{"tf":1.0},"50":{"tf":1.0}}}},"df":1,"docs":{"10":{"tf":1.0}}}},"m":{"df":0,"docs":{},"p":{"df":0,"docs":{},"l":{"df":0,"docs":{},"i":{"df":0,"docs":{},"f":{"df":0,"docs":{},"i":{"df":1,"docs":{"21":{"tf":1.0}}}}}}},"u":{"df":0,"docs":{},"l":{"df":3,"docs":{"15":{"tf":1.0},"22":{"tf":1.0},"33":{"tf":1.0}}}}},"n":{"df":0,"docs":{},"g":{"df":0,"docs":{},"l":{"df":1,"docs":{"50":{"tf":1.0}}}}}},"k":{"df":0,"docs":{},"i":{"df":0,"docs":{},"p":{"df":1,"docs":{"50":{"tf":1.0}}}}},"l":{"df":0,"docs":{},"i":{"c":{"df":0,"docs":{},"k":{"df":1,"docs":{"6":{"tf":1.0}}}},"d":{"df":0,"docs":{},"e":{"df":0,"docs":{},"s":{"df":0,"docs":{},"h":{"df":0,"docs":{},"o":{"df":0,"docs":{},"w":{"df":1,"docs":{"10":{"tf":1.0}}}}}}}},"df":0,"docs":{},"g":{"df":0,"docs":{},"h":{"df":0,"docs":{},"t":{"df":1,"docs":{"39":{"tf":1.0}}}}}},"u":{"df":0,"docs":{},"g":{"df":0,"docs":{},"g":{"df":0,"docs":{},"i":{"df":0,"docs":{},"s":{"df":0,"docs":{},"h":{"df":1,"docs":{"50":{"tf":1.0}}}}}}}}},"m":{"df":0,"docs":{},"o":{"df":0,"docs":{},"o":{"df":0,"docs":{},"t":{"df":0,"docs":{},"h":{"df":4,"docs":{"32":{"tf":1.0},"38":{"tf":1.0},"39":{"tf":1.0},"46":{"tf":1.0}}}}}}},"o":{"df":0,"docs":{},"f":{"df":0,"docs":{},"t":{"df":0,"docs":{},"w":{"a":{"df":0,"docs":{},"r":{"df":4,"docs":{"11":{"tf":1.0},"21":{"tf":1.0},"3":{"tf":1.0},"51":{"tf":1.0}}}},"df":0,"docs":{}}}},"l":{"df":0,"docs":{},"u":{"df":0,"docs":{},"t":{"df":1,"docs":{"3":{"tf":1.0}}}}},"u":{"df":0,"docs":{},"r":{"c":{"df":1,"docs":{"3":{"tf":1.0}}},"df":0,"docs":{}}}},"p":{"df":1,"docs":{"3":{"tf":1.0}},"e":{"c":{"df":0,"docs":{},"i":{"df":0,"docs":{},"f":{"df":3,"docs":{"2":{"tf":1.0},"39":{"tf":1.0},"51":{"tf":1.0}},"i":{"df":3,"docs":{"10":{"tf":1.4142135623730951},"37":{"tf":1.0},"38":{"tf":1.0}}}}}},"df":0,"docs":{},"e":{"d":{"_":{"df":0,"docs":{},"m":{"df":0,"docs":{},"o":{"d":{"df":1,"docs":{"37":{"tf":1.0}}},"df":0,"docs":{}}}},"df":3,"docs":{"44":{"tf":2.23606797749979},"45":{"tf":1.0},"51":{"tf":1.0}}},"df":0,"docs":{}}}},"q":{"df":0,"docs":{},"u":{"a":{"df":0,"docs":{},"r":{"df":1,"docs":{"50":{"tf":1.0}}}},"df":0,"docs":{}}},"r":{"c":{"df":1,"docs":{"50":{"tf":1.0}}},"df":0,"docs":{}},"t":{"a":{"b":{"df":0,"docs":{},"i":{"df":0,"docs":{},"l":{"df":6,"docs":{"15":{"tf":1.0},"21":{"tf":1.0},"22":{"tf":1.0},"33":{"tf":1.0},"37":{"tf":1.0},"40":{"tf":1.0}}}}},"df":0,"docs":{},"n":{"d":{"a":{"df":0,"docs":{},"r":{"d":{"df":1,"docs":{"38":{"tf":1.0}}},"df":0,"docs":{}}},"df":0,"docs":{}},"df":0,"docs":{}},"r":{"df":0,"docs":{},"t":{"df":3,"docs":{"2":{"tf":1.0},"21":{"tf":1.0},"8":{"tf":1.0}}}}},"d":{"b":{"df":0,"docs":{},"i":{"df":1,"docs":{"51":{"tf":1.0}}}},"df":0,"docs":{}},"df":0,"docs":{},"e":{"df":0,"docs":{},"p":{"df":8,"docs":{"15":{"tf":1.0},"21":{"tf":1.0},"22":{"tf":1.0},"25":{"tf":1.0},"29":{"tf":1.0},"3":{"tf":1.0},"33":{"tf":1.0},"40":{"tf":1.0}}}},"r":{"a":{"df":0,"docs":{},"t":{"df":0,"docs":{},"e":{"df":0,"docs":{},"g":{"df":0,"docs":{},"i":{"df":1,"docs":{"3":{"tf":1.0}}}}}}},"df":0,"docs":{},"e":{"a":{"df":0,"docs":{},"m":{"df":0,"docs":{},"l":{"df":0,"docs":{},"i":{"df":0,"docs":{},"n":{"df":1,"docs":{"51":{"tf":1.0}}}}}}},"df":0,"docs":{}},"o":{"df":0,"docs":{},"n":{"df":0,"docs":{},"g":{"df":1,"docs":{"3":{"tf":1.0}}}}}}},"u":{"b":{"df":0,"docs":{},"s":{"df":0,"docs":{},"y":{"df":0,"docs":{},"s":{"df":0,"docs":{},"t":{"df":0,"docs":{},"e":{"df":0,"docs":{},"m":{"df":7,"docs":{"13":{"tf":1.0},"14":{"tf":2.449489742783178},"2":{"tf":1.0},"22":{"tf":1.0},"3":{"tf":1.4142135623730951},"33":{"tf":1.0},"8":{"tf":1.0}}}}}}}}},"c":{"c":{"df":0,"docs":{},"e":{"df":0,"docs":{},"s":{"df":0,"docs":{},"s":{"df":0,"docs":{},"f":{"df":0,"docs":{},"u":{"df":0,"docs":{},"l":{"df":0,"docs":{},"l":{"df":0,"docs":{},"i":{"df":1,"docs":{"38":{"tf":1.0}}}}}}}}}}},"df":0,"docs":{},"h":{"df":2,"docs":{"21":{"tf":1.0},"50":{"tf":1.0}}}},"df":0,"docs":{},"f":{"df":0,"docs":{},"f":{"df":0,"docs":{},"i":{"c":{"df":0,"docs":{},"i":{"df":3,"docs":{"10":{"tf":1.0},"14":{"tf":1.0},"3":{"tf":1.0}}}},"df":0,"docs":{}}}},"p":{"df":0,"docs":{},"p":{"df":0,"docs":{},"l":{"df":0,"docs":{},"i":{"df":2,"docs":{"14":{"tf":1.0},"28":{"tf":1.0}}}},"o":{"df":0,"docs":{},"r":{"df":0,"docs":{},"t":{"df":1,"docs":{"28":{"tf":1.7320508075688772}}}}}}}},"y":{"df":0,"docs":{},"s":{"df":0,"docs":{},"t":{"df":0,"docs":{},"e":{"df":0,"docs":{},"m":{"df":6,"docs":{"15":{"tf":1.0},"28":{"tf":1.0},"3":{"tf":1.0},"31":{"tf":1.0},"50":{"tf":1.0},"9":{"tf":1.0}}}}}}}},"t":{"a":{"df":6,"docs":{"1":{"tf":1.0},"10":{"tf":1.0},"14":{"tf":1.0},"18":{"tf":1.0},"21":{"tf":1.0},"3":{"tf":2.0}},"l":{"df":0,"docs":{},"k":{"df":1,"docs":{"2":{"tf":1.0}}}},"r":{"df":0,"docs":{},"g":{"df":0,"docs":{},"e":{"df":0,"docs":{},"t":{"df":1,"docs":{"18":{"tf":1.0}}}}}}},"df":0,"docs":{},"e":{"a":{"df":0,"docs":{},"m":{"df":1,"docs":{"3":{"tf":1.4142135623730951}}}},"df":0,"docs":{},"m":{"df":0,"docs":{},"p":{"df":0,"docs":{},"l":{"a":{"df":0,"docs":{},"t":{"df":1,"docs":{"2":{"tf":1.0}}}},"df":0,"docs":{}}}},"r":{"df":0,"docs":{},"m":{"df":1,"docs":{"46":{"tf":1.7320508075688772}}}},"s":{"df":0,"docs":{},"t":{"df":17,"docs":{"20":{"tf":1.0},"21":{"tf":2.23606797749979},"22":{"tf":1.0},"24":{"tf":1.0},"28":{"tf":1.0},"29":{"tf":1.0},"3":{"tf":1.0},"33":{"tf":1.4142135623730951},"35":{"tf":1.0},"36":{"tf":1.0},"37":{"tf":1.4142135623730951},"39":{"tf":1.0},"40":{"tf":1.0},"46":{"tf":1.0},"49":{"tf":1.0},"50":{"tf":2.8284271247461903},"9":{"tf":1.0}},"i":{"df":0,"docs":{},"n":{"df":0,"docs":{},"g":{"/":{"d":{"df":0,"docs":{},"e":{"b":{"df":0,"docs":{},"u":{"df":0,"docs":{},"g":{"df":1,"docs":{"11":{"tf":1.0}}}}},"df":0,"docs":{}}},"df":0,"docs":{}},"df":0,"docs":{}}}}}},"x":{"df":0,"docs":{},"t":{"df":7,"docs":{"10":{"tf":1.0},"2":{"tf":1.0},"25":{"tf":1.0},"28":{"tf":1.0},"32":{"tf":1.4142135623730951},"6":{"tf":1.7320508075688772},"9":{"tf":1.0}}}}},"h":{"a":{"df":0,"docs":{},"n":{"df":0,"docs":{},"k":{"df":1,"docs":{"6":{"tf":1.0}}}}},"df":1,"docs":{"44":{"tf":1.0}},"r":{"df":0,"docs":{},"o":{"df":0,"docs":{},"u":{"df":0,"docs":{},"g":{"df":0,"docs":{},"h":{"df":2,"docs":{"36":{"tf":1.0},"50":{"tf":1.0}}}}}}}},"i":{"df":0,"docs":{},"m":{"df":0,"docs":{},"e":{"df":3,"docs":{"18":{"tf":1.0},"46":{"tf":1.0},"50":{"tf":1.0}},"o":{"df":0,"docs":{},"u":{"df":0,"docs":{},"t":{"df":1,"docs":{"50":{"tf":1.0}}}}},"r":{"_":{"df":0,"docs":{},"e":{"df":0,"docs":{},"r":{"df":0,"docs":{},"r":{"df":1,"docs":{"37":{"tf":1.0}}}}},"n":{"df":0,"docs":{},"u":{"df":0,"docs":{},"m":{"df":1,"docs":{"37":{"tf":1.0}}}}}},"df":3,"docs":{"37":{"tf":1.4142135623730951},"38":{"tf":1.0},"39":{"tf":1.4142135623730951}}}}}},"o":{"d":{"df":0,"docs":{},"o":{"df":1,"docs":{"10":{"tf":1.0}}}},"df":0,"docs":{},"l":{"df":0,"docs":{},"e":{"df":0,"docs":{},"r":{"df":2,"docs":{"2":{"tf":1.0},"3":{"tf":1.4142135623730951}}}}},"m":{"df":0,"docs":{},"o":{"df":0,"docs":{},"r":{"df":0,"docs":{},"r":{"df":0,"docs":{},"o":{"df":0,"docs":{},"w":{"df":1,"docs":{"10":{"tf":1.0}}}}}}}},"o":{"df":0,"docs":{},"l":{"df":2,"docs":{"21":{"tf":1.0},"3":{"tf":1.0}}}},"p":{"df":1,"docs":{"32":{"tf":1.4142135623730951}}},"r":{"df":0,"docs":{},"q":{"df":0,"docs":{},"u":{"df":1,"docs":{"3":{"tf":1.4142135623730951}}}}}},"p":{"df":0,"docs":{},"s":{"6":{"2":{"1":{"4":{"0":{"d":{"c":{"df":0,"docs":{},"l":{"df":0,"docs":{},"r":{"'":{"df":1,"docs":{"14":{"tf":1.0}}},"df":1,"docs":{"14":{"tf":1.0}}}}},"df":0,"docs":{}},"df":0,"docs":{}},"df":0,"docs":{}},"df":0,"docs":{}},"df":0,"docs":{}},"df":0,"docs":{}},"df":0,"docs":{}}},"r":{"a":{"c":{"df":0,"docs":{},"e":{"df":1,"docs":{"51":{"tf":1.0}}}},"df":0,"docs":{}},"df":0,"docs":{},"i":{"a":{"df":0,"docs":{},"n":{"df":0,"docs":{},"g":{"df":0,"docs":{},"l":{"df":1,"docs":{"50":{"tf":1.0}}}}}},"df":0,"docs":{}},"o":{"df":0,"docs":{},"u":{"b":{"df":0,"docs":{},"l":{"df":0,"docs":{},"e":{"df":0,"docs":{},"s":{"df":0,"docs":{},"h":{"df":0,"docs":{},"o":{"df":0,"docs":{},"o":{"df":0,"docs":{},"t":{"df":1,"docs":{"51":{"tf":1.0}}}}}}}}}},"df":0,"docs":{}}}},"u":{"df":0,"docs":{},"n":{"df":0,"docs":{},"e":{"df":1,"docs":{"50":{"tf":1.4142135623730951}}}}}},"u":{"(":{"df":0,"docs":{},"t":{")":{"=":{"df":0,"docs":{},"k":{"df":0,"docs":{},"p":{"df":0,"docs":{},"":{"df":0,"docs":{},"⋅":{"df":0,"docs":{},"e":{"(":{"df":0,"docs":{},"t":{")":{"+":{"df":0,"docs":{},"k":{"df":0,"docs":{},"i":{"df":0,"docs":{},"":{"df":0,"docs":{},"⋅":{"df":0,"docs":{},"∫":{"df":0,"docs":{},"e":{"(":{"df":0,"docs":{},"t":{")":{"d":{"df":0,"docs":{},"t":{"+":{"df":0,"docs":{},"k":{"d":{"df":0,"docs":{},"":{"df":0,"docs":{},"⋅":{"d":{"df":0,"docs":{},"t":{"d":{"df":0,"docs":{},"e":{"(":{"df":0,"docs":{},"t":{"df":1,"docs":{"45":{"tf":1.0}}}},"df":0,"docs":{}}},"df":0,"docs":{}}},"df":0,"docs":{}}}},"df":0,"docs":{}}},"df":0,"docs":{}}},"df":0,"docs":{}},"df":0,"docs":{}}},"df":0,"docs":{}}}}}}}},"df":0,"docs":{}},"df":0,"docs":{}}},"df":0,"docs":{}}}}}}},"df":0,"docs":{}},"df":1,"docs":{"45":{"tf":1.0}}}},"a":{"df":0,"docs":{},"r":{"df":0,"docs":{},"t":{"df":1,"docs":{"28":{"tf":1.4142135623730951}}}}},"df":0,"docs":{},"i":{"df":1,"docs":{"50":{"tf":1.0}},"n":{"df":0,"docs":{},"t":{"3":{"2":{"_":{"df":0,"docs":{},"t":{")":{"(":{"(":{"df":0,"docs":{},"f":{"df":0,"docs":{},"l":{"df":0,"docs":{},"o":{"a":{"df":0,"docs":{},"t":{")":{"df":0,"docs":{},"p":{"df":0,"docs":{},"u":{"df":0,"docs":{},"l":{"df":0,"docs":{},"s":{"df":0,"docs":{},"e":{"df":0,"docs":{},"w":{"df":0,"docs":{},"i":{"d":{"df":0,"docs":{},"t":{"df":0,"docs":{},"h":{"df":1,"docs":{"37":{"tf":1.0}}}}},"df":0,"docs":{}}}}}}}}},"df":0,"docs":{}}},"df":0,"docs":{}}}}},"df":0,"docs":{}},"df":0,"docs":{}},"df":1,"docs":{"37":{"tf":1.4142135623730951}}}},"df":0,"docs":{}},"df":0,"docs":{}},"df":0,"docs":{}}}},"n":{"d":{"df":0,"docs":{},"e":{"df":0,"docs":{},"r":{"df":3,"docs":{"14":{"tf":1.0},"15":{"tf":1.0},"22":{"tf":1.0}},"s":{"df":0,"docs":{},"t":{"a":{"df":0,"docs":{},"n":{"d":{"df":2,"docs":{"11":{"tf":1.0},"9":{"tf":1.0}}},"df":0,"docs":{}}},"df":0,"docs":{}}}}}},"df":0,"docs":{},"e":{"df":0,"docs":{},"x":{"df":0,"docs":{},"p":{"df":0,"docs":{},"e":{"c":{"df":0,"docs":{},"t":{"df":1,"docs":{"50":{"tf":1.0}}}},"df":0,"docs":{}}}}},"i":{"df":0,"docs":{},"t":{"df":1,"docs":{"50":{"tf":1.4142135623730951}}}}},"p":{"d":{"a":{"df":0,"docs":{},"t":{"df":7,"docs":{"14":{"tf":1.0},"29":{"tf":1.0},"3":{"tf":1.4142135623730951},"31":{"tf":1.0},"32":{"tf":1.0},"33":{"tf":1.0},"37":{"tf":1.0}}}},"df":0,"docs":{}},"df":2,"docs":{"10":{"tf":1.0},"35":{"tf":1.0}}},"s":{"df":16,"docs":{"11":{"tf":1.4142135623730951},"14":{"tf":1.0},"2":{"tf":1.0},"21":{"tf":1.4142135623730951},"3":{"tf":1.7320508075688772},"35":{"tf":1.0},"36":{"tf":1.0},"37":{"tf":1.0},"40":{"tf":1.0},"44":{"tf":1.4142135623730951},"45":{"tf":1.0},"47":{"tf":1.0},"50":{"tf":1.4142135623730951},"51":{"tf":1.0},"6":{"tf":1.0},"9":{"tf":1.0}},"e":{"df":0,"docs":{},"r":{"df":1,"docs":{"50":{"tf":1.0}}}}},"t":{"df":0,"docs":{},"i":{"df":0,"docs":{},"l":{"df":1,"docs":{"44":{"tf":1.0}}}}}},"v":{"1":{"df":1,"docs":{"21":{"tf":1.0}}},"3":{"df":1,"docs":{"47":{"tf":1.0}}},"a":{"df":0,"docs":{},"l":{"df":0,"docs":{},"i":{"d":{"df":2,"docs":{"3":{"tf":1.0},"50":{"tf":1.0}}},"df":0,"docs":{}},"u":{"df":6,"docs":{"14":{"tf":1.4142135623730951},"21":{"tf":1.0},"39":{"tf":1.0},"45":{"tf":1.0},"50":{"tf":1.7320508075688772},"51":{"tf":1.0}}}},"r":{"df":0,"docs":{},"i":{"df":0,"docs":{},"o":{"df":0,"docs":{},"u":{"df":1,"docs":{"15":{"tf":1.0}}}}}}},"df":0,"docs":{},"e":{"df":0,"docs":{},"l":{"df":0,"docs":{},"o":{"c":{"df":2,"docs":{"44":{"tf":1.7320508075688772},"50":{"tf":1.0}}},"df":0,"docs":{}}},"r":{"b":{"df":0,"docs":{},"o":{"df":0,"docs":{},"s":{"df":1,"docs":{"51":{"tf":1.0}}}}},"df":0,"docs":{},"i":{"df":0,"docs":{},"f":{"df":0,"docs":{},"i":{"df":9,"docs":{"14":{"tf":1.4142135623730951},"29":{"tf":1.0},"3":{"tf":1.0},"32":{"tf":1.4142135623730951},"33":{"tf":1.0},"35":{"tf":1.0},"50":{"tf":1.7320508075688772},"51":{"tf":1.0},"52":{"tf":1.0}}}}}}},"i":{"df":0,"docs":{},"s":{"df":0,"docs":{},"i":{"df":0,"docs":{},"t":{"df":1,"docs":{"5":{"tf":1.0}}}},"u":{"a":{"df":0,"docs":{},"l":{"df":1,"docs":{"3":{"tf":1.0}}}},"df":0,"docs":{}}}},"o":{"df":0,"docs":{},"i":{"d":{"df":1,"docs":{"37":{"tf":1.0}}},"df":0,"docs":{}},"l":{"df":0,"docs":{},"t":{"a":{"df":0,"docs":{},"g":{"df":2,"docs":{"14":{"tf":1.7320508075688772},"15":{"tf":1.0}}}},"df":0,"docs":{}}},"u":{"df":0,"docs":{},"t":{"df":1,"docs":{"14":{"tf":1.0}},"":{"=":{"1":{".":{"2":{"df":0,"docs":{},"×":{"(":{"1":{"+":{"df":0,"docs":{},"r":{"1":{"df":0,"docs":{},"":{"df":0,"docs":{},"r":{"2":{"df":1,"docs":{"14":{"tf":1.0}}},"df":0,"docs":{}}}},"df":0,"docs":{}}},"df":0,"docs":{}},"df":0,"docs":{}},"df":0,"docs":{}}},"df":0,"docs":{}},"df":0,"docs":{}},"df":0,"docs":{}},"df":0,"docs":{}}}}},"x":{"df":1,"docs":{"44":{"tf":1.0}}},"y":{"df":1,"docs":{"44":{"tf":1.0}}}},"w":{"a":{"df":0,"docs":{},"n":{"df":0,"docs":{},"t":{"df":1,"docs":{"6":{"tf":1.0}}}},"s":{"df":0,"docs":{},"n":{"'":{"df":0,"docs":{},"t":{"df":1,"docs":{"10":{"tf":1.4142135623730951}}}},"df":0,"docs":{}}},"v":{"df":0,"docs":{},"e":{"df":0,"docs":{},"f":{"df":0,"docs":{},"o":{"df":0,"docs":{},"r":{"df":0,"docs":{},"m":{"df":1,"docs":{"32":{"tf":1.0}}}}}}}}},"df":0,"docs":{},"e":{"a":{"df":0,"docs":{},"k":{"df":1,"docs":{"50":{"tf":1.0}}}},"b":{"_":{"df":0,"docs":{},"s":{"df":0,"docs":{},"e":{"df":0,"docs":{},"r":{"df":0,"docs":{},"v":{"df":0,"docs":{},"e":{"df":0,"docs":{},"r":{".":{"c":{"df":0,"docs":{},"p":{"df":0,"docs":{},"p":{"df":1,"docs":{"50":{"tf":1.0}}}}},"df":0,"docs":{}},"df":0,"docs":{}}}}}}}},"df":6,"docs":{"21":{"tf":1.4142135623730951},"22":{"tf":1.0},"24":{"tf":1.0},"49":{"tf":1.0},"50":{"tf":2.0},"9":{"tf":1.0}}},"df":0,"docs":{},"e":{"df":0,"docs":{},"k":{"'":{"df":1,"docs":{"47":{"tf":1.0}}},"df":4,"docs":{"0":{"tf":1.0},"2":{"tf":1.4142135623730951},"21":{"tf":1.4142135623730951},"36":{"tf":1.0}}}},"i":{"df":0,"docs":{},"g":{"df":0,"docs":{},"h":{"df":0,"docs":{},"t":{"df":1,"docs":{"32":{"tf":1.0}}}}}},"n":{"df":0,"docs":{},"t":{"df":1,"docs":{"1":{"tf":1.0}}}}},"h":{"df":0,"docs":{},"e":{"df":0,"docs":{},"e":{"df":0,"docs":{},"l":{"b":{"a":{"df":0,"docs":{},"s":{"df":2,"docs":{"44":{"tf":1.0},"50":{"tf":1.0}}}},"df":0,"docs":{}},"df":6,"docs":{"32":{"tf":1.0},"44":{"tf":2.0},"50":{"tf":1.4142135623730951},"51":{"tf":1.0},"52":{"tf":1.0},"6":{"tf":1.4142135623730951}},"l":{"df":0,"docs":{},"i":{"df":0,"docs":{},"n":{"df":0,"docs":{},"e":{"a":{"df":0,"docs":{},"r":{"df":0,"docs":{},"s":{"df":0,"docs":{},"p":{"df":0,"docs":{},"e":{"df":0,"docs":{},"e":{"d":{"df":0,"docs":{},"s":{"[":{"df":0,"docs":{},"i":{"]":{"=":{"df":0,"docs":{},"v":{"df":0,"docs":{},"x":{"df":0,"docs":{},"":{"df":0,"docs":{},"⋅":{"df":0,"docs":{},"s":{"df":0,"docs":{},"i":{"df":0,"docs":{},"n":{"(":{"df":0,"docs":{},"θ":{"df":0,"docs":{},"i":{"df":0,"docs":{},"":{")":{"+":{"df":0,"docs":{},"v":{"df":0,"docs":{},"y":{"df":0,"docs":{},"":{"df":0,"docs":{},"⋅":{"c":{"df":0,"docs":{},"o":{"df":0,"docs":{},"s":{"(":{"df":0,"docs":{},"θ":{"df":0,"docs":{},"i":{"df":0,"docs":{},"":{")":{"+":{"df":0,"docs":{},"ω":{"df":0,"docs":{},"⋅":{"df":0,"docs":{},"r":{"df":1,"docs":{"44":{"tf":1.0}}}}}},"df":0,"docs":{}},"df":0,"docs":{}}}}},"df":0,"docs":{}}}},"df":0,"docs":{}}}}}},"df":0,"docs":{}},"df":0,"docs":{}}}}},"df":0,"docs":{}}}}}}}}},"df":0,"docs":{}},"df":0,"docs":{}}},"df":0,"docs":{}}},"df":0,"docs":{}}}}}}},"df":0,"docs":{}}}}},"s":{"df":0,"docs":{},"p":{"df":0,"docs":{},"e":{"df":1,"docs":{"50":{"tf":1.0}},"e":{"d":{"df":0,"docs":{},"s":{"[":{"df":0,"docs":{},"i":{"]":{"=":{"df":0,"docs":{},"ω":{"df":0,"docs":{},"w":{"df":0,"docs":{},"h":{"df":0,"docs":{},"e":{"df":0,"docs":{},"e":{"df":0,"docs":{},"l":{"df":0,"docs":{},"":{"df":0,"docs":{},"⋅":{"2":{"df":0,"docs":{},"π":{"6":{"0":{"df":1,"docs":{"44":{"tf":1.0}}},"df":0,"docs":{}},"df":0,"docs":{}}},"df":0,"docs":{}}}}}}}}}},"df":0,"docs":{}},"df":0,"docs":{}}},"df":0,"docs":{}}},"df":0,"docs":{}}}}},"":{"=":{"2":{"d":{"df":0,"docs":{},"":{"df":0,"docs":{},"w":{"df":0,"docs":{},"h":{"df":0,"docs":{},"e":{"df":0,"docs":{},"e":{"df":0,"docs":{},"l":{"df":0,"docs":{},"l":{"df":0,"docs":{},"i":{"df":0,"docs":{},"n":{"df":0,"docs":{},"e":{"a":{"df":0,"docs":{},
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
