mjpaul3/Portable-Plotter-Robot/(commit log)

2024-12-12 added folder structure and Kicad files
    [BMI323.step, CP2102N-A02-GQFN28.step, PJ-102AH.step, WCAP-ATG5_5X11.step, portable-plotter-robot.kicad_pcb, portable-plotter-robot.kicad_sch]
2024-12-12 ESP32 repo added as submodule
2024-12-12 Added Sagnik3's notebook docs (mdbook)
    [searchindex.js]
